stefan-R75/STM32-Nucleo-RS232-RS485-Expansion-Board-ST-Zio-and-Arduino-Compatible/04-Pictures/3D_Render_1.jpg

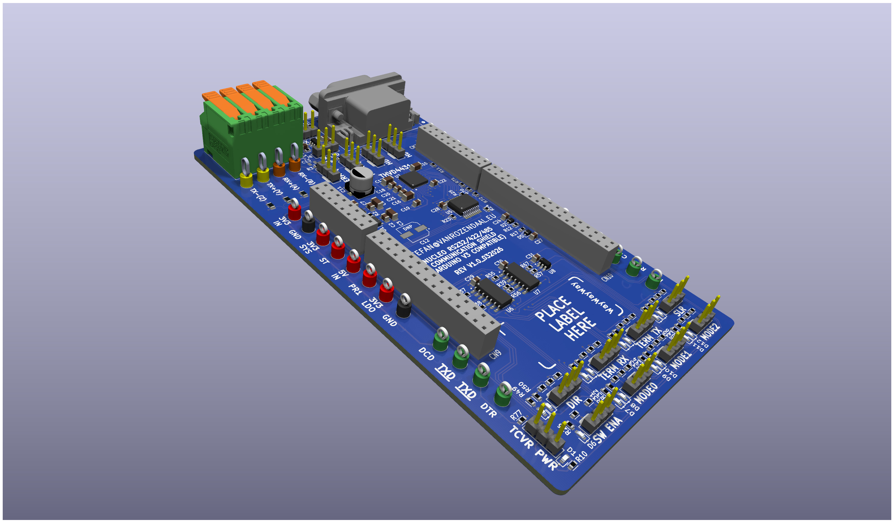
04-Pictures/3D_Render_1.jpg
