stefan-R75/STM32-Nucleo-RS232-RS485-Expansion-Board-ST-Zio-and-Arduino-Compatible/01_KiCAD/06_design_rules/01_jlcpcb/README.md

<!DOCTYPE html>
<html
  lang="en"
  
  data-color-mode="auto" data-light-theme="light" data-dark-theme="dark"
  data-a11y-animated-images="system" data-a11y-link-underlines="true"
  
  >

    <style>
:root {
  --fontStack-monospace: "Monaspace Neon", ui-monospace, SFMono-Regular, SF Mono, Menlo, Consolas, Liberation Mono, monospace !important;
}
</style>

  <head>
    <meta charset="utf-8">
  <link rel="dns-prefetch" href="https://github.githubassets.com">
  <link rel="dns-prefetch" href="https://avatars.githubusercontent.com">
  <link rel="dns-prefetch" href="https://github-cloud.s3.amazonaws.com">
  <link rel="dns-prefetch" href="https://user-images.githubusercontent.com/">
  <link rel="preconnect" href="https://github.githubassets.com" crossorigin>
  <link rel="preconnect" href="https://avatars.githubusercontent.com">

  <link crossorigin="anonymous" media="all" rel="stylesheet" href="https://github.githubassets.com/assets/light-7a548c73f231168f.css" /><link crossorigin="anonymous" media="all" rel="stylesheet" href="https://github.githubassets.com/assets/dark-a037c5198a3956d3.css" /><link data-color-theme="light_high_contrast" crossorigin="anonymous" media="all" rel="stylesheet" data-href="https://github.githubassets.com/assets/light_high_contrast-6d5205ba83e64657.css" /><link data-color-theme="light_colorblind" crossorigin="anonymous" media="all" rel="stylesheet" data-href="https://github.githubassets.com/assets/light_colorblind-92d1f03520a71f42.css" /><link data-color-theme="light_colorblind_high_contrast" crossorigin="anonymous" media="all" rel="stylesheet" data-href="https://github.githubassets.com/assets/light_colorblind_high_contrast-df96da265a7bd744.css" /><link data-color-theme="light_tritanopia" crossorigin="anonymous" media="all" rel="stylesheet" data-href="https://github.githubassets.com/assets/light_tritanopia-6db3b080ed072628.css" /><link data-color-theme="light_tritanopia_high_contrast" crossorigin="anonymous" media="all" rel="stylesheet" data-href="https://github.githubassets.com/assets/light_tritanopia_high_contrast-90fe1d4276b4e140.css" /><link data-color-theme="dark_high_contrast" crossorigin="anonymous" media="all" rel="stylesheet" data-href="https://github.githubassets.com/assets/dark_high_contrast-c4cd957551b6a79f.css" /><link data-color-theme="dark_colorblind" crossorigin="anonymous" media="all" rel="stylesheet" data-href="https://github.githubassets.com/assets/dark_colorblind-07a599f014ccb7af.css" /><link data-color-theme="dark_colorblind_high_contrast" crossorigin="anonymous" media="all" rel="stylesheet" data-href="https://github.githubassets.com/assets/dark_colorblind_high_contrast-c82f4bc8e6fa1496.css" /><link data-color-theme="dark_tritanopia" crossorigin="anonymous" media="all" rel="stylesheet" data-href="https://github.githubassets.com/assets/dark_tritanopia-c7f850982eb2d6ef.css" /><link data-color-theme="dark_tritanopia_high_contrast" crossorigin="anonymous" media="all" rel="stylesheet" data-href="https://github.githubassets.com/assets/dark_tritanopia_high_contrast-bb5b3e819015bc33.css" /><link data-color-theme="dark_dimmed" crossorigin="anonymous" media="all" rel="stylesheet" data-href="https://github.githubassets.com/assets/dark_dimmed-5371e55576aee699.css" /><link data-color-theme="dark_dimmed_high_contrast" crossorigin="anonymous" media="all" rel="stylesheet" data-href="https://github.githubassets.com/assets/dark_dimmed_high_contrast-4db2d2a5d2d86648.css" />

  <style type="text/css">
    :root {
      --tab-size-preference: 4;
    }

    pre, code {
      tab-size: var(--tab-size-preference);
    }
  </style>

    <link crossorigin="anonymous" media="all" rel="stylesheet" href="https://github.githubassets.com/assets/primer-primitives-2c5f58bae956fa96.css" />
    <link crossorigin="anonymous" media="all" rel="stylesheet" href="https://github.githubassets.com/assets/primer-b97936554294d7a3.css" />
    <link crossorigin="anonymous" media="all" rel="stylesheet" href="https://github.githubassets.com/assets/global-5d300701a37a830a.css" />
    <link crossorigin="anonymous" media="all" rel="stylesheet" href="https://github.githubassets.com/assets/github-294399c8d5b652c5.css" />
  <link crossorigin="anonymous" media="all" rel="stylesheet" href="https://github.githubassets.com/assets/repository-c2a686ef3f37f3e5.css" />
<link crossorigin="anonymous" media="all" rel="stylesheet" href="https://github.githubassets.com/assets/code-67953c77b47fec3b.css" />

  <script type="application/json" id="client-env">{"locale":"en","featureFlags":["a11y_status_checks_ruleset","action_yml_language_service","actions_custom_images_public_preview_visibility","actions_custom_images_storage_billing_ui_visibility","actions_enable_snapshot_keyword","actions_image_version_event","actions_workflow_language_service","actions_workflow_language_service_allow_case_function","agent_session_retry_fetch_capi_on_401","alternate_user_config_repo","api_insights_show_missing_data_banner","arianotify_comprehensive_migration","batch_suggested_changes","billing_hard_budget_limits_for_licenses","billing_ui_budget_pagination_enabled","codeowners_validation_in_diff","codespaces_prebuild_region_target_update","coding_agent_model_selection","copilot_3p_agent_hovercards","copilot_agent_sessions_alive_updates","copilot_agent_task_list_v2","copilot_agent_task_submit_with_modifier","copilot_agent_tasks_btn_code_nav","copilot_agent_tasks_btn_code_view","copilot_agent_tasks_btn_code_view_lines","copilot_agent_tasks_btn_repo","copilot_api_agentic_issue_marshal_yaml","copilot_ask_mode_dropdown","copilot_capi_error_response_telemetry","copilot_chat_attach_multiple_images","copilot_chat_clear_model_selection_for_default_change","copilot_chat_disable_model_picker_while_streaming","copilot_chat_enable_tool_call_logs","copilot_chat_file_redirect","copilot_chat_input_commands","copilot_chat_opening_thread_switch","copilot_chat_reduce_quota_checks","copilot_chat_repository_picker","copilot_chat_search_bar_redirect","copilot_chat_selection_attachments","copilot_chat_vision_in_claude","copilot_chat_vision_preview_gate","copilot_coding_agent_free_users_exp","copilot_coding_agent_task_response","copilot_custom_copilots","copilot_custom_copilots_feature_preview","copilot_duplicate_thread","copilot_extensions_hide_in_dotcom_chat","copilot_extensions_removal_on_marketplace","copilot_features_raycast_logo","copilot_features_sql_server_logo","copilot_features_zed_logo","copilot_file_block_ref_matching","copilot_ftp_hyperspace_upgrade_prompt","copilot_icebreakers_experiment_dashboard","copilot_icebreakers_experiment_hyperspace","copilot_immersive_job_result_preview","copilot_immersive_structured_model_picker","copilot_immersive_task_hyperlinking","copilot_immersive_task_within_chat_thread","copilot_issue_list_show_more","copilot_mc_cli_resume_any_users_task","copilot_org_policy_page_focus_mode","copilot_premium_request_quotas","copilot_redirect_header_button_to_agents","copilot_security_alert_assignee_options","copilot_share_active_subthread","copilot_spaces_ga","copilot_spaces_individual_policies_ga","copilot_spaces_pagination","copilot_spaces_server_side_menu_actions","copilot_spark_empty_state","copilot_spark_handle_nil_friendly_name","copilot_stable_conversation_view","copilot_swe_agent_use_subagents","copilot_unconfigured_is_inherited","custom_instructions_file_references","custom_properties_consolidate_default_value_input","dashboard_indexeddb_caching","dashboard_lists_max_age_filter","dashboard_universe_2025","dashboard_universe_2025_feedback_dialog","disable_turbo_visit","dom_node_counts","enterprise_ai_controls","failbot_report_error_react_apps_on_page","fgpat_permissions_selector_redesign","file_finder_skip_debounce","flex_cta_groups_mvp","github_models_scheduled_hydro_events","global_nav_react","hide_groups_list_for_few_groups","hyperspace_2025_logged_out_batch_1","hyperspace_2025_logged_out_batch_2","initial_per_page_pagination_updates","issue_comment_pinning","issue_fields_compact_view","issue_fields_global_search","issue_fields_report_usage","issue_fields_timeline_events","issues_cca_assign_actor_with_agent","issues_expanded_file_types","issues_index_semantic_search","issues_lazy_load_comment_box_suggestions","issues_react_auto_retry_on_error","issues_react_bots_timeline_pagination","issues_react_chrome_container_query_fix","issues_react_custom_hpc_metric","issues_react_include_bots_in_pickers","issues_react_low_quality_comment_warning","issues_react_prohibit_title_fallback","issues_react_resource_metrics","issues_react_safari_scroll_preservation","issues_react_ui_feedback","issues_react_use_turbo_for_cross_repo_navigation","issues_report_sidebar_interactions","landing_pages_ninetailed","lifecycle_label_name_updates","marketing_pages_search_explore_provider","memex_default_issue_create_repository","memex_display_button_config_menu","memex_grouped_by_edit_route","memex_live_update_hovercard","memex_mwl_filter_field_delimiter","memex_roadmap_drag_style","mission_control_retry_on_401","mission_control_use_body_html","open_agent_session_in_vscode_insiders","open_agent_session_in_vscode_stable","pr_sfv_new_diff_fetch","primer_react_css_has_selector_perf","projects_assignee_max_limit","prs_conversations_react","pull_request_files_accurate_size_estimates","pull_request_files_virtualization","pull_request_virtualization_preload_diffs","react_quality_profiling","repo_picker_client_caching","repository_suggester_elastic_search","ruleset_deletion_confirmation","sample_network_conn_type","session_logs_ungroup_reasoning_text","site_calculator_actions_2025","site_features_copilot_universe","site_homepage_collaborate_video","spark_prompt_secret_scanning","spark_server_connection_status","suppress_automated_browser_vitals","suppress_non_representative_vitals","swe_agent_member_requests","swe_agent_member_requests_agent_panel","viewscreen_sandbox","webp_support","workbench_store_readonly"],"login":"stefan-R75","copilotApiOverrideUrl":"https://api.individual.githubcopilot.com"}</script>
<script crossorigin="anonymous" type="module" src="https://github.githubassets.com/assets/wp-runtime-a365739c073e005e.js" defer="defer"></script>
<script crossorigin="anonymous" type="module" src="https://github.githubassets.com/assets/19762-81d8d5b6d1548747.js" defer="defer"></script>
<script crossorigin="anonymous" type="module" src="https://github.githubassets.com/assets/49863-4976e709f3e70037.js" defer="defer"></script>
<script crossorigin="anonymous" type="module" src="https://github.githubassets.com/assets/22060-65b6ab518146f610.js" defer="defer"></script>
<script crossorigin="anonymous" type="module" src="https://github.githubassets.com/assets/environment-a51d75132b05ab62.js" defer="defer"></script>
<script crossorigin="anonymous" type="module" src="https://github.githubassets.com/assets/2966-17a81e258d07c2f2.js" defer="defer"></script>
<script crossorigin="anonymous" type="module" src="https://github.githubassets.com/assets/96232-b9d545f230321d7c.js" defer="defer"></script>
<script crossorigin="anonymous" type="module" src="https://github.githubassets.com/assets/41013-a3ad6242e7f8e42a.js" defer="defer"></script>
<script crossorigin="anonymous" type="module" src="https://github.githubassets.com/assets/51210-6b5503327f030bf0.js" defer="defer"></script>
<script crossorigin="anonymous" type="module" src="https://github.githubassets.com/assets/41121-687180e90512ebb8.js" defer="defer"></script>
<script crossorigin="anonymous" type="module" src="https://github.githubassets.com/assets/2302-893769a03771e2b9.js" defer="defer"></script>
<script crossorigin="anonymous" type="module" src="https://github.githubassets.com/assets/46740-4a90f6808789c7e0.js" defer="defer"></script>
<script crossorigin="anonymous" type="module" src="https://github.githubassets.com/assets/20425-e0dc13f26c8ee149.js" defer="defer"></script>
<script crossorigin="anonymous" type="module" src="https://github.githubassets.com/assets/github-elements-47afb2cc6f88f2ab.js" defer="defer"></script>
<script crossorigin="anonymous" type="module" src="https://github.githubassets.com/assets/element-registry-00d059a39bc367bc.js" defer="defer"></script>
<script crossorigin="anonymous" type="module" src="https://github.githubassets.com/assets/react-core-9e65dba44886edf0.js" defer="defer"></script>
<script crossorigin="anonymous" type="module" src="https://github.githubassets.com/assets/react-lib-2f71bc80da1778d4.js" defer="defer"></script>
<script crossorigin="anonymous" type="module" src="https://github.githubassets.com/assets/7053-ac767626dd950bdd.js" defer="defer"></script>
<script crossorigin="anonymous" type="module" src="https://github.githubassets.com/assets/79039-9993689954cc2834.js" defer="defer"></script>
<script crossorigin="anonymous" type="module" src="https://github.githubassets.com/assets/61110-4d1f28b4f7de000b.js" defer="defer"></script>
<script crossorigin="anonymous" type="module" src="https://github.githubassets.com/assets/2887-e2ef3aca87cf3cff.js" defer="defer"></script>
<script crossorigin="anonymous" type="module" src="https://github.githubassets.com/assets/26533-62506039554211c5.js" defer="defer"></script>
<script crossorigin="anonymous" type="module" src="https://github.githubassets.com/assets/62249-3d8ecc3d46f0dc4a.js" defer="defer"></script>
<script crossorigin="anonymous" type="module" src="https://github.githubassets.com/assets/16674-c6884f27fffb8eee.js" defer="defer"></script>
<script crossorigin="anonymous" type="module" src="https://github.githubassets.com/assets/55821-8df7f70f24788ba2.js" defer="defer"></script>
<script crossorigin="anonymous" type="module" src="https://github.githubassets.com/assets/84184-d5f38c738dddc6e7.js" defer="defer"></script>
<script crossorigin="anonymous" type="module" src="https://github.githubassets.com/assets/91160-58ac38733522873c.js" defer="defer"></script>
<script crossorigin="anonymous" type="module" src="https://github.githubassets.com/assets/68160-4d147b4adc4e3757.js" defer="defer"></script>
<script crossorigin="anonymous" type="module" src="https://github.githubassets.com/assets/34391-4b927fa8f60ebdd2.js" defer="defer"></script>
<script crossorigin="anonymous" type="module" src="https://github.githubassets.com/assets/64453-778588b08614a898.js" defer="defer"></script>
<script crossorigin="anonymous" type="module" src="https://github.githubassets.com/assets/behaviors-49e32172e06825b6.js" defer="defer"></script>
<script crossorigin="anonymous" type="module" src="https://github.githubassets.com/assets/20475-125b055bc62d02e3.js" defer="defer"></script>
<script crossorigin="anonymous" type="module" src="https://github.githubassets.com/assets/notifications-global-9526169739e19e0a.js" defer="defer"></script>
<script crossorigin="anonymous" type="module" src="https://github.githubassets.com/assets/76181-bad0aa2ff68caeb2.js" defer="defer"></script>
<script crossorigin="anonymous" type="module" src="https://github.githubassets.com/assets/code-menu-14eaaf06a02cae17.js" defer="defer"></script>
  
  <script crossorigin="anonymous" type="module" src="https://github.githubassets.com/assets/primer-react-bd93e22e75e0b7a2.js" defer="defer"></script>
<script crossorigin="anonymous" type="module" src="https://github.githubassets.com/assets/octicons-react-f88f2996e968d31d.js" defer="defer"></script>
<script crossorigin="anonymous" type="module" src="https://github.githubassets.com/assets/59660-74e5b93a98c36f57.js" defer="defer"></script>
<script crossorigin="anonymous" type="module" src="https://github.githubassets.com/assets/73694-4020602e6b8b6e13.js" defer="defer"></script>
<script crossorigin="anonymous" type="module" src="https://github.githubassets.com/assets/68751-1d7b85d6d952dbeb.js" defer="defer"></script>
<script crossorigin="anonymous" type="module" src="https://github.githubassets.com/assets/42688-ce4eea125110d8c4.js" defer="defer"></script>
<script crossorigin="anonymous" type="module" src="https://github.githubassets.com/assets/15272-0e93006cf5d4b667.js" defer="defer"></script>
<script crossorigin="anonymous" type="module" src="https://github.githubassets.com/assets/7463-f3550706c43a8cd5.js" defer="defer"></script>
<script crossorigin="anonymous" type="module" src="https://github.githubassets.com/assets/32769-d7b78ad1b9c022ed.js" defer="defer"></script>
<script crossorigin="anonymous" type="module" src="https://github.githubassets.com/assets/437-b726f2206404264f.js" defer="defer"></script>
<script crossorigin="anonymous" type="module" src="https://github.githubassets.com/assets/47857-a5fc3b92dbb7278c.js" defer="defer"></script>
<script crossorigin="anonymous" type="module" src="https://github.githubassets.com/assets/58110-ef430145b4fc3b77.js" defer="defer"></script>
<script crossorigin="anonymous" type="module" src="https://github.githubassets.com/assets/18549-fb0f941364febc57.js" defer="defer"></script>
<script crossorigin="anonymous" type="module" src="https://github.githubassets.com/assets/97083-8d6325e76f8402c7.js" defer="defer"></script>
<script crossorigin="anonymous" type="module" src="https://github.githubassets.com/assets/77691-091e7e8d11233aa1.js" defer="defer"></script>
<script crossorigin="anonymous" type="module" src="https://github.githubassets.com/assets/46376-21b0e1dc12f92ddb.js" defer="defer"></script>
<script crossorigin="anonymous" type="module" src="https://github.githubassets.com/assets/6102-23ba622d2360462d.js" defer="defer"></script>
<script crossorigin="anonymous" type="module" src="https://github.githubassets.com/assets/84085-4bff88a8b3cf217b.js" defer="defer"></script>
<script crossorigin="anonymous" type="module" src="https://github.githubassets.com/assets/82048-6f4561ed285c5d22.js" defer="defer"></script>
<script crossorigin="anonymous" type="module" src="https://github.githubassets.com/assets/99028-9e8e295ec8de3c0a.js" defer="defer"></script>
<script crossorigin="anonymous" type="module" src="https://github.githubassets.com/assets/81482-5951601d24d6ec3f.js" defer="defer"></script>
<script crossorigin="anonymous" type="module" src="https://github.githubassets.com/assets/32288-2b443a3b5410e033.js" defer="defer"></script>
<script crossorigin="anonymous" type="module" src="https://github.githubassets.com/assets/78967-f3b25a47b1862381.js" defer="defer"></script>
<script crossorigin="anonymous" type="module" src="https://github.githubassets.com/assets/69395-61f7f68481a24cfa.js" defer="defer"></script>
<script crossorigin="anonymous" type="module" src="https://github.githubassets.com/assets/51705-9c9f7530ce22860c.js" defer="defer"></script>
<script crossorigin="anonymous" type="module" src="https://github.githubassets.com/assets/23270-caee1ec46352845c.js" defer="defer"></script>
<script crossorigin="anonymous" type="module" src="https://github.githubassets.com/assets/21463-1024f763b5e922f3.js" defer="defer"></script>
<script crossorigin="anonymous" type="module" src="https://github.githubassets.com/assets/67894-d761b3666444400a.js" defer="defer"></script>
<script crossorigin="anonymous" type="module" src="https://github.githubassets.com/assets/64899-bf6a14d23de43ea4.js" defer="defer"></script>
<script crossorigin="anonymous" type="module" src="https://github.githubassets.com/assets/15460-51599d3455597c0b.js" defer="defer"></script>
<script crossorigin="anonymous" type="module" src="https://github.githubassets.com/assets/50343-6db70a288422cd9d.js" defer="defer"></script>
<script crossorigin="anonymous" type="module" src="https://github.githubassets.com/assets/10870-ee22522d2567012c.js" defer="defer"></script>
<script crossorigin="anonymous" type="module" src="https://github.githubassets.com/assets/16920-bd17157a7dc06d8a.js" defer="defer"></script>
<script crossorigin="anonymous" type="module" src="https://github.githubassets.com/assets/react-code-view-a38e5fae44e32b01.js" defer="defer"></script>
<link crossorigin="anonymous" media="all" rel="stylesheet" href="https://github.githubassets.com/assets/primer-react.2b2a53c0ee686cca.module.css" />
<link crossorigin="anonymous" media="all" rel="stylesheet" href="https://github.githubassets.com/assets/16920.2b8819cf0686bcce.module.css" />
<link crossorigin="anonymous" media="all" rel="stylesheet" href="https://github.githubassets.com/assets/react-code-view.1fa961d2ce6eca73.module.css" />

  <title>KiCad-DesignRules/JLCPCB/README.md at main · labtroll/KiCad-DesignRules</title>

  <meta name="route-pattern" content="/:user_id/:repository/blob/*name(/*path)" data-turbo-transient>
  <meta name="route-controller" content="blob" data-turbo-transient>
  <meta name="route-action" content="show" data-turbo-transient>
  <meta name="fetch-nonce" content="v2:77e527d9-4628-d5ec-2935-2bac5924399e">

  <meta name="current-catalog-service-hash" content="f3abb0cc802f3d7b95fc8762b94bdcb13bf39634c40c357301c4aa1d67a256fb">

  <meta name="request-id" content="29DA:105EAB:24193A9:1BFB843:6988A18A" data-turbo-transient="true" /><meta name="html-safe-nonce" content="44650263f7b207255abc338ca9ca1fe72b3509a761cd1f3fd2103b169035779b" data-turbo-transient="true" /><meta name="visitor-payload" content="eyJyZWZlcnJlciI6bnVsbCwicmVxdWVzdF9pZCI6IjI5REE6MTA1RUFCOjI0MTkzQTk6MUJGQjg0Mzo2OTg4QTE4QSIsInZpc2l0b3JfaWQiOiI3OTQ4NTI3NTQ5MzEyMTA3MTY3IiwicmVnaW9uX2VkZ2UiOiJmcmEiLCJyZWdpb25fcmVuZGVyIjoiaWFkIn0=" data-turbo-transient="true" /><meta name="visitor-hmac" content="4d92192ea0aa14b43ddfdb597fb6b93d4a2d25d4c0c42d353baec3ecd39639f1" data-turbo-transient="true" />

    <meta name="hovercard-subject-tag" content="repository:707325958" data-turbo-transient>

  <meta name="github-keyboard-shortcuts" content="repository,source-code,file-tree,copilot" data-turbo-transient="true" />

  <meta name="selected-link" value="repo_source" data-turbo-transient>
  <link rel="assets" href="https://github.githubassets.com/">

    <meta name="google-site-verification" content="Apib7-x98H0j5cPqHWwSMm6dNU4GmODRoqxLiDzdx9I">

<meta name="octolytics-url" content="https://collector.github.com/github/collect" /><meta name="octolytics-actor-id" content="143539033" /><meta name="octolytics-actor-login" content="stefan-R75" /><meta name="octolytics-actor-hash" content="dad007f8bda0fbb8aeee6f8d2f37120cbe373ef1ef59173fdea4cbeae251cd0e" />

  <meta name="analytics-location" content="/&lt;user-name&gt;/&lt;repo-name&gt;/blob/show" data-turbo-transient="true" />

    <meta name="user-login" content="stefan-R75">

  <link rel="sudo-modal" href="/sessions/sudo_modal">

    <meta name="viewport" content="width=device-width">

      <meta name="description" content="JLCPCB Design Rules implemented as Custom Rules in a .kicad_dru file - KiCad-DesignRules/JLCPCB/README.md at main · labtroll/KiCad-DesignRules">

      <link rel="search" type="application/opensearchdescription+xml" href="/opensearch.xml" title="GitHub">

    <link rel="fluid-icon" href="https://github.com/fluidicon.png" title="GitHub">
    <meta property="fb:app_id" content="1401488693436528">
    <meta name="apple-itunes-app" content="app-id=1477376905, app-argument=https://github.com/labtroll/KiCad-DesignRules/blob/main/JLCPCB/README.md" />

      <meta name="twitter:image" content="https://opengraph.githubassets.com/c485022d63268e68967d5fdd4d90edf50c94739bc805dd78f24c9c485822f8bf/labtroll/KiCad-DesignRules" /><meta name="twitter:site" content="@github" /><meta name="twitter:card" content="summary_large_image" /><meta name="twitter:title" content="KiCad-DesignRules/JLCPCB/README.md at main · labtroll/KiCad-DesignRules" /><meta name="twitter:description" content="JLCPCB Design Rules implemented as Custom Rules in a .kicad_dru file - labtroll/KiCad-DesignRules" />
  <meta property="og:image" content="https://opengraph.githubassets.com/c485022d63268e68967d5fdd4d90edf50c94739bc805dd78f24c9c485822f8bf/labtroll/KiCad-DesignRules" /><meta property="og:image:alt" content="JLCPCB Design Rules implemented as Custom Rules in a .kicad_dru file - labtroll/KiCad-DesignRules" /><meta property="og:image:width" content="1200" /><meta property="og:image:height" content="600" /><meta property="og:site_name" content="GitHub" /><meta property="og:type" content="object" /><meta property="og:title" content="KiCad-DesignRules/JLCPCB/README.md at main · labtroll/KiCad-DesignRules" /><meta property="og:url" content="https://github.com/labtroll/KiCad-DesignRules/blob/main/JLCPCB/README.md" /><meta property="og:description" content="JLCPCB Design Rules implemented as Custom Rules in a .kicad_dru file - labtroll/KiCad-DesignRules" />

      <link rel="shared-web-socket" href="wss://alive.github.com/_sockets/u/143539033/ws?session=eyJ2IjoiVjMiLCJ1IjoxNDM1MzkwMzMsInMiOjE5NTgxMDQ5ODUsImMiOjY2NTMyNTI4MiwidCI6MTc3MDU2MTkzOX0=--2d488f9127d47159ba9c84ce60b51c6318aac336dd77a62158bb0e0a54b522e5" data-refresh-url="/_alive" data-session-id="aa5893bf591d7a5fc4c6648f3ebbf1db6b44a33b65be285162e9d33f139651c2">
      <link rel="shared-web-socket-src" href="/assets-cdn/worker/socket-worker-f5e0d666a0d1de44.js">

      <meta name="hostname" content="github.com">

      <meta name="keyboard-shortcuts-preference" content="all">
      <meta name="hovercards-preference" content="true">
      <meta name="announcement-preference-hovercard" content="true">

        <meta name="expected-hostname" content="github.com">

  <meta http-equiv="x-pjax-version" content="8ceba48c6a92197c529f47d4f9d45b0b8bc17cf70fdee20196e8a93f9146e912" data-turbo-track="reload">
  <meta http-equiv="x-pjax-csp-version" content="21a43568025709b66240454fc92d4f09335a96863f8ab1c46b4a07f6a5b67102" data-turbo-track="reload">
  <meta http-equiv="x-pjax-css-version" content="7bded8bde79b87d1ddc3c19f5a21b028d09775106bcb77cfabea9853ea14a4eb" data-turbo-track="reload">
  <meta http-equiv="x-pjax-js-version" content="38ec31e8cc99e2ff9dfdb8f1c79b44d05e5fce45b7e96adc4250ef0059f0eb28" data-turbo-track="reload">

  <meta name="turbo-cache-control" content="no-preview" data-turbo-transient="">

      <meta name="turbo-cache-control" content="no-cache" data-turbo-transient>

    <meta data-hydrostats="publish">

  <meta name="go-import" content="github.com/labtroll/KiCad-DesignRules git https://github.com/labtroll/KiCad-DesignRules.git">

  <meta name="octolytics-dimension-user_id" content="147919420" /><meta name="octolytics-dimension-user_login" content="labtroll" /><meta name="octolytics-dimension-repository_id" content="707325958" /><meta name="octolytics-dimension-repository_nwo" content="labtroll/KiCad-DesignRules" /><meta name="octolytics-dimension-repository_public" content="true" /><meta name="octolytics-dimension-repository_is_fork" content="false" /><meta name="octolytics-dimension-repository_network_root_id" content="707325958" /><meta name="octolytics-dimension-repository_network_root_nwo" content="labtroll/KiCad-DesignRules" />

    <meta name="turbo-body-classes" content="logged-in env-production page-responsive">
  <meta name="disable-turbo" content="false">

  <meta name="browser-stats-url" content="https://api.github.com/_private/browser/stats">

  <meta name="browser-errors-url" content="https://api.github.com/_private/browser/errors">

  <meta name="release" content="734a13114c861aff04af5f466b448edfc21edcde">
  <meta name="ui-target" content="canary-1">

  <link rel="mask-icon" href="https://github.githubassets.com/assets/pinned-octocat-093da3e6fa40.svg" color="#000000">
  <link rel="alternate icon" class="js-site-favicon" type="image/png" href="https://github.githubassets.com/favicons/favicon.png">
  <link rel="icon" class="js-site-favicon" type="image/svg+xml" href="https://github.githubassets.com/favicons/favicon.svg" data-base-href="https://github.githubassets.com/favicons/favicon">

<meta name="theme-color" content="#1e2327">
<meta name="color-scheme" content="light dark" />

  <link rel="apple-touch-icon" href="https://github.githubassets.com/assets/apple-touch-icon-92bd46d04241.png">
  <link rel="apple-touch-icon" sizes="180x180" href="https://github.githubassets.com/assets/apple-touch-icon-180x180-a80b8e11abe2.png">
  <meta name="apple-mobile-web-app-title" content="GitHub">

  <link rel="manifest" href="/manifest.json" crossOrigin="use-credentials">

  </head>

  <body class="logged-in env-production page-responsive" style="word-wrap: break-word;" >
    <div data-turbo-body class="logged-in env-production page-responsive" style="word-wrap: break-word;" >

    <div class="position-relative header-wrapper js-header-wrapper ">
      <a href="#start-of-content" data-skip-target-assigned="false" class="p-3 color-bg-accent-emphasis color-fg-on-emphasis show-on-focus js-skip-to-content">Skip to content</a>

      <span data-view-component="true" class="progress-pjax-loader Progress position-fixed width-full">
    <span style="width: 0%;" data-view-component="true" class="Progress-item progress-pjax-loader-bar left-0 top-0 color-bg-accent-emphasis"></span>
</span>      
      
      <link crossorigin="anonymous" media="all" rel="stylesheet" href="https://github.githubassets.com/assets/primer-react.2b2a53c0ee686cca.module.css" />
<link crossorigin="anonymous" media="all" rel="stylesheet" href="https://github.githubassets.com/assets/keyboard-shortcuts-dialog.de31c369308d4093.module.css" />

<react-partial
  partial-name="keyboard-shortcuts-dialog"
  data-ssr="false"
  data-attempted-ssr="false"
  data-react-profiling="true"
>
  
  <script type="application/json" data-target="react-partial.embeddedData">{"props":{"docsUrl":"https://docs.github.com/get-started/accessibility/keyboard-shortcuts"}}</script>
  
</react-partial>

                  <link crossorigin="anonymous" media="all" rel="stylesheet" href="https://github.githubassets.com/assets/primer-react.2b2a53c0ee686cca.module.css" />
<link crossorigin="anonymous" media="all" rel="stylesheet" href="https://github.githubassets.com/assets/global-nav-bar.5863483c38690f03.module.css" />

<react-partial
  partial-name="global-nav-bar"
  data-ssr="true"
  data-attempted-ssr="true"
  data-react-profiling="true"
>
  
  <script type="application/json" data-target="react-partial.embeddedData">{"props":{"contextRegion":{"crumbs":[{"crumb_type":"organization","label":"labtroll","is_root":false,"href":"/labtroll"},{"crumb_type":"repository","label":"KiCad-DesignRules","is_root":false,"href":"/labtroll/KiCad-DesignRules"}],"localNavigation":[{"id":"code","icon":"code","label":"Code","href":"/labtroll/KiCad-DesignRules","selectedLinks":["repo_source","repo_downloads","repo_commits","repo_releases","repo_tags","repo_branches","repo_packages","repo_deployments","repo_attestations"],"popoverTarget":false,"hotkey":"g c","reactNav":{"appTarget":"code-view","anchor":"code-view-repo-link"},"turboNav":{"frame":"repo-content-turbo-frame"}},{"id":"issues","icon":"issue-opened","label":"Issues","href":"/labtroll/KiCad-DesignRules/issues","selectedLinks":["repo_issues","repo_labels","repo_milestones"],"count":5,"popoverTarget":false,"hotkey":"g i","reactNav":{"appTarget":"issues-react","anchor":null},"turboNav":{"frame":"repo-content-turbo-frame"}},{"id":"pull-requests","icon":"git-pull-request","label":"Pull requests","href":"/labtroll/KiCad-DesignRules/pulls","selectedLinks":["repo_pulls","checks"],"count":3,"popoverTarget":false,"hotkey":"g p","reactNav":{"appTarget":null,"anchor":null},"turboNav":{"frame":"repo-content-turbo-frame"}},{"id":"discussions","icon":"comment-discussion","label":"Discussions","href":"/labtroll/KiCad-DesignRules/discussions","selectedLinks":["repo_discussions"],"popoverTarget":false,"hotkey":"g g","reactNav":{"appTarget":null,"anchor":null},"turboNav":{"frame":"repo-content-turbo-frame"}},{"id":"actions","icon":"play","label":"Actions","href":"/labtroll/KiCad-DesignRules/actions","selectedLinks":["repo_actions"],"popoverTarget":false,"hotkey":"g a","reactNav":{"appTarget":null,"anchor":null},"turboNav":{"frame":"repo-content-turbo-frame"}},{"id":"projects","icon":"table","label":"Projects","href":"/labtroll/KiCad-DesignRules/projects","selectedLinks":["repo_projects","new_repo_project","repo_project"],"count":0,"popoverTarget":false,"hotkey":"g b","reactNav":{"appTarget":null,"anchor":null},"turboNav":{"frame":"repo-content-turbo-frame"}},{"id":"security","icon":"shield","label":"Security","href":"/labtroll/KiCad-DesignRules/security","selectedLinks":["security","overview","alerts","policy","token_scanning","code_scanning"],"count":0,"popoverTarget":false,"hotkey":"g s","reactNav":{"appTarget":null,"anchor":null},"turboNav":{"frame":"repo-content-turbo-frame"}},{"id":"insights","icon":"graph","label":"Insights","href":"/labtroll/KiCad-DesignRules/pulse","selectedLinks":["repo_graphs","repo_contributors","dependency_graph","dependabot_updates","pulse","people","community"],"popoverTarget":false,"reactNav":{"appTarget":null,"anchor":null},"turboNav":{"frame":"repo-content-turbo-frame"}}],"selectedLink":"repo_source"},"navMenu":{"home":{"href":"https://github.com/dashboard","hotkey":"g d"},"feed":{"show":false,"href":"https://github.com/feed"},"issues":{"href":"https://github.com/issues","hotkey":"g i"},"pulls":{"href":"https://github.com/pulls","hotkey":"g p"},"contributedRepos":{"show":true,"href":"https://github.com/repos","hotkey":null},"projects":{"href":"https://github.com/projects"},"discussions":{"show":true,"href":"https://github.com/discussions"},"codespaces":{"show":true,"href":"https://github.com/codespaces"},"copilot":{"show":true,"href":"/copilot"},"spark":{"show":false,"href":null},"marketplace":{"show":true,"href":"https://github.com/marketplace"},"mcp":{"show":true,"href":"https://github.com/mcp"},"explore":{"show":true,"href":"https://github.com/explore"},"richContent":{"show":true,"contentUrl":"/_side-panels/global.json","repositoriesSearchUrl":"/_side-panel-items/global/repositories.json"}},"accountSwitchDialog":{"show":false},"globalTransactionalMessage":null,"userMenu":{"owner":{"login":"stefan-R75","name":null,"avatarUrl":"https://avatars.githubusercontent.com/u/143539033?v=4"},"drawerId":"global-user-nav-drawer","lazyLoadItemDataFetchUrl":"/_side-panels/user.json","canAddAccount":true,"addAccountPath":"/login?add_account=1\u0026return_to=https%3A%2F%2Fgithub.com%2Flabtroll%2FKiCad-DesignRules%2Fblob%2Fmain%2FJLCPCB%2FREADME.md","switchAccountPath":"/switch_account","loginAccountPath":"/login?add_account=1","projectsPath":"/stefan-R75?tab=projects","gistsUrl":"https://gist.github.com/mine","docsUrl":"https://docs.github.com","yourEnterpriseUrl":null,"enterpriseSettingsUrl":null,"supportUrl":"https://support.github.com","showAccountSwitcher":true,"showCopilot":true,"showEnterprises":true,"showEnterprise":false,"showGists":true,"showOrganizations":true,"showSponsors":true,"showUpgrade":true,"showFeaturesPreviews":true,"showEnterpriseSettings":false},"createMenu":{"showCreateRepo":true,"showImportRepo":true,"showCodespaces":true,"showSpark":false,"showCodingAgent":false,"showGist":true,"showCreateOrg":true,"showCreateProject":false,"showCreateLegacyProject":false,"showCreateIssue":true,"createProjectUrl":"/stefan-R75?tab=projects","org":null,"owner":"labtroll","repo":"KiCad-DesignRules"},"headerLogo":{"href":"https://github.com/","hotkey":"g d","aria-label":"Homepage "},"notifications":{"hotkey":"g n","indicatorMode":"none","websocketChannel":"eyJjIjoibm90aWZpY2F0aW9uLWNoYW5nZWQ6MTQzNTM5MDMzIiwidCI6MTc3MDU2MTkzOX0=--a917f5afcf028cbdbd35cc01e1f16011ded0ca117255a4114babf1b88724b463","fetchIndicatorSrc":"/notifications/indicator","fetchIndicatorEnabled":true},"issues":{"href":"https://github.com/issues","hotkey":"g i"},"pulls":{"href":"https://github.com/pulls","hotkey":"g p"},"contributedRepos":{"show":true,"href":"https://github.com/repos","hotkey":null},"copilot":{"show":true,"showCopilotTitle":false,"showAgentsButton":false,"copilotChatUrl":"/github-copilot/chat?skip_anchor=true","copilotApiUrl":"https://api.individual.githubcopilot.com","agentsPanel":{"popoverAvailable":true,"repository":{"id":707325958,"name":"KiCad-DesignRules","ownerLogin":"labtroll"},"showNotification":false,"linkToSessionsInRepo":true,"freeUserPopoverAvailable":false}},"search":{"show":true,"searchHotkey":"s,/","showCommandPalette":false,"commandPaletteHotkey":null,"isSearchPage":false,"isJumpToSearch":false,"fragmentsPath":"/_global-navigation/fragments","fragmentsParams":null},"enterpriseBanner":{"show":false}}}</script>
  <div data-target="react-partial.reactRoot"><style data-styled="true" data-styled-version="5.3.11">.lpqgUB{width:32px;height:32px;}/*!sc*/
data-styled.g1[id="Box-sc-62in7e-0"]{content:"lpqgUB,"}/*!sc*/
</style><link rel="preload" as="image" href="https://avatars.githubusercontent.com/u/143539033?v=4&amp;size=64"/><header role="banner" aria-label="Global Navigation Menu" class="GlobalNav styles-module__appHeader__Q_0R99X prc-Stack-Stack-UQ9k6" data-gap="none" data-direction="vertical" data-align="stretch" data-wrap="nowrap" data-justify="start" data-padding="none"><div class="prc-Stack-Stack-UQ9k6" data-direction="horizontal" data-align="center" data-wrap="nowrap" data-justify="center" data-padding="none"><div data-testid="top-nav-left" class="styles-module__left__lKVdYv9 styles-module__withLocalNavigation__HhaHtgj prc-Stack-Stack-UQ9k6" data-gap="condensed" data-direction="horizontal" data-align="stretch" data-wrap="nowrap" data-justify="start" data-padding="normal"><div data-loading-wrapper="true"><button data-component="IconButton" type="button" aria-haspopup="dialog" class="prc-Button-ButtonBase-9n-Xk styles-module__appHeaderButton__Xgl0aEx prc-Button-IconButton-fyge7" data-loading="false" data-no-visuals="true" data-size="medium" data-variant="invisible" aria-labelledby="_R_apb_"><svg aria-hidden="true" focusable="false" class="octicon octicon-three-bars" viewBox="0 0 16 16" width="16" height="16" fill="currentColor" display="inline-block" overflow="visible" style="vertical-align:text-bottom"><path d="M1 2.75A.75.75 0 0 1 1.75 2h12.5a.75.75 0 0 1 0 1.5H1.75A.75.75 0 0 1 1 2.75Zm0 5A.75.75 0 0 1 1.75 7h12.5a.75.75 0 0 1 0 1.5H1.75A.75.75 0 0 1 1 7.75ZM1.75 12h12.5a.75.75 0 0 1 0 1.5H1.75a.75.75 0 0 1 0-1.5Z"></path></svg></button></div><span class="prc-TooltipV2-Tooltip-tLeuB" data-direction="s" aria-hidden="true" id="_R_apb_">Open menu</span><!--$!--><template></template><!--/$--><a data-component="IconButton" type="button" href="https://github.com/" data-hotkey="g d" hotkey="g d" class="prc-Button-ButtonBase-9n-Xk styles-module__appHeaderHome__OBWaKrN prc-Button-IconButton-fyge7" data-loading="false" data-no-visuals="true" data-size="medium" data-variant="invisible" aria-labelledby="_R_4pb_"><svg aria-hidden="true" focusable="false" class="octicon octicon-mark-github" viewBox="0 0 24 24" width="32" height="32" fill="currentColor" display="inline-block" overflow="visible" style="vertical-align:text-bottom"><path d="M12 1C5.923 1 1 5.923 1 12c0 4.867 3.149 8.979 7.521 10.436.55.096.756-.233.756-.522 0-.262-.013-1.128-.013-2.049-2.764.509-3.479-.674-3.699-1.292-.124-.317-.66-1.293-1.127-1.554-.385-.207-.936-.715-.014-.729.866-.014 1.485.797 1.691 1.128.99 1.663 2.571 1.196 3.204.907.096-.715.385-1.196.701-1.471-2.448-.275-5.005-1.224-5.005-5.432 0-1.196.426-2.186 1.128-2.956-.111-.275-.496-1.402.11-2.915 0 0 .921-.288 3.024 1.128a10.193 10.193 0 0 1 2.75-.371c.936 0 1.871.123 2.75.371 2.104-1.43 3.025-1.128 3.025-1.128.605 1.513.221 2.64.111 2.915.701.77 1.127 1.747 1.127 2.956 0 4.222-2.571 5.157-5.019 5.432.399.344.743 1.004.743 2.035 0 1.471-.014 2.654-.014 3.025 0 .289.206.632.756.522C19.851 20.979 23 16.854 23 12c0-6.077-4.922-11-11-11Z"></path></svg></a><span class="prc-TooltipV2-Tooltip-tLeuB" data-direction="s" aria-hidden="true"><span id="_R_4pb_">Homepage <span class="prc-src-InternalVisuallyHidden-2YaI6">(<!-- -->g then d<!-- -->)</span></span><span class="prc-TooltipV2-KeybindingHintContainer-Ymj-3 prc-TooltipV2-HasTextBefore-fdOXj" aria-hidden="true"><kbd class="prc-KeybindingHint-KeybindingHint-qpYIs prc-Text-Text-9mHv3" data-testid="keybinding-hint"><span class="prc-components-Chord-DdhWN prc-components-ChordOnEmphasis-O-4BS prc-components-ChordSmall-c-P-x prc-Text-Text-9mHv3" data-kbd-chord="true"> <span class="prc-src-InternalVisuallyHidden-2YaI6">g</span><span aria-hidden="true">G</span></span><span class="prc-src-InternalVisuallyHidden-2YaI6">then</span> <span class="prc-components-Chord-DdhWN prc-components-ChordOnEmphasis-O-4BS prc-components-ChordSmall-c-P-x prc-Text-Text-9mHv3" data-kbd-chord="true"> <span class="prc-src-InternalVisuallyHidden-2YaI6">d</span><span aria-hidden="true">D</span></span></kbd></span></span></div><div data-testid="top-nav-center" class="styles-module__center__NNVv52E styles-module__withLocalNavigation__HhaHtgj prc-Stack-Stack-UQ9k6" data-gap="condensed" data-direction="horizontal" data-align="stretch" data-wrap="nowrap" data-justify="start" data-padding="normal"><nav class="styles-module__contextRegion__ZPD9HvM prc-Breadcrumbs-BreadcrumbsBase-3Gb-B" aria-label="Breadcrumbs" data-overflow="menu" data-variant="normal"><ol class="prc-Breadcrumbs-BreadcrumbsList-BKjpe"><li class="prc-Breadcrumbs-ItemWrapper-k0NLn"><a class="styles-module__contextCrumb__it6ctiQ prc-Breadcrumbs-Item-jcraJ" href="/labtroll" data-discover="true"><span class="">labtroll</span></a></li><li class="prc-Breadcrumbs-ItemWrapper-k0NLn"><a class="styles-module__contextCrumb__it6ctiQ prc-Breadcrumbs-Item-jcraJ" href="/labtroll/KiCad-DesignRules" data-discover="true"><span class="styles-module__contextCrumbLast__cE7QReI">KiCad-DesignRules</span></a></li></ol></nav><div class="Search-module__searchButtonGroup__hY7L4L5 prc-ButtonGroup-ButtonGroup-vFUrY"><div><a type="button" aria-label="Search or jump to…" class="prc-Button-ButtonBase-9n-Xk styles-module__appHeaderButton__Xgl0aEx Search-module__searchButton__2zFiG0S" data-loading="false" data-size="medium" data-variant="invisible"><span data-component="buttonContent" data-align="center" class="prc-Button-ButtonContent-Iohp5"><span data-component="leadingVisual" class="prc-Button-Visual-YNt2F prc-Button-VisualWrap-E4cnq"><svg aria-hidden="true" focusable="false" class="octicon octicon-search" viewBox="0 0 16 16" width="16" height="16" fill="currentColor" display="inline-block" overflow="visible" style="vertical-align:text-bottom"><path d="M10.68 11.74a6 6 0 0 1-7.922-8.982 6 6 0 0 1 8.982 7.922l3.04 3.04a.749.749 0 0 1-.326 1.275.749.749 0 0 1-.734-.215ZM11.5 7a4.499 4.499 0 1 0-8.997 0A4.499 4.499 0 0 0 11.5 7Z"></path></svg></span><span data-component="text" class="prc-Button-Label-FWkx3"><span class="Search-module__placeholder__Ke68F3b Search-module__text__uLTXutM Search-module__value__BhmdlyU">Type <kbd class="Search-module__kbd__eSZTVni">/</kbd> to search</span></span></span></a></div></div><button data-component="IconButton" type="button" data-hotkey="s,/" class="prc-Button-ButtonBase-9n-Xk styles-module__appHeaderButton__Xgl0aEx Search-module__smallSearchButton__NfoXPtH prc-Button-IconButton-fyge7" data-loading="false" data-no-visuals="true" data-size="medium" data-variant="invisible" aria-labelledby="_R_l9b_"><svg aria-hidden="true" focusable="false" class="octicon octicon-search" viewBox="0 0 16 16" width="16" height="16" fill="currentColor" display="inline-block" overflow="visible" style="vertical-align:text-bottom"><path d="M10.68 11.74a6 6 0 0 1-7.922-8.982 6 6 0 0 1 8.982 7.922l3.04 3.04a.749.749 0 0 1-.326 1.275.749.749 0 0 1-.734-.215ZM11.5 7a4.499 4.499 0 1 0-8.997 0A4.499 4.499 0 0 0 11.5 7Z"></path></svg></button><span class="prc-TooltipV2-Tooltip-tLeuB" data-direction="s" aria-hidden="true"><span id="_R_l9b_">Search or jump to…<span class="prc-src-InternalVisuallyHidden-2YaI6">(<!-- -->s,/<!-- -->)</span></span><span class="prc-TooltipV2-KeybindingHintContainer-Ymj-3 prc-TooltipV2-HasTextBefore-fdOXj" aria-hidden="true"><kbd class="prc-KeybindingHint-KeybindingHint-qpYIs prc-Text-Text-9mHv3" data-testid="keybinding-hint"><span class="prc-components-Chord-DdhWN prc-components-ChordOnEmphasis-O-4BS prc-components-ChordSmall-c-P-x prc-Text-Text-9mHv3" data-kbd-chord="true"> <span class="prc-src-InternalVisuallyHidden-2YaI6">s,/</span><span aria-hidden="true">S,/</span></span></kbd></span></span></div><div data-testid="top-nav-right" class="styles-module__right__S4LjfwU styles-module__withLocalNavigation__HhaHtgj prc-Stack-Stack-UQ9k6" data-gap="condensed" data-direction="horizontal" data-align="center" data-wrap="nowrap" data-justify="start" data-padding="normal"><div data-testid="top-bar-actions" class="hide-sm hide-md prc-Stack-Stack-UQ9k6" data-gap="condensed" data-direction="horizontal" data-align="center" data-wrap="nowrap" data-justify="start" data-padding="none"><span><div class="prc-ButtonGroup-ButtonGroup-vFUrY"><div><a data-component="IconButton" type="button" href="/copilot" class="prc-Button-ButtonBase-9n-Xk styles-module__appHeaderButton__Xgl0aEx prc-Button-IconButton-fyge7" data-loading="false" data-no-visuals="true" data-size="medium" data-variant="invisible" aria-labelledby="_R_kjpb_"><svg aria-hidden="true" focusable="false" class="octicon octicon-copilot" viewBox="0 0 16 16" width="16" height="16" fill="currentColor" display="inline-block" overflow="visible" style="vertical-align:text-bottom"><path d="M7.998 15.035c-4.562 0-7.873-2.914-7.998-3.749V9.338c.085-.628.677-1.686 1.588-2.065.013-.07.024-.143.036-.218.029-.183.06-.384.126-.612-.201-.508-.254-1.084-.254-1.656 0-.87.128-1.769.693-2.484.579-.733 1.494-1.124 2.724-1.261 1.206-.134 2.262.034 2.944.765.05.053.096.108.139.165.044-.057.094-.112.143-.165.682-.731 1.738-.899 2.944-.765 1.23.137 2.145.528 2.724 1.261.566.715.693 1.614.693 2.484 0 .572-.053 1.148-.254 1.656.066.228.098.429.126.612.012.076.024.148.037.218.924.385 1.522 1.471 1.591 2.095v1.872c0 .766-3.351 3.795-8.002 3.795Zm0-1.485c2.28 0 4.584-1.11 5.002-1.433V7.862l-.023-.116c-.49.21-1.075.291-1.727.291-1.146 0-2.059-.327-2.71-.991A3.222 3.222 0 0 1 8 6.303a3.24 3.24 0 0 1-.544.743c-.65.664-1.563.991-2.71.991-.652 0-1.236-.081-1.727-.291l-.023.116v4.255c.419.323 2.722 1.433 5.002 1.433ZM6.762 2.83c-.193-.206-.637-.413-1.682-.297-1.019.113-1.479.404-1.713.7-.247.312-.369.789-.369 1.554 0 .793.129 1.171.308 1.371.162.181.519.379 1.442.379.853 0 1.339-.235 1.638-.54.315-.322.527-.827.617-1.553.117-.935-.037-1.395-.241-1.614Zm4.155-.297c-1.044-.116-1.488.091-1.681.297-.204.219-.359.679-.242 1.614.091.726.303 1.231.618 1.553.299.305.784.54 1.638.54.922 0 1.28-.198 1.442-.379.179-.2.308-.578.308-1.371 0-.765-.123-1.242-.37-1.554-.233-.296-.693-.587-1.713-.7Z"></path><path d="M6.25 9.037a.75.75 0 0 1 .75.75v1.501a.75.75 0 0 1-1.5 0V9.787a.75.75 0 0 1 .75-.75Zm4.25.75v1.501a.75.75 0 0 1-1.5 0V9.787a.75.75 0 0 1 1.5 0Z"></path></svg></a><span class="prc-TooltipV2-Tooltip-tLeuB" data-direction="s" aria-hidden="true" id="_R_kjpb_">Chat with Copilot</span></div><div><button type="button" aria-label="Open Copilot…" aria-haspopup="true" aria-expanded="false" tabindex="0" class="prc-Button-ButtonBase-9n-Xk styles-module__appHeaderButton__Xgl0aEx CopilotItems-module__CopilotMenu__qX4eooY" data-loading="false" data-size="medium" data-variant="invisible" id="_R_54jpb_"><span data-component="buttonContent" data-align="center" class="prc-Button-ButtonContent-Iohp5"><span data-component="leadingVisual" class="prc-Button-Visual-YNt2F prc-Button-VisualWrap-E4cnq"><svg aria-hidden="true" focusable="false" class="octicon octicon-copilot" viewBox="0 0 16 16" width="16" height="16" fill="currentColor" display="inline-block" overflow="visible" style="vertical-align:text-bottom"><path d="M7.998 15.035c-4.562 0-7.873-2.914-7.998-3.749V9.338c.085-.628.677-1.686 1.588-2.065.013-.07.024-.143.036-.218.029-.183.06-.384.126-.612-.201-.508-.254-1.084-.254-1.656 0-.87.128-1.769.693-2.484.579-.733 1.494-1.124 2.724-1.261 1.206-.134 2.262.034 2.944.765.05.053.096.108.139.165.044-.057.094-.112.143-.165.682-.731 1.738-.899 2.944-.765 1.23.137 2.145.528 2.724 1.261.566.715.693 1.614.693 2.484 0 .572-.053 1.148-.254 1.656.066.228.098.429.126.612.012.076.024.148.037.218.924.385 1.522 1.471 1.591 2.095v1.872c0 .766-3.351 3.795-8.002 3.795Zm0-1.485c2.28 0 4.584-1.11 5.002-1.433V7.862l-.023-.116c-.49.21-1.075.291-1.727.291-1.146 0-2.059-.327-2.71-.991A3.222 3.222 0 0 1 8 6.303a3.24 3.24 0 0 1-.544.743c-.65.664-1.563.991-2.71.991-.652 0-1.236-.081-1.727-.291l-.023.116v4.255c.419.323 2.722 1.433 5.002 1.433ZM6.762 2.83c-.193-.206-.637-.413-1.682-.297-1.019.113-1.479.404-1.713.7-.247.312-.369.789-.369 1.554 0 .793.129 1.171.308 1.371.162.181.519.379 1.442.379.853 0 1.339-.235 1.638-.54.315-.322.527-.827.617-1.553.117-.935-.037-1.395-.241-1.614Zm4.155-.297c-1.044-.116-1.488.091-1.681.297-.204.219-.359.679-.242 1.614.091.726.303 1.231.618 1.553.299.305.784.54 1.638.54.922 0 1.28-.198 1.442-.379.179-.2.308-.578.308-1.371 0-.765-.123-1.242-.37-1.554-.233-.296-.693-.587-1.713-.7Z"></path><path d="M6.25 9.037a.75.75 0 0 1 .75.75v1.501a.75.75 0 0 1-1.5 0V9.787a.75.75 0 0 1 .75-.75Zm4.25.75v1.501a.75.75 0 0 1-1.5 0V9.787a.75.75 0 0 1 1.5 0Z"></path></svg></span></span><span data-component="trailingAction" class="prc-Button-Visual-YNt2F prc-Button-VisualWrap-E4cnq"><svg aria-hidden="true" focusable="false" class="octicon octicon-triangle-down" viewBox="0 0 16 16" width="16" height="16" fill="currentColor" display="inline-block" overflow="visible" style="vertical-align:text-bottom"><path d="m4.427 7.427 3.396 3.396a.25.25 0 0 0 .354 0l3.396-3.396A.25.25 0 0 0 11.396 7H4.604a.25.25 0 0 0-.177.427Z"></path></svg></span></button></div></div></span><button type="button" aria-haspopup="true" aria-expanded="false" tabindex="0" class="prc-Button-ButtonBase-9n-Xk GlobalCreateMenu-module__actionMenuButton__B8wKemq" data-loading="false" data-size="medium" data-variant="invisible" aria-labelledby="global-create-menu-tooltip-_R_1jpb_" id="_R_5jpb_"><span data-component="buttonContent" data-align="center" class="prc-Button-ButtonContent-Iohp5"><span data-component="leadingVisual" class="prc-Button-Visual-YNt2F prc-Button-VisualWrap-E4cnq"><svg aria-hidden="true" focusable="false" class="octicon octicon-plus" viewBox="0 0 16 16" width="16" height="16" fill="currentColor" display="inline-block" overflow="visible" style="vertical-align:text-bottom"><path d="M7.75 2a.75.75 0 0 1 .75.75V7h4.25a.75.75 0 0 1 0 1.5H8.5v4.25a.75.75 0 0 1-1.5 0V8.5H2.75a.75.75 0 0 1 0-1.5H7V2.75A.75.75 0 0 1 7.75 2Z"></path></svg></span></span><span data-component="trailingAction" class="prc-Button-Visual-YNt2F prc-Button-VisualWrap-E4cnq"><svg aria-hidden="true" focusable="false" class="octicon octicon-triangle-down" viewBox="0 0 16 16" width="16" height="16" fill="currentColor" display="inline-block" overflow="visible" style="vertical-align:text-bottom"><path d="m4.427 7.427 3.396 3.396a.25.25 0 0 0 .354 0l3.396-3.396A.25.25 0 0 0 11.396 7H4.604a.25.25 0 0 0-.177.427Z"></path></svg></span></button><span class="prc-TooltipV2-Tooltip-tLeuB" data-direction="s" aria-hidden="true" id="global-create-menu-tooltip-_R_1jpb_">Create new...</span><a data-component="IconButton" type="button" href="https://github.com/issues" data-hotkey="g i" class="prc-Button-ButtonBase-9n-Xk styles-module__appHeaderButton__Xgl0aEx prc-Button-IconButton-fyge7" data-loading="false" data-no-visuals="true" data-size="medium" data-variant="invisible" aria-labelledby="_R_63pb_"><svg aria-hidden="true" focusable="false" class="octicon octicon-issue-opened" viewBox="0 0 16 16" width="16" height="16" fill="currentColor" display="inline-block" overflow="visible" style="vertical-align:text-bottom"><path d="M8 9.5a1.5 1.5 0 1 0 0-3 1.5 1.5 0 0 0 0 3Z"></path><path d="M8 0a8 8 0 1 1 0 16A8 8 0 0 1 8 0ZM1.5 8a6.5 6.5 0 1 0 13 0 6.5 6.5 0 0 0-13 0Z"></path></svg></a><span class="prc-TooltipV2-Tooltip-tLeuB" data-direction="s" aria-hidden="true"><span id="_R_63pb_">Issues<span class="prc-src-InternalVisuallyHidden-2YaI6">(<!-- -->g then i<!-- -->)</span></span><span class="prc-TooltipV2-KeybindingHintContainer-Ymj-3 prc-TooltipV2-HasTextBefore-fdOXj" aria-hidden="true"><kbd class="prc-KeybindingHint-KeybindingHint-qpYIs prc-Text-Text-9mHv3" data-testid="keybinding-hint"><span class="prc-components-Chord-DdhWN prc-components-ChordOnEmphasis-O-4BS prc-components-ChordSmall-c-P-x prc-Text-Text-9mHv3" data-kbd-chord="true"> <span class="prc-src-InternalVisuallyHidden-2YaI6">g</span><span aria-hidden="true">G</span></span><span class="prc-src-InternalVisuallyHidden-2YaI6">then</span> <span class="prc-components-Chord-DdhWN prc-components-ChordOnEmphasis-O-4BS prc-components-ChordSmall-c-P-x prc-Text-Text-9mHv3" data-kbd-chord="true"> <span class="prc-src-InternalVisuallyHidden-2YaI6">i</span><span aria-hidden="true">I</span></span></kbd></span></span><a data-component="IconButton" type="button" href="https://github.com/pulls" data-hotkey="g p" class="prc-Button-ButtonBase-9n-Xk styles-module__appHeaderButton__Xgl0aEx prc-Button-IconButton-fyge7" data-loading="false" data-no-visuals="true" data-size="medium" data-variant="invisible" aria-labelledby="_R_a3pb_"><svg aria-hidden="true" focusable="false" class="octicon octicon-git-pull-request" viewBox="0 0 16 16" width="16" height="16" fill="currentColor" display="inline-block" overflow="visible" style="vertical-align:text-bottom"><path d="M1.5 3.25a2.25 2.25 0 1 1 3 2.122v5.256a2.251 2.251 0 1 1-1.5 0V5.372A2.25 2.25 0 0 1 1.5 3.25Zm5.677-.177L9.573.677A.25.25 0 0 1 10 .854V2.5h1A2.5 2.5 0 0 1 13.5 5v5.628a2.251 2.251 0 1 1-1.5 0V5a1 1 0 0 0-1-1h-1v1.646a.25.25 0 0 1-.427.177L7.177 3.427a.25.25 0 0 1 0-.354ZM3.75 2.5a.75.75 0 1 0 0 1.5.75.75 0 0 0 0-1.5Zm0 9.5a.75.75 0 1 0 0 1.5.75.75 0 0 0 0-1.5Zm8.25.75a.75.75 0 1 0 1.5 0 .75.75 0 0 0-1.5 0Z"></path></svg></a><span class="prc-TooltipV2-Tooltip-tLeuB" data-direction="s" aria-hidden="true"><span id="_R_a3pb_">Pull requests<span class="prc-src-InternalVisuallyHidden-2YaI6">(<!-- -->g then p<!-- -->)</span></span><span class="prc-TooltipV2-KeybindingHintContainer-Ymj-3 prc-TooltipV2-HasTextBefore-fdOXj" aria-hidden="true"><kbd class="prc-KeybindingHint-KeybindingHint-qpYIs prc-Text-Text-9mHv3" data-testid="keybinding-hint"><span class="prc-components-Chord-DdhWN prc-components-ChordOnEmphasis-O-4BS prc-components-ChordSmall-c-P-x prc-Text-Text-9mHv3" data-kbd-chord="true"> <span class="prc-src-InternalVisuallyHidden-2YaI6">g</span><span aria-hidden="true">G</span></span><span class="prc-src-InternalVisuallyHidden-2YaI6">then</span> <span class="prc-components-Chord-DdhWN prc-components-ChordOnEmphasis-O-4BS prc-components-ChordSmall-c-P-x prc-Text-Text-9mHv3" data-kbd-chord="true"> <span class="prc-src-InternalVisuallyHidden-2YaI6">p</span><span aria-hidden="true">P</span></span></kbd></span></span><a data-component="IconButton" type="button" href="https://github.com/repos" class="prc-Button-ButtonBase-9n-Xk styles-module__appHeaderButton__Xgl0aEx prc-Button-IconButton-fyge7" data-loading="false" data-no-visuals="true" data-size="medium" data-variant="invisible" aria-labelledby="_R_e3pb_"><svg aria-hidden="true" focusable="false" class="octicon octicon-repo" viewBox="0 0 16 16" width="16" height="16" fill="currentColor" display="inline-block" overflow="visible" style="vertical-align:text-bottom"><path d="M2 2.5A2.5 2.5 0 0 1 4.5 0h8.75a.75.75 0 0 1 .75.75v12.5a.75.75 0 0 1-.75.75h-2.5a.75.75 0 0 1 0-1.5h1.75v-2h-8a1 1 0 0 0-.714 1.7.75.75 0 1 1-1.072 1.05A2.495 2.495 0 0 1 2 11.5Zm10.5-1h-8a1 1 0 0 0-1 1v6.708A2.486 2.486 0 0 1 4.5 9h8ZM5 12.25a.25.25 0 0 1 .25-.25h3.5a.25.25 0 0 1 .25.25v3.25a.25.25 0 0 1-.4.2l-1.45-1.087a.249.249 0 0 0-.3 0L5.4 15.7a.25.25 0 0 1-.4-.2Z"></path></svg></a><span class="prc-TooltipV2-Tooltip-tLeuB" data-direction="s" aria-hidden="true" id="_R_e3pb_">Repositories</span></div><a data-component="IconButton" type="button" href="/notifications" data-hotkey="g n" class="prc-Button-ButtonBase-9n-Xk styles-module__appHeaderButton__Xgl0aEx prc-Button-IconButton-fyge7" data-loading="false" data-no-visuals="true" data-size="medium" data-variant="invisible" aria-labelledby="_R_5pb_"><svg aria-hidden="true" focusable="false" class="octicon octicon-inbox" viewBox="0 0 16 16" width="16" height="16" fill="currentColor" display="inline-block" overflow="visible" style="vertical-align:text-bottom"><path d="M2.8 2.06A1.75 1.75 0 0 1 4.41 1h7.18c.7 0 1.333.417 1.61 1.06l2.74 6.395c.04.093.06.194.06.295v4.5A1.75 1.75 0 0 1 14.25 15H1.75A1.75 1.75 0 0 1 0 13.25v-4.5c0-.101.02-.202.06-.295Zm1.61.44a.25.25 0 0 0-.23.152L1.887 8H4.75a.75.75 0 0 1 .6.3L6.625 10h2.75l1.275-1.7a.75.75 0 0 1 .6-.3h2.863L11.82 2.652a.25.25 0 0 0-.23-.152Zm10.09 7h-2.875l-1.275 1.7a.75.75 0 0 1-.6.3h-3.5a.75.75 0 0 1-.6-.3L4.375 9.5H1.5v3.75c0 .138.112.25.25.25h12.5a.25.25 0 0 0 .25-.25Z"></path></svg></a><span class="prc-TooltipV2-Tooltip-tLeuB" data-direction="s" aria-hidden="true"><span id="_R_5pb_">You have no unread notifications<span class="prc-src-InternalVisuallyHidden-2YaI6">(<!-- -->g then n<!-- -->)</span></span><span class="prc-TooltipV2-KeybindingHintContainer-Ymj-3 prc-TooltipV2-HasTextBefore-fdOXj" aria-hidden="true"><kbd class="prc-KeybindingHint-KeybindingHint-qpYIs prc-Text-Text-9mHv3" data-testid="keybinding-hint"><span class="prc-components-Chord-DdhWN prc-components-ChordOnEmphasis-O-4BS prc-components-ChordSmall-c-P-x prc-Text-Text-9mHv3" data-kbd-chord="true"> <span class="prc-src-InternalVisuallyHidden-2YaI6">g</span><span aria-hidden="true">G</span></span><span class="prc-src-InternalVisuallyHidden-2YaI6">then</span> <span class="prc-components-Chord-DdhWN prc-components-ChordOnEmphasis-O-4BS prc-components-ChordSmall-c-P-x prc-Text-Text-9mHv3" data-kbd-chord="true"> <span class="prc-src-InternalVisuallyHidden-2YaI6">n</span><span aria-hidden="true">N</span></span></kbd></span></span><div class="GlobalNavUserMenu-module__container__BhzB7Vy"><button data-component="IconButton" type="button" aria-haspopup="menu" data-login="stefan-R75" class="prc-Button-ButtonBase-9n-Xk GlobalNavUserMenu-module__anchor__S5WPgNd prc-Button-IconButton-fyge7" data-loading="false" data-no-visuals="true" data-size="medium" data-variant="invisible" aria-labelledby="_R_2npb_">User avatar</button><span class="prc-TooltipV2-Tooltip-tLeuB" data-direction="s" aria-hidden="true" id="_R_2npb_">Open user navigation menu</span></div><!--$!--><template></template><!--/$--><!--$!--><template></template><!--/$--></div></div><h2 class="prc-src-InternalVisuallyHidden-2YaI6">Repository navigation</h2><nav class="prc-components-UnderlineWrapper-eT-Yj LocalNavigation-module__LocalNavigation__Gd3iha6" aria-label="Repository" data-variant="inset"><ul class="prc-components-UnderlineItemList-xKlKC" role="list"><li class="prc-UnderlineNav-UnderlineNavItem-syRjR"><a href="/labtroll/KiCad-DesignRules" aria-current="page" data-hotkey="g c" data-react-nav="code-view" data-react-nav-anchor="code-view-repo-link" data-turbo-frame="repo-content-turbo-frame" class="prc-components-UnderlineItem-7fP-n" data-discover="true"><span data-component="icon"><svg aria-hidden="true" focusable="false" class="octicon octicon-code" viewBox="0 0 16 16" width="16" height="16" fill="currentColor" display="inline-block" overflow="visible" style="vertical-align:text-bottom"><path d="m11.28 3.22 4.25 4.25a.75.75 0 0 1 0 1.06l-4.25 4.25a.749.749 0 0 1-1.275-.326.749.749 0 0 1 .215-.734L13.94 8l-3.72-3.72a.749.749 0 0 1 .326-1.275.749.749 0 0 1 .734.215Zm-6.56 0a.751.751 0 0 1 1.042.018.751.751 0 0 1 .018 1.042L2.06 8l3.72 3.72a.749.749 0 0 1-.326 1.275.749.749 0 0 1-.734-.215L.47 8.53a.75.75 0 0 1 0-1.06Z"></path></svg></span><span data-component="text" data-content="Code">Code</span></a></li><li class="prc-UnderlineNav-UnderlineNavItem-syRjR"><a href="/labtroll/KiCad-DesignRules/issues" data-hotkey="g i" data-react-nav="issues-react" data-turbo-frame="repo-content-turbo-frame" class="prc-components-UnderlineItem-7fP-n" data-discover="true"><span data-component="icon"><svg aria-hidden="true" focusable="false" class="octicon octicon-issue-opened" viewBox="0 0 16 16" width="16" height="16" fill="currentColor" display="inline-block" overflow="visible" style="vertical-align:text-bottom"><path d="M8 9.5a1.5 1.5 0 1 0 0-3 1.5 1.5 0 0 0 0 3Z"></path><path d="M8 0a8 8 0 1 1 0 16A8 8 0 0 1 8 0ZM1.5 8a6.5 6.5 0 1 0 13 0 6.5 6.5 0 0 0-13 0Z"></path></svg></span><span data-component="text" data-content="Issues">Issues</span><span data-component="counter"><span aria-hidden="true" data-variant="secondary" class="prc-CounterLabel-CounterLabel-X-kRU">5</span><span class="prc-VisuallyHidden-VisuallyHidden-Q0qSB"> (<!-- -->5<!-- -->)</span></span></a></li><li class="prc-UnderlineNav-UnderlineNavItem-syRjR"><a href="/labtroll/KiCad-DesignRules/pulls" data-hotkey="g p" data-turbo-frame="repo-content-turbo-frame" class="prc-components-UnderlineItem-7fP-n" data-discover="true"><span data-component="icon"><svg aria-hidden="true" focusable="false" class="octicon octicon-git-pull-request" viewBox="0 0 16 16" width="16" height="16" fill="currentColor" display="inline-block" overflow="visible" style="vertical-align:text-bottom"><path d="M1.5 3.25a2.25 2.25 0 1 1 3 2.122v5.256a2.251 2.251 0 1 1-1.5 0V5.372A2.25 2.25 0 0 1 1.5 3.25Zm5.677-.177L9.573.677A.25.25 0 0 1 10 .854V2.5h1A2.5 2.5 0 0 1 13.5 5v5.628a2.251 2.251 0 1 1-1.5 0V5a1 1 0 0 0-1-1h-1v1.646a.25.25 0 0 1-.427.177L7.177 3.427a.25.25 0 0 1 0-.354ZM3.75 2.5a.75.75 0 1 0 0 1.5.75.75 0 0 0 0-1.5Zm0 9.5a.75.75 0 1 0 0 1.5.75.75 0 0 0 0-1.5Zm8.25.75a.75.75 0 1 0 1.5 0 .75.75 0 0 0-1.5 0Z"></path></svg></span><span data-component="text" data-content="Pull requests">Pull requests</span><span data-component="counter"><span aria-hidden="true" data-variant="secondary" class="prc-CounterLabel-CounterLabel-X-kRU">3</span><span class="prc-VisuallyHidden-VisuallyHidden-Q0qSB"> (<!-- -->3<!-- -->)</span></span></a></li><li class="prc-UnderlineNav-UnderlineNavItem-syRjR"><a href="/labtroll/KiCad-DesignRules/discussions" data-hotkey="g g" data-turbo-frame="repo-content-turbo-frame" class="prc-components-UnderlineItem-7fP-n" data-discover="true"><span data-component="icon"><svg aria-hidden="true" focusable="false" class="octicon octicon-comment-discussion" viewBox="0 0 16 16" width="16" height="16" fill="currentColor" display="inline-block" overflow="visible" style="vertical-align:text-bottom"><path d="M1.75 1h8.5c.966 0 1.75.784 1.75 1.75v5.5A1.75 1.75 0 0 1 10.25 10H7.061l-2.574 2.573A1.458 1.458 0 0 1 2 11.543V10h-.25A1.75 1.75 0 0 1 0 8.25v-5.5C0 1.784.784 1 1.75 1ZM1.5 2.75v5.5c0 .138.112.25.25.25h1a.75.75 0 0 1 .75.75v2.19l2.72-2.72a.749.749 0 0 1 .53-.22h3.5a.25.25 0 0 0 .25-.25v-5.5a.25.25 0 0 0-.25-.25h-8.5a.25.25 0 0 0-.25.25Zm13 2a.25.25 0 0 0-.25-.25h-.5a.75.75 0 0 1 0-1.5h.5c.966 0 1.75.784 1.75 1.75v5.5A1.75 1.75 0 0 1 14.25 12H14v1.543a1.458 1.458 0 0 1-2.487 1.03L9.22 12.28a.749.749 0 0 1 .326-1.275.749.749 0 0 1 .734.215l2.22 2.22v-2.19a.75.75 0 0 1 .75-.75h1a.25.25 0 0 0 .25-.25Z"></path></svg></span><span data-component="text" data-content="Discussions">Discussions</span></a></li><li class="prc-UnderlineNav-UnderlineNavItem-syRjR"><a href="/labtroll/KiCad-DesignRules/actions" data-hotkey="g a" data-turbo-frame="repo-content-turbo-frame" class="prc-components-UnderlineItem-7fP-n" data-discover="true"><span data-component="icon"><svg aria-hidden="true" focusable="false" class="octicon octicon-play" viewBox="0 0 16 16" width="16" height="16" fill="currentColor" display="inline-block" overflow="visible" style="vertical-align:text-bottom"><path d="M8 0a8 8 0 1 1 0 16A8 8 0 0 1 8 0ZM1.5 8a6.5 6.5 0 1 0 13 0 6.5 6.5 0 0 0-13 0Zm4.879-2.773 4.264 2.559a.25.25 0 0 1 0 .428l-4.264 2.559A.25.25 0 0 1 6 10.559V5.442a.25.25 0 0 1 .379-.215Z"></path></svg></span><span data-component="text" data-content="Actions">Actions</span></a></li><li class="prc-UnderlineNav-UnderlineNavItem-syRjR"><a href="/labtroll/KiCad-DesignRules/projects" data-hotkey="g b" data-turbo-frame="repo-content-turbo-frame" class="prc-components-UnderlineItem-7fP-n" data-discover="true"><span data-component="icon"><svg aria-hidden="true" focusable="false" class="octicon octicon-table" viewBox="0 0 16 16" width="16" height="16" fill="currentColor" display="inline-block" overflow="visible" style="vertical-align:text-bottom"><path d="M0 1.75C0 .784.784 0 1.75 0h12.5C15.216 0 16 .784 16 1.75v12.5A1.75 1.75 0 0 1 14.25 16H1.75A1.75 1.75 0 0 1 0 14.25ZM6.5 6.5v8h7.75a.25.25 0 0 0 .25-.25V6.5Zm8-1.5V1.75a.25.25 0 0 0-.25-.25H6.5V5Zm-13 1.5v7.75c0 .138.112.25.25.25H5v-8ZM5 5V1.5H1.75a.25.25 0 0 0-.25.25V5Z"></path></svg></span><span data-component="text" data-content="Projects">Projects</span></a></li><li class="prc-UnderlineNav-UnderlineNavItem-syRjR"><a href="/labtroll/KiCad-DesignRules/security" data-hotkey="g s" data-turbo-frame="repo-content-turbo-frame" class="prc-components-UnderlineItem-7fP-n" data-discover="true"><span data-component="icon"><svg aria-hidden="true" focusable="false" class="octicon octicon-shield" viewBox="0 0 16 16" width="16" height="16" fill="currentColor" display="inline-block" overflow="visible" style="vertical-align:text-bottom"><path d="M7.467.133a1.748 1.748 0 0 1 1.066 0l5.25 1.68A1.75 1.75 0 0 1 15 3.48V7c0 1.566-.32 3.182-1.303 4.682-.983 1.498-2.585 2.813-5.032 3.855a1.697 1.697 0 0 1-1.33 0c-2.447-1.042-4.049-2.357-5.032-3.855C1.32 10.182 1 8.566 1 7V3.48a1.75 1.75 0 0 1 1.217-1.667Zm.61 1.429a.25.25 0 0 0-.153 0l-5.25 1.68a.25.25 0 0 0-.174.238V7c0 1.358.275 2.666 1.057 3.86.784 1.194 2.121 2.34 4.366 3.297a.196.196 0 0 0 .154 0c2.245-.956 3.582-2.104 4.366-3.298C13.225 9.666 13.5 8.36 13.5 7V3.48a.251.251 0 0 0-.174-.237l-5.25-1.68ZM8.75 4.75v3a.75.75 0 0 1-1.5 0v-3a.75.75 0 0 1 1.5 0ZM9 10.5a1 1 0 1 1-2 0 1 1 0 0 1 2 0Z"></path></svg></span><span data-component="text" data-content="Security">Security</span></a></li><li class="prc-UnderlineNav-UnderlineNavItem-syRjR"><a href="/labtroll/KiCad-DesignRules/pulse" data-turbo-frame="repo-content-turbo-frame" class="prc-components-UnderlineItem-7fP-n" data-discover="true"><span data-component="icon"><svg aria-hidden="true" focusable="false" class="octicon octicon-graph" viewBox="0 0 16 16" width="16" height="16" fill="currentColor" display="inline-block" overflow="visible" style="vertical-align:text-bottom"><path d="M1.5 1.75V13.5h13.75a.75.75 0 0 1 0 1.5H.75a.75.75 0 0 1-.75-.75V1.75a.75.75 0 0 1 1.5 0Zm14.28 2.53-5.25 5.25a.75.75 0 0 1-1.06 0L7 7.06 4.28 9.78a.751.751 0 0 1-1.042-.018.751.751 0 0 1-.018-1.042l3.25-3.25a.75.75 0 0 1 1.06 0L10 7.94l4.72-4.72a.751.751 0 0 1 1.042.018.751.751 0 0 1 .018 1.042Z"></path></svg></span><span data-component="text" data-content="Insights">Insights</span></a></li></ul></nav></header><script type="application/json" id="__PRIMER_DATA__R_0___">{"resolvedServerColorMode":"night"}</script></div>
</react-partial>

      <div class="js-global-bar" style="display: none;">

<qbsearch-input class="search-input" data-scope="repo:labtroll/KiCad-DesignRules" data-custom-scopes-path="/search/custom_scopes" data-delete-custom-scopes-csrf="zgL5USYYSvDBYj3UNgZOpxqIs58GOSFNYyC0WPadrtSSr7NM9MgW6-GFa49XBy1fpvjnxCEf0UYTUMZrear56w" data-max-custom-scopes="10" data-header-redesign-enabled="true" data-initial-value="" data-blackbird-suggestions-path="/search/suggestions" data-jump-to-suggestions-path="/_graphql/GetSuggestedNavigationDestinations" data-current-repository="labtroll/KiCad-DesignRules" data-current-org="labtroll" data-current-owner="" data-logged-in="true" data-copilot-chat-enabled="false" data-nl-search-enabled="false">
  <div
    class="search-input-container search-with-dialog position-relative d-flex flex-row flex-items-center height-auto color-bg-transparent border-0 color-fg-subtle mx-0"
    data-action="click:qbsearch-input#searchInputContainerClicked"
  >

    <input type="hidden" name="type" class="js-site-search-type-field">

<div class="Overlay--hidden " data-modal-dialog-overlay>
  <modal-dialog data-action="close:qbsearch-input#handleClose cancel:qbsearch-input#handleClose" data-target="qbsearch-input.searchSuggestionsDialog" role="dialog" id="search-suggestions-dialog" aria-modal="true" aria-labelledby="search-suggestions-dialog-header" data-view-component="true" class="Overlay Overlay--width-medium Overlay--height-auto">
      <h1 id="search-suggestions-dialog-header" class="sr-only">Search code, repositories, users, issues, pull requests...</h1>
    <div class="Overlay-body Overlay-body--paddingNone">
      
          <div data-view-component="true">        <div class="search-suggestions position-absolute width-full color-shadow-large border color-fg-default color-bg-default overflow-hidden d-flex flex-column query-builder-container"
          style="border-radius: 12px;"
          data-target="qbsearch-input.queryBuilderContainer"
          hidden
        >
          <!-- '"` --><!-- </textarea></xmp> --></option></form><form id="query-builder-test-form" action="" accept-charset="UTF-8" method="get">
  <query-builder data-target="qbsearch-input.queryBuilder" id="query-builder-query-builder-test" data-filter-key=":" data-view-component="true" class="QueryBuilder search-query-builder">
    <div class="FormControl FormControl--fullWidth">
      <label id="query-builder-test-label" for="query-builder-test" class="FormControl-label sr-only">
        Search
      </label>
      <div
        class="QueryBuilder-StyledInput width-fit "
        data-target="query-builder.styledInput"
      >
          <span id="query-builder-test-leadingvisual-wrap" class="FormControl-input-leadingVisualWrap QueryBuilder-leadingVisualWrap">
            <svg aria-hidden="true" height="16" viewBox="0 0 16 16" version="1.1" width="16" data-view-component="true" class="octicon octicon-search FormControl-input-leadingVisual">
    <path d="M10.68 11.74a6 6 0 0 1-7.922-8.982 6 6 0 0 1 8.982 7.922l3.04 3.04a.749.749 0 0 1-.326 1.275.749.749 0 0 1-.734-.215ZM11.5 7a4.499 4.499 0 1 0-8.997 0A4.499 4.499 0 0 0 11.5 7Z"></path>
</svg>
          </span>
        <div data-target="query-builder.styledInputContainer" class="QueryBuilder-StyledInputContainer">
          
          <div class="QueryBuilder-InputWrapper">
            
            <input id="query-builder-test" name="query-builder-test" value="" autocomplete="off" type="text" role="combobox" spellcheck="false" aria-expanded="false" aria-describedby="validation-42d8001b-64ca-408d-bd02-55268ff1d565" data-target="query-builder.input" data-action="
          input:query-builder#inputChange
          blur:query-builder#inputBlur
          keydown:query-builder#inputKeydown
          focus:query-builder#inputFocus
        " data-view-component="true" class="FormControl-input QueryBuilder-Input FormControl-medium" />
          </div>
        </div>
          <span class="sr-only" id="query-builder-test-clear">Clear</span>
          <button role="button" id="query-builder-test-clear-button" aria-labelledby="query-builder-test-clear query-builder-test-label" data-target="query-builder.clearButton" data-action="
                click:query-builder#clear
                focus:query-builder#clearButtonFocus
                blur:query-builder#clearButtonBlur
              " variant="small" hidden="hidden" type="button" data-view-component="true" class="Button Button--iconOnly Button--invisible Button--medium mr-1 px-2 py-0 d-flex flex-items-center rounded-1 color-fg-muted">  <svg aria-hidden="true" height="16" viewBox="0 0 16 16" version="1.1" width="16" data-view-component="true" class="octicon octicon-x-circle-fill Button-visual">
    <path d="M2.343 13.657A8 8 0 1 1 13.658 2.343 8 8 0 0 1 2.343 13.657ZM6.03 4.97a.751.751 0 0 0-1.042.018.751.751 0 0 0-.018 1.042L6.94 8 4.97 9.97a.749.749 0 0 0 .326 1.275.749.749 0 0 0 .734-.215L8 9.06l1.97 1.97a.749.749 0 0 0 1.275-.326.749.749 0 0 0-.215-.734L9.06 8l1.97-1.97a.749.749 0 0 0-.326-1.275.749.749 0 0 0-.734.215L8 6.94Z"></path>
</svg>
</button>

      </div>
      <template id="search-icon">
  <svg aria-hidden="true" height="16" viewBox="0 0 16 16" version="1.1" width="16" data-view-component="true" class="octicon octicon-search">
    <path d="M10.68 11.74a6 6 0 0 1-7.922-8.982 6 6 0 0 1 8.982 7.922l3.04 3.04a.749.749 0 0 1-.326 1.275.749.749 0 0 1-.734-.215ZM11.5 7a4.499 4.499 0 1 0-8.997 0A4.499 4.499 0 0 0 11.5 7Z"></path>
</svg>
</template>

<template id="code-icon">
  <svg aria-hidden="true" height="16" viewBox="0 0 16 16" version="1.1" width="16" data-view-component="true" class="octicon octicon-code">
    <path d="m11.28 3.22 4.25 4.25a.75.75 0 0 1 0 1.06l-4.25 4.25a.749.749 0 0 1-1.275-.326.749.749 0 0 1 .215-.734L13.94 8l-3.72-3.72a.749.749 0 0 1 .326-1.275.749.749 0 0 1 .734.215Zm-6.56 0a.751.751 0 0 1 1.042.018.751.751 0 0 1 .018 1.042L2.06 8l3.72 3.72a.749.749 0 0 1-.326 1.275.749.749 0 0 1-.734-.215L.47 8.53a.75.75 0 0 1 0-1.06Z"></path>
</svg>
</template>

<template id="file-code-icon">
  <svg aria-hidden="true" height="16" viewBox="0 0 16 16" version="1.1" width="16" data-view-component="true" class="octicon octicon-file-code">
    <path d="M4 1.75C4 .784 4.784 0 5.75 0h5.586c.464 0 .909.184 1.237.513l2.914 2.914c.329.328.513.773.513 1.237v8.586A1.75 1.75 0 0 1 14.25 15h-9a.75.75 0 0 1 0-1.5h9a.25.25 0 0 0 .25-.25V6h-2.75A1.75 1.75 0 0 1 10 4.25V1.5H5.75a.25.25 0 0 0-.25.25v2.5a.75.75 0 0 1-1.5 0Zm1.72 4.97a.75.75 0 0 1 1.06 0l2 2a.75.75 0 0 1 0 1.06l-2 2a.749.749 0 0 1-1.275-.326.749.749 0 0 1 .215-.734l1.47-1.47-1.47-1.47a.75.75 0 0 1 0-1.06ZM3.28 7.78 1.81 9.25l1.47 1.47a.751.751 0 0 1-.018 1.042.751.751 0 0 1-1.042.018l-2-2a.75.75 0 0 1 0-1.06l2-2a.751.751 0 0 1 1.042.018.751.751 0 0 1 .018 1.042Zm8.22-6.218V4.25c0 .138.112.25.25.25h2.688l-.011-.013-2.914-2.914-.013-.011Z"></path>
</svg>
</template>

<template id="history-icon">
  <svg aria-hidden="true" height="16" viewBox="0 0 16 16" version="1.1" width="16" data-view-component="true" class="octicon octicon-history">
    <path d="m.427 1.927 1.215 1.215a8.002 8.002 0 1 1-1.6 5.685.75.75 0 1 1 1.493-.154 6.5 6.5 0 1 0 1.18-4.458l1.358 1.358A.25.25 0 0 1 3.896 6H.25A.25.25 0 0 1 0 5.75V2.104a.25.25 0 0 1 .427-.177ZM7.75 4a.75.75 0 0 1 .75.75v2.992l2.028.812a.75.75 0 0 1-.557 1.392l-2.5-1A.751.751 0 0 1 7 8.25v-3.5A.75.75 0 0 1 7.75 4Z"></path>
</svg>
</template>

<template id="repo-icon">
  <svg aria-hidden="true" height="16" viewBox="0 0 16 16" version="1.1" width="16" data-view-component="true" class="octicon octicon-repo">
    <path d="M2 2.5A2.5 2.5 0 0 1 4.5 0h8.75a.75.75 0 0 1 .75.75v12.5a.75.75 0 0 1-.75.75h-2.5a.75.75 0 0 1 0-1.5h1.75v-2h-8a1 1 0 0 0-.714 1.7.75.75 0 1 1-1.072 1.05A2.495 2.495 0 0 1 2 11.5Zm10.5-1h-8a1 1 0 0 0-1 1v6.708A2.486 2.486 0 0 1 4.5 9h8ZM5 12.25a.25.25 0 0 1 .25-.25h3.5a.25.25 0 0 1 .25.25v3.25a.25.25 0 0 1-.4.2l-1.45-1.087a.249.249 0 0 0-.3 0L5.4 15.7a.25.25 0 0 1-.4-.2Z"></path>
</svg>
</template>

<template id="bookmark-icon">
  <svg aria-hidden="true" height="16" viewBox="0 0 16 16" version="1.1" width="16" data-view-component="true" class="octicon octicon-bookmark">
    <path d="M3 2.75C3 1.784 3.784 1 4.75 1h6.5c.966 0 1.75.784 1.75 1.75v11.5a.75.75 0 0 1-1.227.579L8 11.722l-3.773 3.107A.751.751 0 0 1 3 14.25Zm1.75-.25a.25.25 0 0 0-.25.25v9.91l3.023-2.489a.75.75 0 0 1 .954 0l3.023 2.49V2.75a.25.25 0 0 0-.25-.25Z"></path>
</svg>
</template>

<template id="plus-circle-icon">
  <svg aria-hidden="true" height="16" viewBox="0 0 16 16" version="1.1" width="16" data-view-component="true" class="octicon octicon-plus-circle">
    <path d="M8 0a8 8 0 1 1 0 16A8 8 0 0 1 8 0ZM1.5 8a6.5 6.5 0 1 0 13 0 6.5 6.5 0 0 0-13 0Zm7.25-3.25v2.5h2.5a.75.75 0 0 1 0 1.5h-2.5v2.5a.75.75 0 0 1-1.5 0v-2.5h-2.5a.75.75 0 0 1 0-1.5h2.5v-2.5a.75.75 0 0 1 1.5 0Z"></path>
</svg>
</template>

<template id="circle-icon">
  <svg aria-hidden="true" height="16" viewBox="0 0 16 16" version="1.1" width="16" data-view-component="true" class="octicon octicon-dot-fill">
    <path d="M8 4a4 4 0 1 1 0 8 4 4 0 0 1 0-8Z"></path>
</svg>
</template>

<template id="trash-icon">
  <svg aria-hidden="true" height="16" viewBox="0 0 16 16" version="1.1" width="16" data-view-component="true" class="octicon octicon-trash">
    <path d="M11 1.75V3h2.25a.75.75 0 0 1 0 1.5H2.75a.75.75 0 0 1 0-1.5H5V1.75C5 .784 5.784 0 6.75 0h2.5C10.216 0 11 .784 11 1.75ZM4.496 6.675l.66 6.6a.25.25 0 0 0 .249.225h5.19a.25.25 0 0 0 .249-.225l.66-6.6a.75.75 0 0 1 1.492.149l-.66 6.6A1.748 1.748 0 0 1 10.595 15h-5.19a1.75 1.75 0 0 1-1.741-1.575l-.66-6.6a.75.75 0 1 1 1.492-.15ZM6.5 1.75V3h3V1.75a.25.25 0 0 0-.25-.25h-2.5a.25.25 0 0 0-.25.25Z"></path>
</svg>
</template>

<template id="team-icon">
  <svg aria-hidden="true" height="16" viewBox="0 0 16 16" version="1.1" width="16" data-view-component="true" class="octicon octicon-people">
    <path d="M2 5.5a3.5 3.5 0 1 1 5.898 2.549 5.508 5.508 0 0 1 3.034 4.084.75.75 0 1 1-1.482.235 4 4 0 0 0-7.9 0 .75.75 0 0 1-1.482-.236A5.507 5.507 0 0 1 3.102 8.05 3.493 3.493 0 0 1 2 5.5ZM11 4a3.001 3.001 0 0 1 2.22 5.018 5.01 5.01 0 0 1 2.56 3.012.749.749 0 0 1-.885.954.752.752 0 0 1-.549-.514 3.507 3.507 0 0 0-2.522-2.372.75.75 0 0 1-.574-.73v-.352a.75.75 0 0 1 .416-.672A1.5 1.5 0 0 0 11 5.5.75.75 0 0 1 11 4Zm-5.5-.5a2 2 0 1 0-.001 3.999A2 2 0 0 0 5.5 3.5Z"></path>
</svg>
</template>

<template id="project-icon">
  <svg aria-hidden="true" height="16" viewBox="0 0 16 16" version="1.1" width="16" data-view-component="true" class="octicon octicon-project">
    <path d="M1.75 0h12.5C15.216 0 16 .784 16 1.75v12.5A1.75 1.75 0 0 1 14.25 16H1.75A1.75 1.75 0 0 1 0 14.25V1.75C0 .784.784 0 1.75 0ZM1.5 1.75v12.5c0 .138.112.25.25.25h12.5a.25.25 0 0 0 .25-.25V1.75a.25.25 0 0 0-.25-.25H1.75a.25.25 0 0 0-.25.25ZM11.75 3a.75.75 0 0 1 .75.75v7.5a.75.75 0 0 1-1.5 0v-7.5a.75.75 0 0 1 .75-.75Zm-8.25.75a.75.75 0 0 1 1.5 0v5.5a.75.75 0 0 1-1.5 0ZM8 3a.75.75 0 0 1 .75.75v3.5a.75.75 0 0 1-1.5 0v-3.5A.75.75 0 0 1 8 3Z"></path>
</svg>
</template>

<template id="pencil-icon">
  <svg aria-hidden="true" height="16" viewBox="0 0 16 16" version="1.1" width="16" data-view-component="true" class="octicon octicon-pencil">
    <path d="M11.013 1.427a1.75 1.75 0 0 1 2.474 0l1.086 1.086a1.75 1.75 0 0 1 0 2.474l-8.61 8.61c-.21.21-.47.364-.756.445l-3.251.93a.75.75 0 0 1-.927-.928l.929-3.25c.081-.286.235-.547.445-.758l8.61-8.61Zm.176 4.823L9.75 4.81l-6.286 6.287a.253.253 0 0 0-.064.108l-.558 1.953 1.953-.558a.253.253 0 0 0 .108-.064Zm1.238-3.763a.25.25 0 0 0-.354 0L10.811 3.75l1.439 1.44 1.263-1.263a.25.25 0 0 0 0-.354Z"></path>
</svg>
</template>

<template id="copilot-icon">
  <svg aria-hidden="true" height="16" viewBox="0 0 16 16" version="1.1" width="16" data-view-component="true" class="octicon octicon-copilot">
    <path d="M7.998 15.035c-4.562 0-7.873-2.914-7.998-3.749V9.338c.085-.628.677-1.686 1.588-2.065.013-.07.024-.143.036-.218.029-.183.06-.384.126-.612-.201-.508-.254-1.084-.254-1.656 0-.87.128-1.769.693-2.484.579-.733 1.494-1.124 2.724-1.261 1.206-.134 2.262.034 2.944.765.05.053.096.108.139.165.044-.057.094-.112.143-.165.682-.731 1.738-.899 2.944-.765 1.23.137 2.145.528 2.724 1.261.566.715.693 1.614.693 2.484 0 .572-.053 1.148-.254 1.656.066.228.098.429.126.612.012.076.024.148.037.218.924.385 1.522 1.471 1.591 2.095v1.872c0 .766-3.351 3.795-8.002 3.795Zm0-1.485c2.28 0 4.584-1.11 5.002-1.433V7.862l-.023-.116c-.49.21-1.075.291-1.727.291-1.146 0-2.059-.327-2.71-.991A3.222 3.222 0 0 1 8 6.303a3.24 3.24 0 0 1-.544.743c-.65.664-1.563.991-2.71.991-.652 0-1.236-.081-1.727-.291l-.023.116v4.255c.419.323 2.722 1.433 5.002 1.433ZM6.762 2.83c-.193-.206-.637-.413-1.682-.297-1.019.113-1.479.404-1.713.7-.247.312-.369.789-.369 1.554 0 .793.129 1.171.308 1.371.162.181.519.379 1.442.379.853 0 1.339-.235 1.638-.54.315-.322.527-.827.617-1.553.117-.935-.037-1.395-.241-1.614Zm4.155-.297c-1.044-.116-1.488.091-1.681.297-.204.219-.359.679-.242 1.614.091.726.303 1.231.618 1.553.299.305.784.54 1.638.54.922 0 1.28-.198 1.442-.379.179-.2.308-.578.308-1.371 0-.765-.123-1.242-.37-1.554-.233-.296-.693-.587-1.713-.7Z"></path><path d="M6.25 9.037a.75.75 0 0 1 .75.75v1.501a.75.75 0 0 1-1.5 0V9.787a.75.75 0 0 1 .75-.75Zm4.25.75v1.501a.75.75 0 0 1-1.5 0V9.787a.75.75 0 0 1 1.5 0Z"></path>
</svg>
</template>

<template id="copilot-error-icon">
  <svg aria-hidden="true" height="16" viewBox="0 0 16 16" version="1.1" width="16" data-view-component="true" class="octicon octicon-copilot-error">
    <path d="M16 11.24c0 .112-.072.274-.21.467L13 9.688V7.862l-.023-.116c-.49.21-1.075.291-1.727.291-.198 0-.388-.009-.571-.029L6.833 5.226a4.01 4.01 0 0 0 .17-.782c.117-.935-.037-1.395-.241-1.614-.193-.206-.637-.413-1.682-.297-.683.076-1.115.231-1.395.415l-1.257-.91c.579-.564 1.413-.877 2.485-.996 1.206-.134 2.262.034 2.944.765.05.053.096.108.139.165.044-.057.094-.112.143-.165.682-.731 1.738-.899 2.944-.765 1.23.137 2.145.528 2.724 1.261.566.715.693 1.614.693 2.484 0 .572-.053 1.148-.254 1.656.066.228.098.429.126.612.012.076.024.148.037.218.924.385 1.522 1.471 1.591 2.095Zm-5.083-8.707c-1.044-.116-1.488.091-1.681.297-.204.219-.359.679-.242 1.614.091.726.303 1.231.618 1.553.299.305.784.54 1.638.54.922 0 1.28-.198 1.442-.379.179-.2.308-.578.308-1.371 0-.765-.123-1.242-.37-1.554-.233-.296-.693-.587-1.713-.7Zm2.511 11.074c-1.393.776-3.272 1.428-5.43 1.428-4.562 0-7.873-2.914-7.998-3.749V9.338c.085-.628.677-1.686 1.588-2.065.013-.07.024-.143.036-.218.029-.183.06-.384.126-.612-.18-.455-.241-.963-.252-1.475L.31 4.107A.747.747 0 0 1 0 3.509V3.49a.748.748 0 0 1 .625-.73c.156-.026.306.047.435.139l14.667 10.578a.592.592 0 0 1 .227.264.752.752 0 0 1 .046.249v.022a.75.75 0 0 1-1.19.596Zm-1.367-.991L5.635 7.964a5.128 5.128 0 0 1-.889.073c-.652 0-1.236-.081-1.727-.291l-.023.116v4.255c.419.323 2.722 1.433 5.002 1.433 1.539 0 3.089-.505 4.063-.934Z"></path>
</svg>
</template>

<template id="workflow-icon">
  <svg aria-hidden="true" height="16" viewBox="0 0 16 16" version="1.1" width="16" data-view-component="true" class="octicon octicon-workflow">
    <path d="M0 1.75C0 .784.784 0 1.75 0h3.5C6.216 0 7 .784 7 1.75v3.5A1.75 1.75 0 0 1 5.25 7H4v4a1 1 0 0 0 1 1h4v-1.25C9 9.784 9.784 9 10.75 9h3.5c.966 0 1.75.784 1.75 1.75v3.5A1.75 1.75 0 0 1 14.25 16h-3.5A1.75 1.75 0 0 1 9 14.25v-.75H5A2.5 2.5 0 0 1 2.5 11V7h-.75A1.75 1.75 0 0 1 0 5.25Zm1.75-.25a.25.25 0 0 0-.25.25v3.5c0 .138.112.25.25.25h3.5a.25.25 0 0 0 .25-.25v-3.5a.25.25 0 0 0-.25-.25Zm9 9a.25.25 0 0 0-.25.25v3.5c0 .138.112.25.25.25h3.5a.25.25 0 0 0 .25-.25v-3.5a.25.25 0 0 0-.25-.25Z"></path>
</svg>
</template>

<template id="book-icon">
  <svg aria-hidden="true" height="16" viewBox="0 0 16 16" version="1.1" width="16" data-view-component="true" class="octicon octicon-book">
    <path d="M0 1.75A.75.75 0 0 1 .75 1h4.253c1.227 0 2.317.59 3 1.501A3.743 3.743 0 0 1 11.006 1h4.245a.75.75 0 0 1 .75.75v10.5a.75.75 0 0 1-.75.75h-4.507a2.25 2.25 0 0 0-1.591.659l-.622.621a.75.75 0 0 1-1.06 0l-.622-.621A2.25 2.25 0 0 0 5.258 13H.75a.75.75 0 0 1-.75-.75Zm7.251 10.324.004-5.073-.002-2.253A2.25 2.25 0 0 0 5.003 2.5H1.5v9h3.757a3.75 3.75 0 0 1 1.994.574ZM8.755 4.75l-.004 7.322a3.752 3.752 0 0 1 1.992-.572H14.5v-9h-3.495a2.25 2.25 0 0 0-2.25 2.25Z"></path>
</svg>
</template>

<template id="code-review-icon">
  <svg aria-hidden="true" height="16" viewBox="0 0 16 16" version="1.1" width="16" data-view-component="true" class="octicon octicon-code-review">
    <path d="M1.75 1h12.5c.966 0 1.75.784 1.75 1.75v8.5A1.75 1.75 0 0 1 14.25 13H8.061l-2.574 2.573A1.458 1.458 0 0 1 3 14.543V13H1.75A1.75 1.75 0 0 1 0 11.25v-8.5C0 1.784.784 1 1.75 1ZM1.5 2.75v8.5c0 .138.112.25.25.25h2a.75.75 0 0 1 .75.75v2.19l2.72-2.72a.749.749 0 0 1 .53-.22h6.5a.25.25 0 0 0 .25-.25v-8.5a.25.25 0 0 0-.25-.25H1.75a.25.25 0 0 0-.25.25Zm5.28 1.72a.75.75 0 0 1 0 1.06L5.31 7l1.47 1.47a.751.751 0 0 1-.018 1.042.751.751 0 0 1-1.042.018l-2-2a.75.75 0 0 1 0-1.06l2-2a.75.75 0 0 1 1.06 0Zm2.44 0a.75.75 0 0 1 1.06 0l2 2a.75.75 0 0 1 0 1.06l-2 2a.751.751 0 0 1-1.042-.018.751.751 0 0 1-.018-1.042L10.69 7 9.22 5.53a.75.75 0 0 1 0-1.06Z"></path>
</svg>
</template>

<template id="codespaces-icon">
  <svg aria-hidden="true" height="16" viewBox="0 0 16 16" version="1.1" width="16" data-view-component="true" class="octicon octicon-codespaces">
    <path d="M0 11.25c0-.966.784-1.75 1.75-1.75h12.5c.966 0 1.75.784 1.75 1.75v3A1.75 1.75 0 0 1 14.25 16H1.75A1.75 1.75 0 0 1 0 14.25Zm2-9.5C2 .784 2.784 0 3.75 0h8.5C13.216 0 14 .784 14 1.75v5a1.75 1.75 0 0 1-1.75 1.75h-8.5A1.75 1.75 0 0 1 2 6.75Zm1.75-.25a.25.25 0 0 0-.25.25v5c0 .138.112.25.25.25h8.5a.25.25 0 0 0 .25-.25v-5a.25.25 0 0 0-.25-.25Zm-2 9.5a.25.25 0 0 0-.25.25v3c0 .138.112.25.25.25h12.5a.25.25 0 0 0 .25-.25v-3a.25.25 0 0 0-.25-.25Z"></path><path d="M7 12.75a.75.75 0 0 1 .75-.75h4.5a.75.75 0 0 1 0 1.5h-4.5a.75.75 0 0 1-.75-.75Zm-4 0a.75.75 0 0 1 .75-.75h.5a.75.75 0 0 1 0 1.5h-.5a.75.75 0 0 1-.75-.75Z"></path>
</svg>
</template>

<template id="comment-icon">
  <svg aria-hidden="true" height="16" viewBox="0 0 16 16" version="1.1" width="16" data-view-component="true" class="octicon octicon-comment">
    <path d="M1 2.75C1 1.784 1.784 1 2.75 1h10.5c.966 0 1.75.784 1.75 1.75v7.5A1.75 1.75 0 0 1 13.25 12H9.06l-2.573 2.573A1.458 1.458 0 0 1 4 13.543V12H2.75A1.75 1.75 0 0 1 1 10.25Zm1.75-.25a.25.25 0 0 0-.25.25v7.5c0 .138.112.25.25.25h2a.75.75 0 0 1 .75.75v2.19l2.72-2.72a.749.749 0 0 1 .53-.22h4.5a.25.25 0 0 0 .25-.25v-7.5a.25.25 0 0 0-.25-.25Z"></path>
</svg>
</template>

<template id="comment-discussion-icon">
  <svg aria-hidden="true" height="16" viewBox="0 0 16 16" version="1.1" width="16" data-view-component="true" class="octicon octicon-comment-discussion">
    <path d="M1.75 1h8.5c.966 0 1.75.784 1.75 1.75v5.5A1.75 1.75 0 0 1 10.25 10H7.061l-2.574 2.573A1.458 1.458 0 0 1 2 11.543V10h-.25A1.75 1.75 0 0 1 0 8.25v-5.5C0 1.784.784 1 1.75 1ZM1.5 2.75v5.5c0 .138.112.25.25.25h1a.75.75 0 0 1 .75.75v2.19l2.72-2.72a.749.749 0 0 1 .53-.22h3.5a.25.25 0 0 0 .25-.25v-5.5a.25.25 0 0 0-.25-.25h-8.5a.25.25 0 0 0-.25.25Zm13 2a.25.25 0 0 0-.25-.25h-.5a.75.75 0 0 1 0-1.5h.5c.966 0 1.75.784 1.75 1.75v5.5A1.75 1.75 0 0 1 14.25 12H14v1.543a1.458 1.458 0 0 1-2.487 1.03L9.22 12.28a.749.749 0 0 1 .326-1.275.749.749 0 0 1 .734.215l2.22 2.22v-2.19a.75.75 0 0 1 .75-.75h1a.25.25 0 0 0 .25-.25Z"></path>
</svg>
</template>

<template id="organization-icon">
  <svg aria-hidden="true" height="16" viewBox="0 0 16 16" version="1.1" width="16" data-view-component="true" class="octicon octicon-organization">
    <path d="M1.75 16A1.75 1.75 0 0 1 0 14.25V1.75C0 .784.784 0 1.75 0h8.5C11.216 0 12 .784 12 1.75v12.5c0 .085-.006.168-.018.25h2.268a.25.25 0 0 0 .25-.25V8.285a.25.25 0 0 0-.111-.208l-1.055-.703a.749.749 0 1 1 .832-1.248l1.055.703c.487.325.779.871.779 1.456v5.965A1.75 1.75 0 0 1 14.25 16h-3.5a.766.766 0 0 1-.197-.026c-.099.017-.2.026-.303.026h-3a.75.75 0 0 1-.75-.75V14h-1v1.25a.75.75 0 0 1-.75.75Zm-.25-1.75c0 .138.112.25.25.25H4v-1.25a.75.75 0 0 1 .75-.75h2.5a.75.75 0 0 1 .75.75v1.25h2.25a.25.25 0 0 0 .25-.25V1.75a.25.25 0 0 0-.25-.25h-8.5a.25.25 0 0 0-.25.25ZM3.75 6h.5a.75.75 0 0 1 0 1.5h-.5a.75.75 0 0 1 0-1.5ZM3 3.75A.75.75 0 0 1 3.75 3h.5a.75.75 0 0 1 0 1.5h-.5A.75.75 0 0 1 3 3.75Zm4 3A.75.75 0 0 1 7.75 6h.5a.75.75 0 0 1 0 1.5h-.5A.75.75 0 0 1 7 6.75ZM7.75 3h.5a.75.75 0 0 1 0 1.5h-.5a.75.75 0 0 1 0-1.5ZM3 9.75A.75.75 0 0 1 3.75 9h.5a.75.75 0 0 1 0 1.5h-.5A.75.75 0 0 1 3 9.75ZM7.75 9h.5a.75.75 0 0 1 0 1.5h-.5a.75.75 0 0 1 0-1.5Z"></path>
</svg>
</template>

<template id="rocket-icon">
  <svg aria-hidden="true" height="16" viewBox="0 0 16 16" version="1.1" width="16" data-view-component="true" class="octicon octicon-rocket">
    <path d="M14.064 0h.186C15.216 0 16 .784 16 1.75v.186a8.752 8.752 0 0 1-2.564 6.186l-.458.459c-.314.314-.641.616-.979.904v3.207c0 .608-.315 1.172-.833 1.49l-2.774 1.707a.749.749 0 0 1-1.11-.418l-.954-3.102a1.214 1.214 0 0 1-.145-.125L3.754 9.816a1.218 1.218 0 0 1-.124-.145L.528 8.717a.749.749 0 0 1-.418-1.11l1.71-2.774A1.748 1.748 0 0 1 3.31 4h3.204c.288-.338.59-.665.904-.979l.459-.458A8.749 8.749 0 0 1 14.064 0ZM8.938 3.623h-.002l-.458.458c-.76.76-1.437 1.598-2.02 2.5l-1.5 2.317 2.143 2.143 2.317-1.5c.902-.583 1.74-1.26 2.499-2.02l.459-.458a7.25 7.25 0 0 0 2.123-5.127V1.75a.25.25 0 0 0-.25-.25h-.186a7.249 7.249 0 0 0-5.125 2.123ZM3.56 14.56c-.732.732-2.334 1.045-3.005 1.148a.234.234 0 0 1-.201-.064.234.234 0 0 1-.064-.201c.103-.671.416-2.273 1.15-3.003a1.502 1.502 0 1 1 2.12 2.12Zm6.94-3.935c-.088.06-.177.118-.266.175l-2.35 1.521.548 1.783 1.949-1.2a.25.25 0 0 0 .119-.213ZM3.678 8.116 5.2 5.766c.058-.09.117-.178.176-.266H3.309a.25.25 0 0 0-.213.119l-1.2 1.95ZM12 5a1 1 0 1 1-2 0 1 1 0 0 1 2 0Z"></path>
</svg>
</template>

<template id="shield-check-icon">
  <svg aria-hidden="true" height="16" viewBox="0 0 16 16" version="1.1" width="16" data-view-component="true" class="octicon octicon-shield-check">
    <path d="m8.533.133 5.25 1.68A1.75 1.75 0 0 1 15 3.48V7c0 1.566-.32 3.182-1.303 4.682-.983 1.498-2.585 2.813-5.032 3.855a1.697 1.697 0 0 1-1.33 0c-2.447-1.042-4.049-2.357-5.032-3.855C1.32 10.182 1 8.566 1 7V3.48a1.75 1.75 0 0 1 1.217-1.667l5.25-1.68a1.748 1.748 0 0 1 1.066 0Zm-.61 1.429.001.001-5.25 1.68a.251.251 0 0 0-.174.237V7c0 1.36.275 2.666 1.057 3.859.784 1.194 2.121 2.342 4.366 3.298a.196.196 0 0 0 .154 0c2.245-.957 3.582-2.103 4.366-3.297C13.225 9.666 13.5 8.358 13.5 7V3.48a.25.25 0 0 0-.174-.238l-5.25-1.68a.25.25 0 0 0-.153 0ZM11.28 6.28l-3.5 3.5a.75.75 0 0 1-1.06 0l-1.5-1.5a.749.749 0 0 1 .326-1.275.749.749 0 0 1 .734.215l.97.97 2.97-2.97a.751.751 0 0 1 1.042.018.751.751 0 0 1 .018 1.042Z"></path>
</svg>
</template>

<template id="heart-icon">
  <svg aria-hidden="true" height="16" viewBox="0 0 16 16" version="1.1" width="16" data-view-component="true" class="octicon octicon-heart">
    <path d="m8 14.25.345.666a.75.75 0 0 1-.69 0l-.008-.004-.018-.01a7.152 7.152 0 0 1-.31-.17 22.055 22.055 0 0 1-3.434-2.414C2.045 10.731 0 8.35 0 5.5 0 2.836 2.086 1 4.25 1 5.797 1 7.153 1.802 8 3.02 8.847 1.802 10.203 1 11.75 1 13.914 1 16 2.836 16 5.5c0 2.85-2.045 5.231-3.885 6.818a22.066 22.066 0 0 1-3.744 2.584l-.018.01-.006.003h-.002ZM4.25 2.5c-1.336 0-2.75 1.164-2.75 3 0 2.15 1.58 4.144 3.365 5.682A20.58 20.58 0 0 0 8 13.393a20.58 20.58 0 0 0 3.135-2.211C12.92 9.644 14.5 7.65 14.5 5.5c0-1.836-1.414-3-2.75-3-1.373 0-2.609.986-3.029 2.456a.749.749 0 0 1-1.442 0C6.859 3.486 5.623 2.5 4.25 2.5Z"></path>
</svg>
</template>

<template id="server-icon">
  <svg aria-hidden="true" height="16" viewBox="0 0 16 16" version="1.1" width="16" data-view-component="true" class="octicon octicon-server">
    <path d="M1.75 1h12.5c.966 0 1.75.784 1.75 1.75v4c0 .372-.116.717-.314 1 .198.283.314.628.314 1v4a1.75 1.75 0 0 1-1.75 1.75H1.75A1.75 1.75 0 0 1 0 12.75v-4c0-.358.109-.707.314-1a1.739 1.739 0 0 1-.314-1v-4C0 1.784.784 1 1.75 1ZM1.5 2.75v4c0 .138.112.25.25.25h12.5a.25.25 0 0 0 .25-.25v-4a.25.25 0 0 0-.25-.25H1.75a.25.25 0 0 0-.25.25Zm.25 5.75a.25.25 0 0 0-.25.25v4c0 .138.112.25.25.25h12.5a.25.25 0 0 0 .25-.25v-4a.25.25 0 0 0-.25-.25ZM7 4.75A.75.75 0 0 1 7.75 4h4.5a.75.75 0 0 1 0 1.5h-4.5A.75.75 0 0 1 7 4.75ZM7.75 10h4.5a.75.75 0 0 1 0 1.5h-4.5a.75.75 0 0 1 0-1.5ZM3 4.75A.75.75 0 0 1 3.75 4h.5a.75.75 0 0 1 0 1.5h-.5A.75.75 0 0 1 3 4.75ZM3.75 10h.5a.75.75 0 0 1 0 1.5h-.5a.75.75 0 0 1 0-1.5Z"></path>
</svg>
</template>

<template id="globe-icon">
  <svg aria-hidden="true" height="16" viewBox="0 0 16 16" version="1.1" width="16" data-view-component="true" class="octicon octicon-globe">
    <path d="M8 0a8 8 0 1 1 0 16A8 8 0 0 1 8 0ZM5.78 8.75a9.64 9.64 0 0 0 1.363 4.177c.255.426.542.832.857 1.215.245-.296.551-.705.857-1.215A9.64 9.64 0 0 0 10.22 8.75Zm4.44-1.5a9.64 9.64 0 0 0-1.363-4.177c-.307-.51-.612-.919-.857-1.215a9.927 9.927 0 0 0-.857 1.215A9.64 9.64 0 0 0 5.78 7.25Zm-5.944 1.5H1.543a6.507 6.507 0 0 0 4.666 5.5c-.123-.181-.24-.365-.352-.552-.715-1.192-1.437-2.874-1.581-4.948Zm-2.733-1.5h2.733c.144-2.074.866-3.756 1.58-4.948.12-.197.237-.381.353-.552a6.507 6.507 0 0 0-4.666 5.5Zm10.181 1.5c-.144 2.074-.866 3.756-1.58 4.948-.12.197-.237.381-.353.552a6.507 6.507 0 0 0 4.666-5.5Zm2.733-1.5a6.507 6.507 0 0 0-4.666-5.5c.123.181.24.365.353.552.714 1.192 1.436 2.874 1.58 4.948Z"></path>
</svg>
</template>

<template id="issue-opened-icon">
  <svg aria-hidden="true" height="16" viewBox="0 0 16 16" version="1.1" width="16" data-view-component="true" class="octicon octicon-issue-opened">
    <path d="M8 9.5a1.5 1.5 0 1 0 0-3 1.5 1.5 0 0 0 0 3Z"></path><path d="M8 0a8 8 0 1 1 0 16A8 8 0 0 1 8 0ZM1.5 8a6.5 6.5 0 1 0 13 0 6.5 6.5 0 0 0-13 0Z"></path>
</svg>
</template>

<template id="device-mobile-icon">
  <svg aria-hidden="true" height="16" viewBox="0 0 16 16" version="1.1" width="16" data-view-component="true" class="octicon octicon-device-mobile">
    <path d="M3.75 0h8.5C13.216 0 14 .784 14 1.75v12.5A1.75 1.75 0 0 1 12.25 16h-8.5A1.75 1.75 0 0 1 2 14.25V1.75C2 .784 2.784 0 3.75 0ZM3.5 1.75v12.5c0 .138.112.25.25.25h8.5a.25.25 0 0 0 .25-.25V1.75a.25.25 0 0 0-.25-.25h-8.5a.25.25 0 0 0-.25.25ZM8 13a1 1 0 1 1 0-2 1 1 0 0 1 0 2Z"></path>
</svg>
</template>

<template id="package-icon">
  <svg aria-hidden="true" height="16" viewBox="0 0 16 16" version="1.1" width="16" data-view-component="true" class="octicon octicon-package">
    <path d="m8.878.392 5.25 3.045c.54.314.872.89.872 1.514v6.098a1.75 1.75 0 0 1-.872 1.514l-5.25 3.045a1.75 1.75 0 0 1-1.756 0l-5.25-3.045A1.75 1.75 0 0 1 1 11.049V4.951c0-.624.332-1.201.872-1.514L7.122.392a1.75 1.75 0 0 1 1.756 0ZM7.875 1.69l-4.63 2.685L8 7.133l4.755-2.758-4.63-2.685a.248.248 0 0 0-.25 0ZM2.5 5.677v5.372c0 .09.047.171.125.216l4.625 2.683V8.432Zm6.25 8.271 4.625-2.683a.25.25 0 0 0 .125-.216V5.677L8.75 8.432Z"></path>
</svg>
</template>

<template id="credit-card-icon">
  <svg aria-hidden="true" height="16" viewBox="0 0 16 16" version="1.1" width="16" data-view-component="true" class="octicon octicon-credit-card">
    <path d="M10.75 9a.75.75 0 0 0 0 1.5h1.5a.75.75 0 0 0 0-1.5h-1.5Z"></path><path d="M0 3.75C0 2.784.784 2 1.75 2h12.5c.966 0 1.75.784 1.75 1.75v8.5A1.75 1.75 0 0 1 14.25 14H1.75A1.75 1.75 0 0 1 0 12.25ZM14.5 6.5h-13v5.75c0 .138.112.25.25.25h12.5a.25.25 0 0 0 .25-.25Zm0-2.75a.25.25 0 0 0-.25-.25H1.75a.25.25 0 0 0-.25.25V5h13Z"></path>
</svg>
</template>

<template id="play-icon">
  <svg aria-hidden="true" height="16" viewBox="0 0 16 16" version="1.1" width="16" data-view-component="true" class="octicon octicon-play">
    <path d="M8 0a8 8 0 1 1 0 16A8 8 0 0 1 8 0ZM1.5 8a6.5 6.5 0 1 0 13 0 6.5 6.5 0 0 0-13 0Zm4.879-2.773 4.264 2.559a.25.25 0 0 1 0 .428l-4.264 2.559A.25.25 0 0 1 6 10.559V5.442a.25.25 0 0 1 .379-.215Z"></path>
</svg>
</template>

<template id="gift-icon">
  <svg aria-hidden="true" height="16" viewBox="0 0 16 16" version="1.1" width="16" data-view-component="true" class="octicon octicon-gift">
    <path d="M2 2.75A2.75 2.75 0 0 1 4.75 0c.983 0 1.873.42 2.57 1.232.268.318.497.668.68 1.042.183-.375.411-.725.68-1.044C9.376.42 10.266 0 11.25 0a2.75 2.75 0 0 1 2.45 4h.55c.966 0 1.75.784 1.75 1.75v2c0 .698-.409 1.301-1 1.582v4.918A1.75 1.75 0 0 1 13.25 16H2.75A1.75 1.75 0 0 1 1 14.25V9.332C.409 9.05 0 8.448 0 7.75v-2C0 4.784.784 4 1.75 4h.55c-.192-.375-.3-.8-.3-1.25ZM7.25 9.5H2.5v4.75c0 .138.112.25.25.25h4.5Zm1.5 0v5h4.5a.25.25 0 0 0 .25-.25V9.5Zm0-4V8h5.5a.25.25 0 0 0 .25-.25v-2a.25.25 0 0 0-.25-.25Zm-7 0a.25.25 0 0 0-.25.25v2c0 .138.112.25.25.25h5.5V5.5h-5.5Zm3-4a1.25 1.25 0 0 0 0 2.5h2.309c-.233-.818-.542-1.401-.878-1.793-.43-.502-.915-.707-1.431-.707ZM8.941 4h2.309a1.25 1.25 0 0 0 0-2.5c-.516 0-1 .205-1.43.707-.337.392-.646.975-.879 1.793Z"></path>
</svg>
</template>

<template id="code-square-icon">
  <svg aria-hidden="true" height="16" viewBox="0 0 16 16" version="1.1" width="16" data-view-component="true" class="octicon octicon-code-square">
    <path d="M0 1.75C0 .784.784 0 1.75 0h12.5C15.216 0 16 .784 16 1.75v12.5A1.75 1.75 0 0 1 14.25 16H1.75A1.75 1.75 0 0 1 0 14.25Zm1.75-.25a.25.25 0 0 0-.25.25v12.5c0 .138.112.25.25.25h12.5a.25.25 0 0 0 .25-.25V1.75a.25.25 0 0 0-.25-.25Zm7.47 3.97a.75.75 0 0 1 1.06 0l2 2a.75.75 0 0 1 0 1.06l-2 2a.749.749 0 0 1-1.275-.326.749.749 0 0 1 .215-.734L10.69 8 9.22 6.53a.75.75 0 0 1 0-1.06ZM6.78 6.53 5.31 8l1.47 1.47a.749.749 0 0 1-.326 1.275.749.749 0 0 1-.734-.215l-2-2a.75.75 0 0 1 0-1.06l2-2a.751.751 0 0 1 1.042.018.751.751 0 0 1 .018 1.042Z"></path>
</svg>
</template>

<template id="device-desktop-icon">
  <svg aria-hidden="true" height="16" viewBox="0 0 16 16" version="1.1" width="16" data-view-component="true" class="octicon octicon-device-desktop">
    <path d="M14.25 1c.966 0 1.75.784 1.75 1.75v7.5A1.75 1.75 0 0 1 14.25 12h-3.727c.099 1.041.52 1.872 1.292 2.757A.752.752 0 0 1 11.25 16h-6.5a.75.75 0 0 1-.565-1.243c.772-.885 1.192-1.716 1.292-2.757H1.75A1.75 1.75 0 0 1 0 10.25v-7.5C0 1.784.784 1 1.75 1ZM1.75 2.5a.25.25 0 0 0-.25.25v7.5c0 .138.112.25.25.25h12.5a.25.25 0 0 0 .25-.25v-7.5a.25.25 0 0 0-.25-.25ZM9.018 12H6.982a5.72 5.72 0 0 1-.765 2.5h3.566a5.72 5.72 0 0 1-.765-2.5Z"></path>
</svg>
</template>

        <div class="position-relative">
                        <ul
              role="listbox"
              class="ActionListWrap QueryBuilder-ListWrap"
              aria-label="Suggestions"
              data-action="
                combobox-commit:query-builder#comboboxCommit
                mousedown:query-builder#resultsMousedown
              "
              data-target="query-builder.resultsList"
              data-persist-list=false
              id="query-builder-test-results"
              tabindex="-1"
            ></ul>

        </div>
      <div class="FormControl-inlineValidation" id="validation-42d8001b-64ca-408d-bd02-55268ff1d565" hidden="hidden">
        <span class="FormControl-inlineValidation--visual">
          <svg aria-hidden="true" height="12" viewBox="0 0 12 12" version="1.1" width="12" data-view-component="true" class="octicon octicon-alert-fill">
    <path d="M4.855.708c.5-.896 1.79-.896 2.29 0l4.675 8.351a1.312 1.312 0 0 1-1.146 1.954H1.33A1.313 1.313 0 0 1 .183 9.058ZM7 7V3H5v4Zm-1 3a1 1 0 1 0 0-2 1 1 0 0 0 0 2Z"></path>
</svg>
        </span>
        <span></span>
</div>    </div>
    
</query-builder></form>
          <div class="d-flex flex-row color-fg-muted px-3 text-small color-bg-default search-feedback-prompt">
            <a target="_blank" href="https://docs.github.com/search-github/github-code-search/understanding-github-code-search-syntax" data-view-component="true" class="Link color-fg-accent text-normal ml-2">Search syntax tips</a>            
              <button data-action="click:qbsearch-input#showFeedbackDialog" type="button" data-view-component="true" class="Button--link Button--medium Button color-fg-accent text-normal ml-2">  <span class="Button-content">
    <span class="Button-label">Give feedback</span>
  </span>
</button>
          </div>
        </div>
</div>

    </div>
</modal-dialog></div>
  </div>
  
  <div class="color-fg-default">
    
<dialog-helper>
  <dialog data-target="qbsearch-input.feedbackDialog" data-action="close:qbsearch-input#handleDialogClose cancel:qbsearch-input#handleDialogClose" id="feedback-dialog" aria-modal="true" aria-labelledby="feedback-dialog-title" aria-describedby="feedback-dialog-description" data-view-component="true" class="Overlay Overlay-whenNarrow Overlay--size-medium Overlay--motion-scaleFade Overlay--disableScroll">
    <div data-view-component="true" class="Overlay-header">
  <div class="Overlay-headerContentWrap">
    <div class="Overlay-titleWrap">
      <h1 class="Overlay-title " id="feedback-dialog-title">
        Provide feedback
      </h1>
        
    </div>
    <div class="Overlay-actionWrap">
      <button data-close-dialog-id="feedback-dialog" aria-label="Close" aria-label="Close" type="button" data-view-component="true" class="close-button Overlay-closeButton"><svg aria-hidden="true" height="16" viewBox="0 0 16 16" version="1.1" width="16" data-view-component="true" class="octicon octicon-x">
    <path d="M3.72 3.72a.75.75 0 0 1 1.06 0L8 6.94l3.22-3.22a.749.749 0 0 1 1.275.326.749.749 0 0 1-.215.734L9.06 8l3.22 3.22a.749.749 0 0 1-.326 1.275.749.749 0 0 1-.734-.215L8 9.06l-3.22 3.22a.751.751 0 0 1-1.042-.018.751.751 0 0 1-.018-1.042L6.94 8 3.72 4.78a.75.75 0 0 1 0-1.06Z"></path>
</svg></button>
    </div>
  </div>
  
</div>
      <scrollable-region data-labelled-by="feedback-dialog-title">
        <div data-view-component="true" class="Overlay-body">        <!-- '"` --><!-- </textarea></xmp> --></option></form><form id="code-search-feedback-form" data-turbo="false" action="/search/feedback" accept-charset="UTF-8" method="post"><input type="hidden" name="authenticity_token" value="YcBu3J9gd5i8-KTmtcQg-HiAsrfraqE9YZipcKCPsybC08mHQv_XC1g0cVi5Z61Sc_bg4MFFFkG-FO4O0jdAhg" />
          <p>We read every piece of feedback, and take your input very seriously.</p>
          <textarea name="feedback" class="form-control width-full mb-2" style="height: 120px" id="feedback"></textarea>
          <input name="include_email" id="include_email" aria-label="Include my email address so I can be contacted" class="form-control mr-2" type="checkbox">
          <label for="include_email" style="font-weight: normal">Include my email address so I can be contacted</label>
</form></div>
      </scrollable-region>
      <div data-view-component="true" class="Overlay-footer Overlay-footer--alignEnd">          <button data-close-dialog-id="feedback-dialog" type="button" data-view-component="true" class="btn">    Cancel
</button>
          <button form="code-search-feedback-form" data-action="click:qbsearch-input#submitFeedback" type="submit" data-view-component="true" class="btn-primary btn">    Submit feedback
</button>
</div>
</dialog></dialog-helper>

    <custom-scopes data-target="qbsearch-input.customScopesManager">
    
<dialog-helper>
  <dialog data-target="custom-scopes.customScopesModalDialog" data-action="close:qbsearch-input#handleDialogClose cancel:qbsearch-input#handleDialogClose" id="custom-scopes-dialog" aria-modal="true" aria-labelledby="custom-scopes-dialog-title" aria-describedby="custom-scopes-dialog-description" data-view-component="true" class="Overlay Overlay-whenNarrow Overlay--size-medium Overlay--motion-scaleFade Overlay--disableScroll">
    <div data-view-component="true" class="Overlay-header Overlay-header--divided">
  <div class="Overlay-headerContentWrap">
    <div class="Overlay-titleWrap">
      <h1 class="Overlay-title " id="custom-scopes-dialog-title">
        Saved searches
      </h1>
        <h2 id="custom-scopes-dialog-description" class="Overlay-description">Use saved searches to filter your results more quickly</h2>
    </div>
    <div class="Overlay-actionWrap">
      <button data-close-dialog-id="custom-scopes-dialog" aria-label="Close" aria-label="Close" type="button" data-view-component="true" class="close-button Overlay-closeButton"><svg aria-hidden="true" height="16" viewBox="0 0 16 16" version="1.1" width="16" data-view-component="true" class="octicon octicon-x">
    <path d="M3.72 3.72a.75.75 0 0 1 1.06 0L8 6.94l3.22-3.22a.749.749 0 0 1 1.275.326.749.749 0 0 1-.215.734L9.06 8l3.22 3.22a.749.749 0 0 1-.326 1.275.749.749 0 0 1-.734-.215L8 9.06l-3.22 3.22a.751.751 0 0 1-1.042-.018.751.751 0 0 1-.018-1.042L6.94 8 3.72 4.78a.75.75 0 0 1 0-1.06Z"></path>
</svg></button>
    </div>
  </div>
  
</div>
      <scrollable-region data-labelled-by="custom-scopes-dialog-title">
        <div data-view-component="true" class="Overlay-body">        

        <div hidden class="create-custom-scope-form" data-target="custom-scopes.createCustomScopeForm">
        <!-- '"` --><!-- </textarea></xmp> --></option></form><form id="custom-scopes-dialog-form" data-turbo="false" action="/search/custom_scopes" accept-charset="UTF-8" method="post"><input type="hidden" name="authenticity_token" value="JrU2T7rAk9RXJulfK0UG2U3DJ-9rE_CqgDETJPKu76UkA43MCAFBc8WAnEyIcd4X-GPWdOOt4ldD6Ks6XgvAOg" />

          <input type="hidden" id="custom_scope_id" name="custom_scope_id" data-target="custom-scopes.customScopesIdField">

          <div class="form-group">
            <label for="custom_scope_name">Name</label>
            <auto-check src="/search/custom_scopes/check_name" required>
              <input
                type="text"
                name="custom_scope_name"
                id="custom_scope_name"
                data-target="custom-scopes.customScopesNameField"
                class="form-control"
                autocomplete="off"
                placeholder="github-ruby"
                required
                maxlength="50">
              <input type="hidden" value="h3JTS3Wg6_craBtjQ7pXh3gatNSjdjvE0k7fmykSLhjkR6zzhrzf45FvmxAa_uJhMwjqtFgTeSQc9gecwg4u8w" data-csrf="true" />
            </auto-check>
          </div>

          <div class="form-group">
            <label for="custom_scope_query">Query</label>
            <input
              type="text"
              name="custom_scope_query"
              id="custom_scope_query"
              data-target="custom-scopes.customScopesQueryField"
              class="form-control"
              autocomplete="off"
              placeholder="(repo:mona/a OR repo:mona/b) AND lang:python"
              required
              maxlength="500">
          </div>

          <p class="text-small color-fg-muted">
            To see all available qualifiers, see our <a class="Link--inTextBlock" href="https://docs.github.com/search-github/github-code-search/understanding-github-code-search-syntax">documentation</a>.
          </p>
</form>        </div>

        <div data-target="custom-scopes.manageCustomScopesForm">
          
        </div>

</div>
      </scrollable-region>
      <div data-view-component="true" class="Overlay-footer Overlay-footer--alignEnd Overlay-footer--divided">          <button data-action="click:custom-scopes#customScopesCancel" type="button" data-view-component="true" class="btn">    Cancel
</button>
          <button form="custom-scopes-dialog-form" data-action="click:custom-scopes#customScopesSubmit" data-target="custom-scopes.customScopesSubmitButton" type="submit" data-view-component="true" class="btn-primary btn">    Create saved search
</button>
</div>
</dialog></dialog-helper>
    </custom-scopes>
  </div>
</qbsearch-input>  <input type="hidden" value="lRPkMmSZZe7kLzRyIXqjYSXh2t-ZN_Zddyck2jhWiPEmguQ7IjHiNHQGNQLI2W_THdiak2mTWF7pSqN6HtFXUQ" data-csrf="true" class="js-data-jump-to-suggestions-path-csrf" />

      </div>

      <div hidden="hidden" data-view-component="true" class="js-stale-session-flash stale-session-flash flash flash-warn flash-full">
  
        <svg aria-hidden="true" height="16" viewBox="0 0 16 16" version="1.1" width="16" data-view-component="true" class="octicon octicon-alert">
    <path d="M6.457 1.047c.659-1.234 2.427-1.234 3.086 0l6.082 11.378A1.75 1.75 0 0 1 14.082 15H1.918a1.75 1.75 0 0 1-1.543-2.575Zm1.763.707a.25.25 0 0 0-.44 0L1.698 13.132a.25.25 0 0 0 .22.368h12.164a.25.25 0 0 0 .22-.368Zm.53 3.996v2.5a.75.75 0 0 1-1.5 0v-2.5a.75.75 0 0 1 1.5 0ZM9 11a1 1 0 1 1-2 0 1 1 0 0 1 2 0Z"></path>
</svg>
        <span class="js-stale-session-flash-signed-in" hidden>You signed in with another tab or window. <a class="Link--inTextBlock" href="">Reload</a> to refresh your session.</span>
        <span class="js-stale-session-flash-signed-out" hidden>You signed out in another tab or window. <a class="Link--inTextBlock" href="">Reload</a> to refresh your session.</span>
        <span class="js-stale-session-flash-switched" hidden>You switched accounts on another tab or window. <a class="Link--inTextBlock" href="">Reload</a> to refresh your session.</span>

    <button id="icon-button-0f775d01-0cdf-4e20-b9d5-37ce2144c707" aria-labelledby="tooltip-b8fb71f7-4fa3-4daa-8e1f-d0d897d2fdb4" type="button" data-view-component="true" class="Button Button--iconOnly Button--invisible Button--medium flash-close js-flash-close">  <svg aria-hidden="true" height="16" viewBox="0 0 16 16" version="1.1" width="16" data-view-component="true" class="octicon octicon-x Button-visual">
    <path d="M3.72 3.72a.75.75 0 0 1 1.06 0L8 6.94l3.22-3.22a.749.749 0 0 1 1.275.326.749.749 0 0 1-.215.734L9.06 8l3.22 3.22a.749.749 0 0 1-.326 1.275.749.749 0 0 1-.734-.215L8 9.06l-3.22 3.22a.751.751 0 0 1-1.042-.018.751.751 0 0 1-.018-1.042L6.94 8 3.72 4.78a.75.75 0 0 1 0-1.06Z"></path>
</svg>
</button><tool-tip id="tooltip-b8fb71f7-4fa3-4daa-8e1f-d0d897d2fdb4" for="icon-button-0f775d01-0cdf-4e20-b9d5-37ce2144c707" popover="manual" data-direction="s" data-type="label" data-view-component="true" class="sr-only position-absolute">Dismiss alert</tool-tip>

</div>

    </div>

    <div id="js-flash-container" class="flash-container" data-turbo-replace>

  <template class="js-flash-template">
    
<div class="flash flash-full   {{ className }}">
  <div >
    <button autofocus class="flash-close js-flash-close" type="button" aria-label="Dismiss this message">
      <svg aria-hidden="true" height="16" viewBox="0 0 16 16" version="1.1" width="16" data-view-component="true" class="octicon octicon-x">
    <path d="M3.72 3.72a.75.75 0 0 1 1.06 0L8 6.94l3.22-3.22a.749.749 0 0 1 1.275.326.749.749 0 0 1-.215.734L9.06 8l3.22 3.22a.749.749 0 0 1-.326 1.275.749.749 0 0 1-.734-.215L8 9.06l-3.22 3.22a.751.751 0 0 1-1.042-.018.751.751 0 0 1-.018-1.042L6.94 8 3.72 4.78a.75.75 0 0 1 0-1.06Z"></path>
</svg>
    </button>
    <div aria-atomic="true" role="alert" class="js-flash-alert">
      
      <div>{{ message }}</div>

    </div>
  </div>
</div>
  </template>
</div>

  <notification-shelf-watcher data-base-url="https://github.com/notifications/beta/shelf" data-channel="eyJjIjoibm90aWZpY2F0aW9uLWNoYW5nZWQ6MTQzNTM5MDMzIiwidCI6MTc3MDU2MTkzOX0=--a917f5afcf028cbdbd35cc01e1f16011ded0ca117255a4114babf1b88724b463" data-view-component="true" class="js-socket-channel"></notification-shelf-watcher>

  <div
    class="application-main "
    data-commit-hovercards-enabled
    data-discussion-hovercards-enabled
    data-issue-and-pr-hovercards-enabled
    data-project-hovercards-enabled
  >
        <div itemscope itemtype="http://schema.org/SoftwareSourceCode" class="">
    <main id="js-repo-pjax-container" >

<turbo-frame id="repo-content-turbo-frame" target="_top" data-turbo-action="advance" class="">
    <div id="repo-content-pjax-container" class="repository-content " >
      <a href="https://github.dev/" class="d-none js-github-dev-shortcut" data-hotkey=".,Mod+Alt+.">Open in github.dev</a>
  <a href="https://github.dev/" class="d-none js-github-dev-new-tab-shortcut" data-hotkey="Shift+.,Shift+&gt;,&gt;" target="_blank" rel="noopener noreferrer">Open in a new github.dev tab</a>
    <a class="d-none" data-hotkey=",,Mod+Alt+," target="_blank" href="/codespaces/new/labtroll/KiCad-DesignRules/tree/main?resume=1">Open in codespace</a>

<react-app
  app-name="react-code-view"
  initial-path="/labtroll/KiCad-DesignRules/blob/main/JLCPCB/README.md"
  style="display: block; min-height: calc(100vh - 64px);"
  data-attempted-ssr="true"
  data-ssr="true"
  data-lazy="false"
  data-alternate="false"
  data-data-router-enabled="false"
  data-react-profiling="true"
>
  
  <script type="application/json" data-target="react-app.embeddedData">{"payload":{"codeLineWrapEnabled":false,"refInfo":{"name":"main","listCacheKey":"v0:1697734993.313987","canEdit":true,"refType":"branch","currentOid":"9203afefd301e531d37842ddc7ed9c03006c3ea9","canEditOnDefaultBranch":true,"fileExistsOnDefault":true},"path":"JLCPCB/README.md","blob":{"rawLines":null,"stylingDirectives":null,"colorizedLines":null,"csv":null,"csvError":null,"copilotSWEAgentEnabled":false,"dependabotInfo":{"showConfigurationBanner":false,"configFilePath":null,"networkDependabotPath":"/labtroll/KiCad-DesignRules/network/updates","dismissConfigurationNoticePath":"/settings/dismiss-notice/dependabot_configuration_notice","configurationNoticeDismissed":false},"displayName":"README.md","displayUrl":"https://github.com/labtroll/KiCad-DesignRules/blob/main/JLCPCB/README.md?raw=true","headerInfo":{"blobSize":"26 Bytes","deleteTooltip":"Fork this repository and delete the file","editTooltip":"Fork this repository and edit the file","ghDesktopPath":"x-github-client://openRepo/https://github.com/labtroll/KiCad-DesignRules?branch=main\u0026filepath=JLCPCB%2FREADME.md","isGitLfs":false,"onBranch":true,"shortPath":"952448c","siteNavLoginPath":"/login?return_to=https%3A%2F%2Fgithub.com%2Flabtroll%2FKiCad-DesignRules%2Fblob%2Fmain%2FJLCPCB%2FREADME.md","isCSV":false,"isRichtext":true,"toc":[{"level":1,"text":"Design Rules for JLCPCB","anchor":"design-rules-for-jlcpcb","htmlText":"Design Rules for JLCPCB"}],"lineInfo":{"truncatedLoc":"1","truncatedSloc":"1"},"mode":"file"},"image":false,"isCodeownersFile":null,"isPlain":false,"isValidLegacyIssueTemplate":false,"issueTemplate":null,"discussionTemplate":null,"language":"Markdown","languageID":222,"large":false,"planSupportInfo":{"repoIsFork":null,"repoOwnedByCurrentUser":null,"requestFullPath":"/labtroll/KiCad-DesignRules/blob/main/JLCPCB/README.md","showFreeOrgGatedFeatureMessage":null,"showPlanSupportBanner":null,"upgradeDataAttributes":null,"upgradePath":null},"publishBannersInfo":{"dismissActionNoticePath":"/settings/dismiss-notice/publish_action_from_dockerfile","releasePath":"/labtroll/KiCad-DesignRules/releases/new?marketplace=true","showPublishActionBanner":false},"rawBlobUrl":"https://github.com/labtroll/KiCad-DesignRules/raw/refs/heads/main/JLCPCB/README.md","renderImageOrRaw":false,"richText":"\u003carticle class=\"markdown-body entry-content container-lg\" itemprop=\"text\"\u003e\u003cdiv class=\"markdown-heading\" dir=\"auto\"\u003e\u003ch1 tabindex=\"-1\" class=\"heading-element\" dir=\"auto\"\u003eDesign Rules for JLCPCB\u003c/h1\u003e\u003ca id=\"user-content-design-rules-for-jlcpcb\" class=\"anchor\" aria-label=\"Permalink: Design Rules for JLCPCB\" href=\"#design-rules-for-jlcpcb\"\u003e\u003csvg class=\"octicon octicon-link\" viewBox=\"0 0 16 16\" version=\"1.1\" width=\"16\" height=\"16\" aria-hidden=\"true\"\u003e\u003cpath d=\"m7.775 3.275 1.25-1.25a3.5 3.5 0 1 1 4.95 4.95l-2.5 2.5a3.5 3.5 0 0 1-4.95 0 .751.751 0 0 1 .018-1.042.751.751 0 0 1 1.042-.018 1.998 1.998 0 0 0 2.83 0l2.5-2.5a2.002 2.002 0 0 0-2.83-2.83l-1.25 1.25a.751.751 0 0 1-1.042-.018.751.751 0 0 1-.018-1.042Zm-4.69 9.64a1.998 1.998 0 0 0 2.83 0l1.25-1.25a.751.751 0 0 1 1.042.018.751.751 0 0 1 .018 1.042l-1.25 1.25a3.5 3.5 0 1 1-4.95-4.95l2.5-2.5a3.5 3.5 0 0 1 4.95 0 .751.751 0 0 1-.018 1.042.751.751 0 0 1-1.042.018 1.998 1.998 0 0 0-2.83 0l-2.5 2.5a1.998 1.998 0 0 0 0 2.83Z\"\u003e\u003c/path\u003e\u003c/svg\u003e\u003c/a\u003e\u003c/div\u003e\n\u003c/article\u003e","renderedFileInfo":null,"shortPath":null,"symbolsEnabled":true,"tabSize":4,"topBannersInfo":{"overridingGlobalFundingFile":false,"globalPreferredFundingPath":null,"showInvalidCitationWarning":false,"citationHelpUrl":"https://docs.github.com/github/creating-cloning-and-archiving-repositories/creating-a-repository-on-github/about-citation-files","actionsOnboardingTip":null},"truncated":false,"viewable":true,"workflowRedirectUrl":null,"symbols":{"timed_out":false,"not_analyzed":false,"symbols":[{"name":"Design Rules for JLCPCB","kind":"section_1","ident_start":2,"ident_end":25,"extent_start":0,"extent_end":26,"fully_qualified_name":"Design Rules for JLCPCB","ident_utf16":{"start":{"line_number":0,"utf16_col":2},"end":{"line_number":0,"utf16_col":25}},"extent_utf16":{"start":{"line_number":0,"utf16_col":0},"end":{"line_number":1,"utf16_col":0}}}]}},"copilotInfo":null,"copilotAccessAllowed":false,"copilotSpacesEnabled":false,"modelsAccessAllowed":false,"modelsRepoIntegrationEnabled":false,"isMarketplaceEnabled":true,"allShortcutsEnabled":true,"fileTree":{"JLCPCB":{"items":[{"name":"JLCPCB.kicad_dru","path":"JLCPCB/JLCPCB.kicad_dru","contentType":"file"},{"name":"JLCPCB.kicad_pcb","path":"JLCPCB/JLCPCB.kicad_pcb","contentType":"file"},{"name":"JLCPCB.kicad_pro","path":"JLCPCB/JLCPCB.kicad_pro","contentType":"file"},{"name":"JLCPCB.kicad_sch","path":"JLCPCB/JLCPCB.kicad_sch","contentType":"file"},{"name":"README.md","path":"JLCPCB/README.md","contentType":"file"}],"totalCount":5},"":{"items":[{"name":"JLCPCB","path":"JLCPCB","contentType":"directory"},{"name":"PCBWAY","path":"PCBWAY","contentType":"directory"},{"name":".gitignore","path":".gitignore","contentType":"file"},{"name":"README.md","path":"README.md","contentType":"file"}],"totalCount":4}},"fileTreeProcessingTime":8.500805,"incompleteFileTree":false,"foldersToFetch":[],"repo":{"id":707325958,"defaultBranch":"main","name":"KiCad-DesignRules","ownerLogin":"labtroll","currentUserCanPush":false,"isFork":false,"isEmpty":false,"createdAt":"2023-10-19T19:03:12.000+02:00","ownerAvatar":"https://avatars.githubusercontent.com/u/147919420?v=4","public":true,"private":false,"isOrgOwned":true},"currentUser":{"id":143539033,"login":"stefan-R75","userEmail":"stefan@vanrozendaal.eu"},"csrf_tokens":{"/labtroll/KiCad-DesignRules/branches":{"post":"6tm7s0tfTDrhy3TelOdnkQ_DUiW8vnCDHlalypK_QvJfoPCMTQEDma1sAjmb5u_kEIJQpUq3w2hKLyJXTkBEBA"}}},"title":"KiCad-DesignRules/JLCPCB/README.md at main · labtroll/KiCad-DesignRules","appPayload":{"helpUrl":"https://docs.github.com","findFileWorkerPath":"/assets-cdn/worker/find-file-worker-c9afb5c8e6c259af.js","findInFileWorkerPath":"/assets-cdn/worker/find-in-file-worker-d621bf533c3cac9a.js","githubDevUrl":"https://github.dev/","enabled_features":{"code_nav_ui_events":false,"react_blob_overlay":true}}}</script>
  <div data-target="react-app.reactRoot"><style data-styled="true" data-styled-version="5.3.11">.jmjlbk{width:100%;}/*!sc*/
@media screen and (min-width:544px){.jmjlbk{width:100%;}}/*!sc*/
@media screen and (min-width:768px){.jmjlbk{width:auto;}}/*!sc*/
.cybVuK{margin-left:auto;margin-right:auto;-webkit-flex-direction:column;-ms-flex-direction:column;flex-direction:column;padding-bottom:40px;max-width:100%;margin-top:0;}/*!sc*/
.gSjuRy{display:inherit;}/*!sc*/
.jqtuOB{display:block;margin-right:8px;}/*!sc*/
@media screen and (min-width:1360px){.jqtuOB{display:block;}}/*!sc*/
.jyTWxL{margin-left:16px;margin-right:16px;}/*!sc*/
.hGzGyY{display:-webkit-box;display:-webkit-flex;display:-ms-flexbox;display:flex;-webkit-flex-direction:row;-ms-flex-direction:row;flex-direction:row;}/*!sc*/
.cJXRZE{width:100%;height:-webkit-fit-content;height:-moz-fit-content;height:fit-content;min-width:0;margin-right:0;}/*!sc*/
.fpyUWF{height:40px;padding-left:4px;padding-bottom:16px;}/*!sc*/
.iafbuG{top:0px;z-index:4;background:var(--bgColor-default,var(--color-canvas-default));position:-webkit-sticky;position:sticky;}/*!sc*/
.iNRqcN{display:none;min-width:0;padding-top:8px;padding-bottom:8px;}/*!sc*/
.dIDnLY{border:1px solid;border-top:none;border-color:var(--borderColor-default,var(--color-border-default,#30363d));border-radius:0px 0px 6px 6px;min-width:273px;}/*!sc*/
.iZiBDT{background-color:var(--bgColor-default,var(--color-canvas-default));border:0px;border-width:0;border-radius:0px 0px 6px 6px;padding:0;min-width:0;margin-top:46px;-webkit-box-pack:center;-webkit-justify-content:center;-ms-flex-pack:center;justify-content:center;}/*!sc*/
.lhfNqO{border-bottom-left-radius:6px;border-bottom-right-radius:6px;padding:32px;min-width:0;}/*!sc*/
.vdPNv{position:fixed;top:0;right:0;height:100%;width:15px;-webkit-transition:-webkit-transform 0.3s;-webkit-transition:transform 0.3s;transition:transform 0.3s;z-index:1;}/*!sc*/
.vdPNv:hover{-webkit-transform:scaleX(1.5);-ms-transform:scaleX(1.5);transform:scaleX(1.5);}/*!sc*/
data-styled.g1[id="Box-sc-62in7e-0"]{content:"jmjlbk,cybVuK,gSjuRy,jqtuOB,jyTWxL,hGzGyY,cJXRZE,fpyUWF,iafbuG,iNRqcN,dIDnLY,iZiBDT,lhfNqO,vdPNv,"}/*!sc*/
.hfSsoj[data-size="medium"][data-no-visuals]{display:none;}/*!sc*/
data-styled.g14[id="Button__StyledButtonComponent-sc-vqy3e4-0"]{content:"hfSsoj,"}/*!sc*/
</style><meta name="github-code-view-meta-stats" id="github-code-view-meta-stats" data-hydrostats="publish"/> <!-- --> <!-- --> <button hidden="" data-testid="header-permalink-button" data-hotkey-scope="read-only-cursor-text-area"></button><button hidden=""></button><div><div style="--spacing:var(--spacing-none)" class="prc-PageLayout-PageLayoutRoot--KH-d"><div class="prc-PageLayout-PageLayoutWrapper-2BhU2" data-width="full"><div class="prc-PageLayout-PageLayoutContent-BneH9"><div tabindex="0" class="Box-sc-62in7e-0 jmjlbk"><div class="prc-PageLayout-PaneWrapper-pHPop ReposFileTreePane-module__Pane__G6mCt9A ReposFileTreePane-module__HideTree__os1Arl_ ReposFileTreePane-module__HidePane__glpb72p" style="--offset-header:0px;--spacing-row:var(--spacing-none);--spacing-column:var(--spacing-none)" data-is-hidden="false" data-position="start" data-sticky="true"><div class="prc-PageLayout-VerticalDivider-9QRmK prc-PageLayout-PaneVerticalDivider-le57g" data-variant-narrow="none" data-variant-regular="line" data-variant-wide="line" data-position="start" style="--spacing:var(--spacing-none)"></div></div></div><div class="prc-PageLayout-ContentWrapper-gR9eG" data-is-hidden-narrow="false"><div class="prc-PageLayout-Content-xWL-A" data-width="full" style="--spacing:var(--spacing-none)"><div data-selector="repos-split-pane-content" tabindex="0" class="Box-sc-62in7e-0 cybVuK"><div class="Box-sc-62in7e-0 gSjuRy"><div class="container CodeViewHeader-module__Box__U5tFW12"><div class="pr-px-3 pr-pt-3 pb-0" id="StickyHeader"><div class="CodeViewHeader-module__Box_1__ZwWUsk9"><div class="CodeViewHeader-module__Box_2__ONieP7J"><div class="react-code-view-header-wrap--narrow CodeViewHeader-module__Box_3__NJjBsee"><div class="Box-sc-62in7e-0 jqtuOB"><h2 class="use-tree-pane-module__Heading__OiAv1P0 prc-Heading-Heading-MtWFE"><button type="button" aria-label="Expand file tree" data-testid="expand-file-tree-button-mobile" class="prc-Button-ButtonBase-9n-Xk ExpandFileTreeButton-module__Button_1__UeSyAxq" data-loading="false" data-size="medium" data-variant="invisible"><span data-component="buttonContent" data-align="center" class="prc-Button-ButtonContent-Iohp5"><span data-component="leadingVisual" class="prc-Button-Visual-YNt2F prc-Button-VisualWrap-E4cnq"><svg aria-hidden="true" focusable="false" class="octicon octicon-arrow-left" viewBox="0 0 16 16" width="16" height="16" fill="currentColor" display="inline-block" overflow="visible" style="vertical-align:text-bottom"><path d="M7.78 12.53a.75.75 0 0 1-1.06 0L2.47 8.28a.75.75 0 0 1 0-1.06l4.25-4.25a.751.751 0 0 1 1.042.018.751.751 0 0 1 .018 1.042L4.81 7h7.44a.75.75 0 0 1 0 1.5H4.81l2.97 2.97a.75.75 0 0 1 0 1.06Z"></path></svg></span><span data-component="text" class="prc-Button-Label-FWkx3">Files</span></span></button><button data-component="IconButton" type="button" data-testid="expand-file-tree-button" aria-expanded="false" aria-controls="repos-file-tree" class="prc-Button-ButtonBase-9n-Xk position-relative ExpandFileTreeButton-module__expandButton__rEZZsDe ExpandFileTreeButton-module__filesButtonBreakpoint__A9ISuMX fgColor-muted prc-Button-IconButton-fyge7" data-loading="false" data-no-visuals="true" data-size="medium" data-variant="invisible" aria-labelledby="_R_9b9lab_"><svg aria-hidden="true" focusable="false" class="octicon octicon-sidebar-collapse" viewBox="0 0 16 16" width="16" height="16" fill="currentColor" display="inline-block" overflow="visible" style="vertical-align:text-bottom"><path d="M6.823 7.823a.25.25 0 0 1 0 .354l-2.396 2.396A.25.25 0 0 1 4 10.396V5.604a.25.25 0 0 1 .427-.177Z"></path><path d="M1.75 0h12.5C15.216 0 16 .784 16 1.75v12.5A1.75 1.75 0 0 1 14.25 16H1.75A1.75 1.75 0 0 1 0 14.25V1.75C0 .784.784 0 1.75 0ZM1.5 1.75v12.5c0 .138.112.25.25.25H9.5v-13H1.75a.25.25 0 0 0-.25.25ZM11 14.5h3.25a.25.25 0 0 0 .25-.25V1.75a.25.25 0 0 0-.25-.25H11Z"></path></svg></button><span class="prc-TooltipV2-Tooltip-tLeuB" data-direction="se" aria-hidden="true" id="_R_9b9lab_">Expand file tree</span><button hidden="" data-testid="" data-hotkey-scope="read-only-cursor-text-area"></button></h2></div><div class="react-code-view-header-mb--narrow mr-2"><button type="button" aria-haspopup="true" aria-expanded="false" tabindex="0" aria-label="main branch" data-testid="anchor-button" class="prc-Button-ButtonBase-9n-Xk ref-selector-class RefSelectorAnchoredOverlay-module__RefSelectorOverlayBtn___JIX2hJ" data-loading="false" data-size="medium" data-variant="default" id="ref-picker-repos-header-ref-selector-wide"><span data-component="buttonContent" data-align="center" class="prc-Button-ButtonContent-Iohp5"><span data-component="text" class="prc-Button-Label-FWkx3"><div class="RefSelectorAnchoredOverlay-module__RefSelectorOverlayContainer__yCloy3g"><div class="RefSelectorAnchoredOverlay-module__RefSelectorOverlayHeader__zA8XfwW"><svg aria-hidden="true" focusable="false" class="octicon octicon-git-branch" viewBox="0 0 16 16" width="16" height="16" fill="currentColor" display="inline-block" overflow="visible" style="vertical-align:text-bottom"><path d="M9.5 3.25a2.25 2.25 0 1 1 3 2.122V6A2.5 2.5 0 0 1 10 8.5H6a1 1 0 0 0-1 1v1.128a2.251 2.251 0 1 1-1.5 0V5.372a2.25 2.25 0 1 1 1.5 0v1.836A2.493 2.493 0 0 1 6 7h4a1 1 0 0 0 1-1v-.628A2.25 2.25 0 0 1 9.5 3.25Zm-6 0a.75.75 0 1 0 1.5 0 .75.75 0 0 0-1.5 0Zm8.25-.75a.75.75 0 1 0 0 1.5.75.75 0 0 0 0-1.5ZM4.25 12a.75.75 0 1 0 0 1.5.75.75 0 0 0 0-1.5Z"></path></svg></div><div style="max-width:125px" class="ref-selector-button-text-container RefSelectorAnchoredOverlay-module__RefSelectorBtnTextContainer__AUMBIdr"><span class="RefSelectorAnchoredOverlay-module__RefSelectorText__cr_6IZh"> <!-- -->main</span></div></div></span><span data-component="trailingVisual" class="prc-Button-Visual-YNt2F prc-Button-VisualWrap-E4cnq"><svg aria-hidden="true" focusable="false" class="octicon octicon-triangle-down" viewBox="0 0 16 16" width="16" height="16" fill="currentColor" display="inline-block" overflow="visible" style="vertical-align:text-bottom"><path d="m4.427 7.427 3.396 3.396a.25.25 0 0 0 .354 0l3.396-3.396A.25.25 0 0 0 11.396 7H4.604a.25.25 0 0 0-.177.427Z"></path></svg></span></span></button><button hidden="" data-testid="ref-selector-hotkey-button" data-hotkey-scope="read-only-cursor-text-area"></button></div><div class="react-code-view-header-mb--narrow CodeViewHeader-module__Box_5__hHY3CCD"><div class="Breadcrumb-module__container__aEAUiP7 Breadcrumb-module__lg__KxKpkBV"><nav data-testid="breadcrumbs" aria-labelledby="repos-header-breadcrumb-heading" id="repos-header-breadcrumb" class="Breadcrumb-module__nav__BRfbfdO"><h2 class="sr-only ScreenReaderHeading-module__userSelectNone__aUugMbG prc-Heading-Heading-MtWFE" data-testid="screen-reader-heading" id="repos-header-breadcrumb-heading">Breadcrumbs</h2><ol class="Breadcrumb-module__list__qpqFQku"><li class="Breadcrumb-module__listItem__W3_tsXT"><a class="Breadcrumb-module__repoLink__B0mCbkn prc-Link-Link-9ZwDx" data-testid="breadcrumbs-repo-link" href="/labtroll/KiCad-DesignRules/tree/main" data-discover="true">KiCad-DesignRules</a></li><li class="Breadcrumb-module__listItem__W3_tsXT"><span class="Breadcrumb-module__separator__LxqUd1n Breadcrumb-module__lg__KxKpkBV" aria-hidden="true">/</span><a class="Breadcrumb-module__directoryLink__Rw4tjJ3 prc-Link-Link-9ZwDx" href="/labtroll/KiCad-DesignRules/tree/main/JLCPCB" data-discover="true">JLCPCB</a></li></ol></nav><div data-testid="breadcrumbs-filename" class="Breadcrumb-module__filename__YAu0vNQ"><span class="Breadcrumb-module__separator__LxqUd1n Breadcrumb-module__lg__KxKpkBV" aria-hidden="true">/</span><h1 class="Breadcrumb-module__filenameHeading__KgWIvqA Breadcrumb-module__lg__KxKpkBV prc-Heading-Heading-MtWFE" tabindex="-1" id="file-name-id">README.md</h1></div><button data-component="IconButton" type="button" class="prc-Button-ButtonBase-9n-Xk ml-2 prc-Button-IconButton-fyge7" data-loading="false" data-no-visuals="true" data-size="small" data-variant="invisible" aria-labelledby="_R_fb9lab_"><svg aria-hidden="true" focusable="false" class="octicon octicon-copy" viewBox="0 0 16 16" width="16" height="16" fill="currentColor" display="inline-block" overflow="visible" style="vertical-align:text-bottom"><path d="M0 6.75C0 5.784.784 5 1.75 5h1.5a.75.75 0 0 1 0 1.5h-1.5a.25.25 0 0 0-.25.25v7.5c0 .138.112.25.25.25h7.5a.25.25 0 0 0 .25-.25v-1.5a.75.75 0 0 1 1.5 0v1.5A1.75 1.75 0 0 1 9.25 16h-7.5A1.75 1.75 0 0 1 0 14.25Z"></path><path d="M5 1.75C5 .784 5.784 0 6.75 0h7.5C15.216 0 16 .784 16 1.75v7.5A1.75 1.75 0 0 1 14.25 11h-7.5A1.75 1.75 0 0 1 5 9.25Zm1.75-.25a.25.25 0 0 0-.25.25v7.5c0 .138.112.25.25.25h7.5a.25.25 0 0 0 .25-.25v-7.5a.25.25 0 0 0-.25-.25Z"></path></svg></button><span class="CopyToClipboardButton-module__tooltip__eCErBjn prc-TooltipV2-Tooltip-tLeuB" data-direction="nw" aria-label="Copy path" aria-hidden="true" id="_R_fb9lab_">Copy path</span></div></div></div><div class="react-code-view-header-element--wide"><div class="CodeViewHeader-module__Box_7__GuOdVSR"><div class="d-flex gap-2"> <div><div class="Box-sc-62in7e-0 CodeViewHeader-module__FileResultsList__q5KHdj_"><span class="TextInput__StyledTextInput-sc-ttxlvl-0 d-flex FileResultsList-module__FilesSearchBox__VEX5_qz TextInput-wrapper prc-components-TextInputWrapper-Hpdqi prc-components-TextInputBaseWrapper-wY-n0" data-leading-visual="true" data-trailing-visual="true" aria-busy="false"><span class="TextInput-icon" id="_R_2phj9lab_" aria-hidden="true"><svg aria-hidden="true" focusable="false" class="octicon octicon-search" viewBox="0 0 16 16" width="16" height="16" fill="currentColor" display="inline-block" overflow="visible" style="vertical-align:text-bottom"><path d="M10.68 11.74a6 6 0 0 1-7.922-8.982 6 6 0 0 1 8.982 7.922l3.04 3.04a.749.749 0 0 1-.326 1.275.749.749 0 0 1-.734-.215ZM11.5 7a4.499 4.499 0 1 0-8.997 0A4.499 4.499 0 0 0 11.5 7Z"></path></svg></span><input type="text" aria-label="Go to file" role="combobox" aria-controls="file-results-list" aria-expanded="false" aria-haspopup="dialog" autoCorrect="off" spellCheck="false" placeholder="Go to file" aria-describedby="_R_2phj9lab_ _R_2phj9labH1_" data-component="input" class="prc-components-Input-IwWrt" value=""/><span class="TextInput-icon" id="_R_2phj9labH1_" aria-hidden="true"><kbd>t</kbd></span></span></div><button hidden="" data-testid="" data-hotkey-scope="read-only-cursor-text-area"></button><button hidden=""></button></div><button type="button" class="prc-Button-ButtonBase-9n-Xk Button__StyledButtonComponent-sc-vqy3e4-0 hfSsoj NavigationMenu-module__Button__qhkUiT5" data-loading="false" data-no-visuals="true" data-size="medium" data-variant="default"><span data-component="buttonContent" data-align="center" class="prc-Button-ButtonContent-Iohp5"><span data-component="text" class="prc-Button-Label-FWkx3">Blame</span></span></button><button hidden="" data-testid="" data-hotkey-scope="read-only-cursor-text-area"></button><button data-component="IconButton" type="button" data-testid="more-file-actions-button-nav-menu-wide" aria-haspopup="true" aria-expanded="false" tabindex="0" class="prc-Button-ButtonBase-9n-Xk js-blob-dropdown-click NavigationMenu-module__IconButton__duJXDxm prc-Button-IconButton-fyge7" data-loading="false" data-no-visuals="true" data-size="medium" data-variant="default" aria-labelledby="_R_fihj9lab_" id="_R_ihj9lab_"><svg aria-hidden="true" focusable="false" class="octicon octicon-kebab-horizontal" viewBox="0 0 16 16" width="16" height="16" fill="currentColor" display="inline-block" overflow="visible" style="vertical-align:text-bottom"><path d="M8 9a1.5 1.5 0 1 0 0-3 1.5 1.5 0 0 0 0 3ZM1.5 9a1.5 1.5 0 1 0 0-3 1.5 1.5 0 0 0 0 3Zm13 0a1.5 1.5 0 1 0 0-3 1.5 1.5 0 0 0 0 3Z"></path></svg></button><span class="prc-TooltipV2-Tooltip-tLeuB" data-direction="nw" aria-hidden="true" id="_R_fihj9lab_">More file actions</span> </div></div></div><div class="react-code-view-header-element--narrow"><div class="CodeViewHeader-module__Box_7__GuOdVSR"><div class="d-flex gap-2"> <button type="button" class="prc-Button-ButtonBase-9n-Xk Button__StyledButtonComponent-sc-vqy3e4-0 hfSsoj NavigationMenu-module__Button__qhkUiT5" data-loading="false" data-no-visuals="true" data-size="medium" data-variant="default"><span data-component="buttonContent" data-align="center" class="prc-Button-ButtonContent-Iohp5"><span data-component="text" class="prc-Button-Label-FWkx3">Blame</span></span></button><button hidden="" data-testid="" data-hotkey-scope="read-only-cursor-text-area"></button><button data-component="IconButton" type="button" data-testid="more-file-actions-button-nav-menu-narrow" aria-haspopup="true" aria-expanded="false" tabindex="0" class="prc-Button-ButtonBase-9n-Xk js-blob-dropdown-click NavigationMenu-module__IconButton__duJXDxm prc-Button-IconButton-fyge7" data-loading="false" data-no-visuals="true" data-size="medium" data-variant="default" aria-labelledby="_R_fihr9lab_" id="_R_ihr9lab_"><svg aria-hidden="true" focusable="false" class="octicon octicon-kebab-horizontal" viewBox="0 0 16 16" width="16" height="16" fill="currentColor" display="inline-block" overflow="visible" style="vertical-align:text-bottom"><path d="M8 9a1.5 1.5 0 1 0 0-3 1.5 1.5 0 0 0 0 3ZM1.5 9a1.5 1.5 0 1 0 0-3 1.5 1.5 0 0 0 0 3Zm13 0a1.5 1.5 0 1 0 0-3 1.5 1.5 0 0 0 0 3Z"></path></svg></button><span class="prc-TooltipV2-Tooltip-tLeuB" data-direction="nw" aria-hidden="true" id="_R_fihr9lab_">More file actions</span> </div></div></div></div></div></div></div></div><div class="Box-sc-62in7e-0 jyTWxL react-code-view-bottom-padding">  <!-- --> <!-- --> </div><div class="Box-sc-62in7e-0 jyTWxL"> <!-- --> <!-- --> <button hidden="" data-testid="" data-hotkey-scope="read-only-cursor-text-area"></button><button hidden=""></button><div class="d-flex flex-column border rounded-2 pr-mb-3 pl-1"><div class="LatestCommit-module__Box__HssRvyQ"><h2 class="sr-only ScreenReaderHeading-module__userSelectNone__aUugMbG prc-Heading-Heading-MtWFE" data-testid="screen-reader-heading">Latest commit</h2><div class="d-flex flex-shrink-0 gap-2"><div class="d-flex gap-2"><h2 class="sr-only ScreenReaderHeading-module__userSelectNone__aUugMbG prc-Heading-Heading-MtWFE" data-testid="screen-reader-heading">History</h2><a href="/labtroll/KiCad-DesignRules/commits/main/JLCPCB/README.md" class="prc-Button-ButtonBase-9n-Xk d-none d-lg-flex LinkButton-module__linkButton__JN9f0Tw flex-items-center fgColor-default" data-loading="false" data-size="small" data-variant="invisible"><span data-component="buttonContent" data-align="center" class="prc-Button-ButtonContent-Iohp5"><span data-component="leadingVisual" class="prc-Button-Visual-YNt2F prc-Button-VisualWrap-E4cnq"><svg aria-hidden="true" focusable="false" class="octicon octicon-history" viewBox="0 0 16 16" width="16" height="16" fill="currentColor" display="inline-block" overflow="visible" style="vertical-align:text-bottom"><path d="m.427 1.927 1.215 1.215a8.002 8.002 0 1 1-1.6 5.685.75.75 0 1 1 1.493-.154 6.5 6.5 0 1 0 1.18-4.458l1.358 1.358A.25.25 0 0 1 3.896 6H.25A.25.25 0 0 1 0 5.75V2.104a.25.25 0 0 1 .427-.177ZM7.75 4a.75.75 0 0 1 .75.75v2.992l2.028.812a.75.75 0 0 1-.557 1.392l-2.5-1A.751.751 0 0 1 7 8.25v-3.5A.75.75 0 0 1 7.75 4Z"></path></svg></span><span data-component="text" class="prc-Button-Label-FWkx3"><span class="fgColor-default">History</span></span></span></a><div class="d-flex d-lg-none"><a aria-label="View commit history for this file." href="/labtroll/KiCad-DesignRules/commits/main/JLCPCB/README.md" class="prc-Button-ButtonBase-9n-Xk LinkButton-module__linkButton__JN9f0Tw flex-items-center fgColor-default" data-loading="false" data-size="small" data-variant="invisible" aria-describedby="_R_4mlal9lab_"><span data-component="buttonContent" data-align="center" class="prc-Button-ButtonContent-Iohp5"><span data-component="leadingVisual" class="prc-Button-Visual-YNt2F prc-Button-VisualWrap-E4cnq"><svg aria-hidden="true" focusable="false" class="octicon octicon-history" viewBox="0 0 16 16" width="16" height="16" fill="currentColor" display="inline-block" overflow="visible" style="vertical-align:text-bottom"><path d="m.427 1.927 1.215 1.215a8.002 8.002 0 1 1-1.6 5.685.75.75 0 1 1 1.493-.154 6.5 6.5 0 1 0 1.18-4.458l1.358 1.358A.25.25 0 0 1 3.896 6H.25A.25.25 0 0 1 0 5.75V2.104a.25.25 0 0 1 .427-.177ZM7.75 4a.75.75 0 0 1 .75.75v2.992l2.028.812a.75.75 0 0 1-.557 1.392l-2.5-1A.751.751 0 0 1 7 8.25v-3.5A.75.75 0 0 1 7.75 4Z"></path></svg></span></span></a><span class="prc-TooltipV2-Tooltip-tLeuB" data-direction="s" role="tooltip" aria-hidden="true" id="_R_4mlal9lab_">History</span></div></div></div></div></div><div class="Box-sc-62in7e-0 hGzGyY"><div class="Box-sc-62in7e-0 cJXRZE container"><div class="Box-sc-62in7e-0 fpyUWF react-code-size-details-banner"><div class="react-code-size-details-banner CodeSizeDetails-module__Box__T1NTcbD"><div class="text-mono CodeSizeDetails-module__Box_1__DTD64Js"><div data-testid="blob-size" class="CodeSizeDetails-module__Truncate_1__uL95k0z prc-Truncate-Truncate-2G1eo" data-inline="true" title="26 Bytes" style="--truncate-max-width:100%"><span>1 lines (1 loc) · 26 Bytes</span></div></div></div></div><div class="Box-sc-62in7e-0 iafbuG react-blob-view-header-sticky" id="repos-sticky-header"><div class="BlobViewHeader-module__Box___zFtzH0"><div class="react-blob-sticky-header"><div class="Box-sc-62in7e-0 iNRqcN"><div class="FileNameStickyHeader-module__Box_1__PihNrpM"><div class="FileNameStickyHeader-module__Box_2__is_Wc9k"><div class="FileNameStickyHeader-module__Box_3__xyHkds8"><button type="button" aria-haspopup="true" aria-expanded="false" tabindex="0" aria-label="main branch" data-testid="anchor-button" class="prc-Button-ButtonBase-9n-Xk ref-selector-class RefSelectorAnchoredOverlay-module__RefSelectorOverlayBtn___JIX2hJ" data-loading="false" data-size="medium" data-variant="default" id="ref-picker-repos-header-ref-selector"><span data-component="buttonContent" data-align="center" class="prc-Button-ButtonContent-Iohp5"><span data-component="text" class="prc-Button-Label-FWkx3"><div class="RefSelectorAnchoredOverlay-module__RefSelectorOverlayContainer__yCloy3g"><div class="RefSelectorAnchoredOverlay-module__RefSelectorOverlayHeader__zA8XfwW"><svg aria-hidden="true" focusable="false" class="octicon octicon-git-branch" viewBox="0 0 16 16" width="16" height="16" fill="currentColor" display="inline-block" overflow="visible" style="vertical-align:text-bottom"><path d="M9.5 3.25a2.25 2.25 0 1 1 3 2.122V6A2.5 2.5 0 0 1 10 8.5H6a1 1 0 0 0-1 1v1.128a2.251 2.251 0 1 1-1.5 0V5.372a2.25 2.25 0 1 1 1.5 0v1.836A2.493 2.493 0 0 1 6 7h4a1 1 0 0 0 1-1v-.628A2.25 2.25 0 0 1 9.5 3.25Zm-6 0a.75.75 0 1 0 1.5 0 .75.75 0 0 0-1.5 0Zm8.25-.75a.75.75 0 1 0 0 1.5.75.75 0 0 0 0-1.5ZM4.25 12a.75.75 0 1 0 0 1.5.75.75 0 0 0 0-1.5Z"></path></svg></div><div style="max-width:125px" class="ref-selector-button-text-container RefSelectorAnchoredOverlay-module__RefSelectorBtnTextContainer__AUMBIdr"><span class="RefSelectorAnchoredOverlay-module__RefSelectorText__cr_6IZh"> <!-- -->main</span></div></div></span><span data-component="trailingVisual" class="prc-Button-Visual-YNt2F prc-Button-VisualWrap-E4cnq"><svg aria-hidden="true" focusable="false" class="octicon octicon-triangle-down" viewBox="0 0 16 16" width="16" height="16" fill="currentColor" display="inline-block" overflow="visible" style="vertical-align:text-bottom"><path d="m4.427 7.427 3.396 3.396a.25.25 0 0 0 .354 0l3.396-3.396A.25.25 0 0 0 11.396 7H4.604a.25.25 0 0 0-.177.427Z"></path></svg></span></span></button><button hidden="" data-testid="ref-selector-hotkey-button" data-hotkey-scope="read-only-cursor-text-area"></button></div><div class="FileNameStickyHeader-module__Box_4__YX0NJG5"><div class="Breadcrumb-module__container__aEAUiP7 Breadcrumb-module__md__xR00nBb"><nav data-testid="breadcrumbs" aria-labelledby="sticky-breadcrumb-heading" id="sticky-breadcrumb" class="Breadcrumb-module__nav__BRfbfdO"><h2 class="sr-only ScreenReaderHeading-module__userSelectNone__aUugMbG prc-Heading-Heading-MtWFE" data-testid="screen-reader-heading" id="sticky-breadcrumb-heading">Breadcrumbs</h2><ol class="Breadcrumb-module__list__qpqFQku"><li class="Breadcrumb-module__listItem__W3_tsXT"><a class="Breadcrumb-module__repoLink__B0mCbkn prc-Link-Link-9ZwDx" data-testid="breadcrumbs-repo-link" href="/labtroll/KiCad-DesignRules/tree/main" data-discover="true">KiCad-DesignRules</a></li><li class="Breadcrumb-module__listItem__W3_tsXT"><span class="Breadcrumb-module__separator__LxqUd1n Breadcrumb-module__md__xR00nBb" aria-hidden="true">/</span><a class="Breadcrumb-module__directoryLink__Rw4tjJ3 prc-Link-Link-9ZwDx" href="/labtroll/KiCad-DesignRules/tree/main/JLCPCB" data-discover="true">JLCPCB</a></li></ol></nav><div data-testid="breadcrumbs-filename" class="Breadcrumb-module__filename__YAu0vNQ"><span class="Breadcrumb-module__separator__LxqUd1n Breadcrumb-module__md__xR00nBb" aria-hidden="true">/</span><h1 class="Breadcrumb-module__filenameHeading__KgWIvqA Breadcrumb-module__md__xR00nBb prc-Heading-Heading-MtWFE" tabindex="-1" id="sticky-file-name-id">README.md</h1></div></div></div></div><button type="button" class="prc-Button-ButtonBase-9n-Xk Button__StyledButtonComponent-sc-vqy3e4-0 FileNameStickyHeader-module__Button__oFPUtut FileNameStickyHeader-module__GoToTopButton__aYhdOCU" data-loading="false" data-size="small" data-variant="invisible"><span data-component="buttonContent" data-align="center" class="prc-Button-ButtonContent-Iohp5"><span data-component="leadingVisual" class="prc-Button-Visual-YNt2F prc-Button-VisualWrap-E4cnq"><svg aria-hidden="true" focusable="false" class="octicon octicon-arrow-up" viewBox="0 0 16 16" width="16" height="16" fill="currentColor" display="inline-block" overflow="visible" style="vertical-align:text-bottom"><path d="M3.47 7.78a.75.75 0 0 1 0-1.06l4.25-4.25a.75.75 0 0 1 1.06 0l4.25 4.25a.751.751 0 0 1-.018 1.042.751.751 0 0 1-1.042.018L9 4.81v7.44a.75.75 0 0 1-1.5 0V4.81L4.53 7.78a.75.75 0 0 1-1.06 0Z"></path></svg></span><span data-component="text" class="prc-Button-Label-FWkx3">Top</span></span></button></div></div></div><div class="BlobViewHeader-module__Box_1__jQZ88Uz"><h2 class="sr-only ScreenReaderHeading-module__userSelectNone__aUugMbG prc-Heading-Heading-MtWFE" data-testid="screen-reader-heading">File metadata and controls</h2><div class="BlobViewHeader-module__Box_2__GaW70Bh"><ul aria-label="File view" class="prc-SegmentedControl-SegmentedControl-lqIXp BlobTabButtons-module__SegmentedControl__YDO7GlP" data-variant="default" data-size="small"><li class="prc-SegmentedControl-Item-tSCQh" data-selected=""><button aria-current="true" class="prc-SegmentedControl-Button-E48xz" type="button" style="--separator-color:transparent"><span class="prc-SegmentedControl-Content-1COlk segmentedControl-content"><div class="prc-SegmentedControl-Text-7S2y2 segmentedControl-text" data-text="Preview">Preview</div></span></button></li><li class="prc-SegmentedControl-Item-tSCQh"><button aria-current="false" class="prc-SegmentedControl-Button-E48xz" type="button" style="--separator-color:var(--borderColor-default)"><span class="prc-SegmentedControl-Content-1COlk segmentedControl-content"><div class="prc-SegmentedControl-Text-7S2y2 segmentedControl-text" data-text="Code">Code</div></span></button></li><li class="prc-SegmentedControl-Item-tSCQh"><button aria-current="false" class="prc-SegmentedControl-Button-E48xz" type="button" style="--separator-color:var(--borderColor-default)"><span class="prc-SegmentedControl-Content-1COlk segmentedControl-content"><div class="prc-SegmentedControl-Text-7S2y2 segmentedControl-text" data-text="Blame">Blame</div></span></button></li></ul><button hidden="" data-testid="" data-hotkey-scope="read-only-cursor-text-area"></button><button hidden="" data-testid="" data-hotkey-scope="read-only-cursor-text-area"></button><button hidden="" data-testid="" data-hotkey-scope="read-only-cursor-text-area"></button><div class="react-code-size-details-in-header CodeSizeDetails-module__Box__T1NTcbD"><div class="text-mono CodeSizeDetails-module__Box_1__DTD64Js"><div data-testid="blob-size" class="CodeSizeDetails-module__Truncate_1__uL95k0z prc-Truncate-Truncate-2G1eo" data-inline="true" title="26 Bytes" style="--truncate-max-width:100%"><span>1 lines (1 loc) · 26 Bytes</span></div></div></div></div><div class="BlobViewHeader-module__Box_3__c6abRLe"><div class="react-blob-header-edit-and-raw-actions BlobViewHeader-module__Box_4__v32VgJ7"><div class="prc-ButtonGroup-ButtonGroup-vFUrY"><div><a href="https://github.com/labtroll/KiCad-DesignRules/raw/refs/heads/main/JLCPCB/README.md" data-testid="raw-button" class="prc-Button-ButtonBase-9n-Xk LinkButton-module__linkButton__JN9f0Tw BlobViewHeader-module__LinkButton__J12MgkY" data-loading="false" data-no-visuals="true" data-size="small" data-variant="default"><span data-component="buttonContent" data-align="center" class="prc-Button-ButtonContent-Iohp5"><span data-component="text" class="prc-Button-Label-FWkx3">Raw</span></span></a></div><div><button data-component="IconButton" type="button" data-testid="copy-raw-button" class="prc-Button-ButtonBase-9n-Xk prc-Button-IconButton-fyge7" data-loading="false" data-no-visuals="true" data-size="small" data-variant="default" aria-labelledby="_R_pbecpal9lab_"><svg aria-hidden="true" focusable="false" class="octicon octicon-copy" viewBox="0 0 16 16" width="16" height="16" fill="currentColor" display="inline-block" overflow="visible" style="vertical-align:text-bottom"><path d="M0 6.75C0 5.784.784 5 1.75 5h1.5a.75.75 0 0 1 0 1.5h-1.5a.25.25 0 0 0-.25.25v7.5c0 .138.112.25.25.25h7.5a.25.25 0 0 0 .25-.25v-1.5a.75.75 0 0 1 1.5 0v1.5A1.75 1.75 0 0 1 9.25 16h-7.5A1.75 1.75 0 0 1 0 14.25Z"></path><path d="M5 1.75C5 .784 5.784 0 6.75 0h7.5C15.216 0 16 .784 16 1.75v7.5A1.75 1.75 0 0 1 14.25 11h-7.5A1.75 1.75 0 0 1 5 9.25Zm1.75-.25a.25.25 0 0 0-.25.25v7.5c0 .138.112.25.25.25h7.5a.25.25 0 0 0 .25-.25v-7.5a.25.25 0 0 0-.25-.25Z"></path></svg></button><span class="prc-TooltipV2-Tooltip-tLeuB" data-direction="n" aria-hidden="true" id="_R_pbecpal9lab_">Copy raw file</span></div><div><button data-component="IconButton" type="button" data-testid="download-raw-button" sx="[object Object]" class="prc-Button-ButtonBase-9n-Xk prc-Button-IconButton-fyge7" data-loading="false" data-no-visuals="true" data-size="small" data-variant="default" aria-labelledby="_R_dbecpal9lab_"><svg aria-hidden="true" focusable="false" class="octicon octicon-download" viewBox="0 0 16 16" width="16" height="16" fill="currentColor" display="inline-block" overflow="visible" style="vertical-align:text-bottom"><path d="M2.75 14A1.75 1.75 0 0 1 1 12.25v-2.5a.75.75 0 0 1 1.5 0v2.5c0 .138.112.25.25.25h10.5a.25.25 0 0 0 .25-.25v-2.5a.75.75 0 0 1 1.5 0v2.5A1.75 1.75 0 0 1 13.25 14Z"></path><path d="M7.25 7.689V2a.75.75 0 0 1 1.5 0v5.689l1.97-1.969a.749.749 0 1 1 1.06 1.06l-3.25 3.25a.749.749 0 0 1-1.06 0L4.22 6.78a.749.749 0 1 1 1.06-1.06l1.97 1.969Z"></path></svg></button><span class="prc-TooltipV2-Tooltip-tLeuB" data-direction="n" aria-hidden="true" id="_R_dbecpal9lab_">Download raw file</span></div></div><button hidden="" data-testid="raw-button-shortcut" data-hotkey-scope="read-only-cursor-text-area"></button><button hidden="" data-testid="copy-raw-button-shortcut" data-hotkey-scope="read-only-cursor-text-area"></button><button hidden="" data-testid="download-raw-button-shortcut" data-hotkey-scope="read-only-cursor-text-area"></button><button hidden="" data-testid="" data-hotkey-scope="read-only-cursor-text-area"></button><button hidden="" data-testid="" data-hotkey-scope="read-only-cursor-text-area"></button><div class="prc-ButtonGroup-ButtonGroup-vFUrY"><div><a data-component="IconButton" type="button" data-testid="edit-button" class="prc-Button-ButtonBase-9n-Xk LinkButton-module__linkButton__JN9f0Tw prc-Button-IconButton-fyge7" data-loading="false" data-no-visuals="true" data-size="small" data-variant="default" aria-labelledby="_R_6jecpal9lab_" href="/labtroll/KiCad-DesignRules/edit/main/JLCPCB/README.md" data-discover="true"><svg aria-hidden="true" focusable="false" class="octicon octicon-pencil" viewBox="0 0 16 16" width="16" height="16" fill="currentColor" display="inline-block" overflow="visible" style="vertical-align:text-bottom"><path d="M11.013 1.427a1.75 1.75 0 0 1 2.474 0l1.086 1.086a1.75 1.75 0 0 1 0 2.474l-8.61 8.61c-.21.21-.47.364-.756.445l-3.251.93a.75.75 0 0 1-.927-.928l.929-3.25c.081-.286.235-.547.445-.758l8.61-8.61Zm.176 4.823L9.75 4.81l-6.286 6.287a.253.253 0 0 0-.064.108l-.558 1.953 1.953-.558a.253.253 0 0 0 .108-.064Zm1.238-3.763a.25.25 0 0 0-.354 0L10.811 3.75l1.439 1.44 1.263-1.263a.25.25 0 0 0 0-.354Z"></path></svg></a><span class="prc-TooltipV2-Tooltip-tLeuB" data-direction="nw" aria-hidden="true" id="_R_6jecpal9lab_">Fork this repository and edit the file</span></div><div><button data-component="IconButton" type="button" data-testid="more-edit-button" aria-haspopup="true" aria-expanded="false" tabindex="0" class="prc-Button-ButtonBase-9n-Xk prc-Button-IconButton-fyge7" data-loading="false" data-no-visuals="true" data-size="small" data-variant="default" aria-labelledby="_R_7qjecpal9lab_" id="_R_ajecpal9lab_"><svg aria-hidden="true" focusable="false" class="octicon octicon-triangle-down" viewBox="0 0 16 16" width="16" height="16" fill="currentColor" display="inline-block" overflow="visible" style="vertical-align:text-bottom"><path d="m4.427 7.427 3.396 3.396a.25.25 0 0 0 .354 0l3.396-3.396A.25.25 0 0 0 11.396 7H4.604a.25.25 0 0 0-.177.427Z"></path></svg></button><span class="prc-TooltipV2-Tooltip-tLeuB" data-direction="nw" aria-hidden="true" id="_R_7qjecpal9lab_">More edit options</span></div></div><button hidden="" data-testid="" data-hotkey="e,Shift+E" data-hotkey-scope="read-only-cursor-text-area"></button></div><div class="react-blob-header-edit-and-raw-actions-combined"><button data-component="IconButton" type="button" title="More file actions" data-testid="more-file-actions-button" aria-haspopup="true" aria-expanded="false" tabindex="0" class="prc-Button-ButtonBase-9n-Xk js-blob-dropdown-click BlobViewHeader-module__IconButton__cpxwzb_ prc-Button-IconButton-fyge7" data-loading="false" data-no-visuals="true" data-size="small" data-variant="invisible" aria-labelledby="_R_fkucpal9lab_" id="_R_kucpal9lab_"><svg aria-hidden="true" focusable="false" class="octicon octicon-kebab-horizontal" viewBox="0 0 16 16" width="16" height="16" fill="currentColor" display="inline-block" overflow="visible" style="vertical-align:text-bottom"><path d="M8 9a1.5 1.5 0 1 0 0-3 1.5 1.5 0 0 0 0 3ZM1.5 9a1.5 1.5 0 1 0 0-3 1.5 1.5 0 0 0 0 3Zm13 0a1.5 1.5 0 1 0 0-3 1.5 1.5 0 0 0 0 3Z"></path></svg></button><span class="prc-TooltipV2-Tooltip-tLeuB" data-direction="nw" aria-hidden="true" id="_R_fkucpal9lab_">Edit and raw actions</span></div></div></div></div></div><div class="Box-sc-62in7e-0 dIDnLY"><section aria-labelledby="file-name-id-wide file-name-id-mobile" class="Box-sc-62in7e-0 iZiBDT"><div class="Box-sc-62in7e-0 lhfNqO js-snippet-clipboard-copy-unpositioned undefined" data-hpc="true"><article class="markdown-body entry-content container-lg" itemprop="text"><div class="markdown-heading" dir="auto"><h1 tabindex="-1" class="heading-element" dir="auto">Design Rules for JLCPCB</h1><a id="user-content-design-rules-for-jlcpcb" class="anchor" aria-label="Permalink: Design Rules for JLCPCB" href="#design-rules-for-jlcpcb"><svg class="octicon octicon-link" viewBox="0 0 16 16" version="1.1" width="16" height="16" aria-hidden="true"><path d="m7.775 3.275 1.25-1.25a3.5 3.5 0 1 1 4.95 4.95l-2.5 2.5a3.5 3.5 0 0 1-4.95 0 .751.751 0 0 1 .018-1.042.751.751 0 0 1 1.042-.018 1.998 1.998 0 0 0 2.83 0l2.5-2.5a2.002 2.002 0 0 0-2.83-2.83l-1.25 1.25a.751.751 0 0 1-1.042-.018.751.751 0 0 1-.018-1.042Zm-4.69 9.64a1.998 1.998 0 0 0 2.83 0l1.25-1.25a.751.751 0 0 1 1.042.018.751.751 0 0 1 .018 1.042l-1.25 1.25a3.5 3.5 0 1 1-4.95-4.95l2.5-2.5a3.5 3.5 0 0 1 4.95 0 .751.751 0 0 1-.018 1.042.751.751 0 0 1-1.042.018 1.998 1.998 0 0 0-2.83 0l-2.5 2.5a1.998 1.998 0 0 0 0 2.83Z"></path></svg></a></div>
</article></div><button hidden=""></button></section></div></div></div> <!-- --> <!-- --> </div></div></div></div></div></div></div><button hidden="" data-testid="" data-hotkey-scope="read-only-cursor-text-area"></button><button hidden=""></button></div> <!-- --> <!-- --> <script type="application/json" id="__PRIMER_DATA__R_0___">{"resolvedServerColorMode":"night"}</script></div>
</react-app>
</turbo-frame>

  </div>

</turbo-frame>

    </main>
  </div>

  </div>

          <footer class="footer pt-7 pb-6 f6 color-fg-muted color-border-subtle p-responsive" role="contentinfo" >
  <h2 class='sr-only'>Footer</h2>

  <div class="d-flex flex-justify-center flex-items-center flex-column-reverse flex-lg-row flex-wrap flex-lg-nowrap">
    <div class="d-flex flex-items-center flex-shrink-0 mx-2">
      <a aria-label="GitHub Homepage" class="footer-octicon mr-2" href="https://github.com">
        <svg aria-hidden="true" height="24" viewBox="0 0 24 24" version="1.1" width="24" data-view-component="true" class="octicon octicon-mark-github">
    <path d="M12 1C5.923 1 1 5.923 1 12c0 4.867 3.149 8.979 7.521 10.436.55.096.756-.233.756-.522 0-.262-.013-1.128-.013-2.049-2.764.509-3.479-.674-3.699-1.292-.124-.317-.66-1.293-1.127-1.554-.385-.207-.936-.715-.014-.729.866-.014 1.485.797 1.691 1.128.99 1.663 2.571 1.196 3.204.907.096-.715.385-1.196.701-1.471-2.448-.275-5.005-1.224-5.005-5.432 0-1.196.426-2.186 1.128-2.956-.111-.275-.496-1.402.11-2.915 0 0 .921-.288 3.024 1.128a10.193 10.193 0 0 1 2.75-.371c.936 0 1.871.123 2.75.371 2.104-1.43 3.025-1.128 3.025-1.128.605 1.513.221 2.64.111 2.915.701.77 1.127 1.747 1.127 2.956 0 4.222-2.571 5.157-5.019 5.432.399.344.743 1.004.743 2.035 0 1.471-.014 2.654-.014 3.025 0 .289.206.632.756.522C19.851 20.979 23 16.854 23 12c0-6.077-4.922-11-11-11Z"></path>
</svg>
</a>
      <span>
        &copy; 2026 GitHub,&nbsp;Inc.
      </span>
    </div>

    <nav aria-label="Footer">
      <h3 class="sr-only" id="sr-footer-heading">Footer navigation</h3>

      <ul class="list-style-none d-flex flex-justify-center flex-wrap mb-2 mb-lg-0" aria-labelledby="sr-footer-heading">

          <li class="mx-2">
            <a data-analytics-event="{&quot;category&quot;:&quot;Footer&quot;,&quot;action&quot;:&quot;go to Terms&quot;,&quot;label&quot;:&quot;text:terms&quot;}" href="https://docs.github.com/site-policy/github-terms/github-terms-of-service" data-view-component="true" class="Link--secondary Link">Terms</a>
          </li>

          <li class="mx-2">
            <a data-analytics-event="{&quot;category&quot;:&quot;Footer&quot;,&quot;action&quot;:&quot;go to privacy&quot;,&quot;label&quot;:&quot;text:privacy&quot;}" href="https://docs.github.com/site-policy/privacy-policies/github-privacy-statement" data-view-component="true" class="Link--secondary Link">Privacy</a>
          </li>

          <li class="mx-2">
            <a data-analytics-event="{&quot;category&quot;:&quot;Footer&quot;,&quot;action&quot;:&quot;go to security&quot;,&quot;label&quot;:&quot;text:security&quot;}" href="https://github.com/security" data-view-component="true" class="Link--secondary Link">Security</a>
          </li>

          <li class="mx-2">
            <a data-analytics-event="{&quot;category&quot;:&quot;Footer&quot;,&quot;action&quot;:&quot;go to status&quot;,&quot;label&quot;:&quot;text:status&quot;}" href="https://www.githubstatus.com/" data-view-component="true" class="Link--secondary Link">Status</a>
          </li>

          <li class="mx-2">
            <a data-analytics-event="{&quot;category&quot;:&quot;Footer&quot;,&quot;action&quot;:&quot;go to community&quot;,&quot;label&quot;:&quot;text:community&quot;}" href="https://github.community/" data-view-component="true" class="Link--secondary Link">Community</a>
          </li>

          <li class="mx-2">
            <a data-analytics-event="{&quot;category&quot;:&quot;Footer&quot;,&quot;action&quot;:&quot;go to docs&quot;,&quot;label&quot;:&quot;text:docs&quot;}" href="https://docs.github.com/" data-view-component="true" class="Link--secondary Link">Docs</a>
          </li>

          <li class="mx-2">
            <a data-analytics-event="{&quot;category&quot;:&quot;Footer&quot;,&quot;action&quot;:&quot;go to contact&quot;,&quot;label&quot;:&quot;text:contact&quot;}" href="https://support.github.com?tags=dotcom-footer" data-view-component="true" class="Link--secondary Link">Contact</a>
          </li>

          <li class="mx-2" >
  <cookie-consent-link>
    <button
      type="button"
      class="Link--secondary underline-on-hover border-0 p-0 color-bg-transparent"
      data-action="click:cookie-consent-link#showConsentManagement"
      data-analytics-event="{&quot;location&quot;:&quot;footer&quot;,&quot;action&quot;:&quot;cookies&quot;,&quot;context&quot;:&quot;subfooter&quot;,&quot;tag&quot;:&quot;link&quot;,&quot;label&quot;:&quot;cookies_link_subfooter_footer&quot;}"
    >
       Manage cookies
    </button>
  </cookie-consent-link>
</li>

<li class="mx-2">
  <cookie-consent-link>
    <button
      type="button"
      class="Link--secondary underline-on-hover border-0 p-0 color-bg-transparent text-left"
      data-action="click:cookie-consent-link#showConsentManagement"
      data-analytics-event="{&quot;location&quot;:&quot;footer&quot;,&quot;action&quot;:&quot;dont_share_info&quot;,&quot;context&quot;:&quot;subfooter&quot;,&quot;tag&quot;:&quot;link&quot;,&quot;label&quot;:&quot;dont_share_info_link_subfooter_footer&quot;}"
    >
      Do not share my personal information
    </button>
  </cookie-consent-link>
</li>

      </ul>
    </nav>
  </div>
</footer>

    <ghcc-consent id="ghcc" class="position-fixed bottom-0 left-0" style="z-index: 999999"
      data-locale="en"
      data-initial-cookie-consent-allowed=""
      data-cookie-consent-required="true"
    ></ghcc-consent>

  <div id="ajax-error-message" class="ajax-error-message flash flash-error" hidden>
    <svg aria-hidden="true" height="16" viewBox="0 0 16 16" version="1.1" width="16" data-view-component="true" class="octicon octicon-alert">
    <path d="M6.457 1.047c.659-1.234 2.427-1.234 3.086 0l6.082 11.378A1.75 1.75 0 0 1 14.082 15H1.918a1.75 1.75 0 0 1-1.543-2.575Zm1.763.707a.25.25 0 0 0-.44 0L1.698 13.132a.25.25 0 0 0 .22.368h12.164a.25.25 0 0 0 .22-.368Zm.53 3.996v2.5a.75.75 0 0 1-1.5 0v-2.5a.75.75 0 0 1 1.5 0ZM9 11a1 1 0 1 1-2 0 1 1 0 0 1 2 0Z"></path>
</svg>
    <button type="button" class="flash-close js-ajax-error-dismiss" aria-label="Dismiss error">
      <svg aria-hidden="true" height="16" viewBox="0 0 16 16" version="1.1" width="16" data-view-component="true" class="octicon octicon-x">
    <path d="M3.72 3.72a.75.75 0 0 1 1.06 0L8 6.94l3.22-3.22a.749.749 0 0 1 1.275.326.749.749 0 0 1-.215.734L9.06 8l3.22 3.22a.749.749 0 0 1-.326 1.275.749.749 0 0 1-.734-.215L8 9.06l-3.22 3.22a.751.751 0 0 1-1.042-.018.751.751 0 0 1-.018-1.042L6.94 8 3.72 4.78a.75.75 0 0 1 0-1.06Z"></path>
</svg>
    </button>
    You can’t perform that action at this time.
  </div>

    <template id="site-details-dialog">
  <details class="details-reset details-overlay details-overlay-dark lh-default color-fg-default hx_rsm" open>
    <summary role="button" aria-label="Close dialog"></summary>
    <details-dialog class="Box Box--overlay d-flex flex-column anim-fade-in fast hx_rsm-dialog hx_rsm-modal">
      <button class="Box-btn-octicon m-0 btn-octicon position-absolute right-0 top-0" type="button" aria-label="Close dialog" data-close-dialog>
        <svg aria-hidden="true" height="16" viewBox="0 0 16 16" version="1.1" width="16" data-view-component="true" class="octicon octicon-x">
    <path d="M3.72 3.72a.75.75 0 0 1 1.06 0L8 6.94l3.22-3.22a.749.749 0 0 1 1.275.326.749.749 0 0 1-.215.734L9.06 8l3.22 3.22a.749.749 0 0 1-.326 1.275.749.749 0 0 1-.734-.215L8 9.06l-3.22 3.22a.751.751 0 0 1-1.042-.018.751.751 0 0 1-.018-1.042L6.94 8 3.72 4.78a.75.75 0 0 1 0-1.06Z"></path>
</svg>
      </button>
      
    </details-dialog>
  </details>
</template>

    <div class="Popover js-hovercard-content position-absolute" style="display: none; outline: none;">
  
</div>

    <template id="snippet-clipboard-copy-button">
  <div class="zeroclipboard-container position-absolute right-0 top-0">
    <clipboard-copy aria-label="Copy" class="ClipboardButton btn js-clipboard-copy m-2 p-0" data-copy-feedback="Copied!" data-tooltip-direction="w">
      <svg aria-hidden="true" height="16" viewBox="0 0 16 16" version="1.1" width="16" data-view-component="true" class="octicon octicon-copy js-clipboard-copy-icon m-2">
    <path d="M0 6.75C0 5.784.784 5 1.75 5h1.5a.75.75 0 0 1 0 1.5h-1.5a.25.25 0 0 0-.25.25v7.5c0 .138.112.25.25.25h7.5a.25.25 0 0 0 .25-.25v-1.5a.75.75 0 0 1 1.5 0v1.5A1.75 1.75 0 0 1 9.25 16h-7.5A1.75 1.75 0 0 1 0 14.25Z"></path><path d="M5 1.75C5 .784 5.784 0 6.75 0h7.5C15.216 0 16 .784 16 1.75v7.5A1.75 1.75 0 0 1 14.25 11h-7.5A1.75 1.75 0 0 1 5 9.25Zm1.75-.25a.25.25 0 0 0-.25.25v7.5c0 .138.112.25.25.25h7.5a.25.25 0 0 0 .25-.25v-7.5a.25.25 0 0 0-.25-.25Z"></path>
</svg>
      <svg aria-hidden="true" height="16" viewBox="0 0 16 16" version="1.1" width="16" data-view-component="true" class="octicon octicon-check js-clipboard-check-icon color-fg-success d-none m-2">
    <path d="M13.78 4.22a.75.75 0 0 1 0 1.06l-7.25 7.25a.75.75 0 0 1-1.06 0L2.22 9.28a.751.751 0 0 1 .018-1.042.751.751 0 0 1 1.042-.018L6 10.94l6.72-6.72a.75.75 0 0 1 1.06 0Z"></path>
</svg>
    </clipboard-copy>
  </div>
</template>
<template id="snippet-clipboard-copy-button-unpositioned">
  <div class="zeroclipboard-container">
    <clipboard-copy aria-label="Copy" class="ClipboardButton btn btn-invisible js-clipboard-copy m-2 p-0 d-flex flex-justify-center flex-items-center" data-copy-feedback="Copied!" data-tooltip-direction="w">
      <svg aria-hidden="true" height="16" viewBox="0 0 16 16" version="1.1" width="16" data-view-component="true" class="octicon octicon-copy js-clipboard-copy-icon">
    <path d="M0 6.75C0 5.784.784 5 1.75 5h1.5a.75.75 0 0 1 0 1.5h-1.5a.25.25 0 0 0-.25.25v7.5c0 .138.112.25.25.25h7.5a.25.25 0 0 0 .25-.25v-1.5a.75.75 0 0 1 1.5 0v1.5A1.75 1.75 0 0 1 9.25 16h-7.5A1.75 1.75 0 0 1 0 14.25Z"></path><path d="M5 1.75C5 .784 5.784 0 6.75 0h7.5C15.216 0 16 .784 16 1.75v7.5A1.75 1.75 0 0 1 14.25 11h-7.5A1.75 1.75 0 0 1 5 9.25Zm1.75-.25a.25.25 0 0 0-.25.25v7.5c0 .138.112.25.25.25h7.5a.25.25 0 0 0 .25-.25v-7.5a.25.25 0 0 0-.25-.25Z"></path>
</svg>
      <svg aria-hidden="true" height="16" viewBox="0 0 16 16" version="1.1" width="16" data-view-component="true" class="octicon octicon-check js-clipboard-check-icon color-fg-success d-none">
    <path d="M13.78 4.22a.75.75 0 0 1 0 1.06l-7.25 7.25a.75.75 0 0 1-1.06 0L2.22 9.28a.751.751 0 0 1 .018-1.042.751.751 0 0 1 1.042-.018L6 10.94l6.72-6.72a.75.75 0 0 1 1.06 0Z"></path>
</svg>
    </clipboard-copy>
  </div>
</template>

    <style>
      .user-mention[href$="/stefan-R75"] {
        color: var(--color-user-mention-fg);
        background-color: var(--bgColor-attention-muted, var(--color-attention-subtle));
        border-radius: 2px;
        margin-left: -2px;
        margin-right: -2px;
      }
      .user-mention[href$="/stefan-R75"]:before,
      .user-mention[href$="/stefan-R75"]:after {
        content: '';
        display: inline-block;
        width: 2px;
      }
    </style>

    </div>

  </body>
</html>
