stefan-R75/STM32-Nucleo-RS232-RS485-Expansion-Board-ST-Zio-and-Arduino-Compatible/05-Documents/Hoofddocument – Rs232 & Rs485 Expansion Board Voor Nucleo-h753zi.docx

# RS232 & RS485 Expansion Board (STM32 Nucleo-144 – H753ZI)

Documentstatus: Concept (levend document)
Projectnaam: STM32 Nucleo RS232 & RS485 Expansion Board V2
Doelplatform: Nucleo H753ZI (NUCLEO-144)

## 0. Versiebeheer

Versie | Datum | Auteur | Wijziging
0.1 | 2026-02-04 | Stefan | Eerste opzet hoofddocument

## 1. Doel en scope

Dit board is een experimenteer en development uitbreidingskaart voor de STM32 Nucleo H753ZI, bedoeld om snel en betrouwbaar te kunnen schakelen tussen: - RS232 met volledige hardware handshaking - RS485 half-duplex (2-wire) - RS485 full-duplex (4-wire) - RS422 (4-wire)

Het board is ontworpen om: - Een universele interface te bieden die naadloos aansluit op zowel de standaard Arduino Uno R3/V3 headers als de uitgebreide STMicroelectronics Zio connector van het NUCLEO-ecosysteem. - Met zo weinig mogelijk extra componenten een robuust en reproduceerbaar ontwerp te realiseren (minder parts, minder faalpunten, sneller te assembleren). - Veel configuraties via fysieke 3-pin jumper headers mogelijk te maken. - Meet- en testpunten te bieden zodat zowel MCU-signalen als de protocol-/datasignalen richting de connectoren eenvoudig te meten en te debuggen zijn. - Zowel “lab-prototyping” als robuuste praktijktesten te ondersteunen.

### 1.1 Niet in scope (voor nu)

- Galvanische isolatie (kan later als variant of add-on)
- Surge/EMC “industrieel eindniveau” (mag later als Rev/variant)
- Automatische protocoldetectie
- Logic-analyzer header voor snelle verificatie van signalen zoals TXD/RXD (TTL), DE/RE, MODE-pinnen, TERM en SLR (bij voorkeur pinout-compatibel met gangbare scope/LA leads, o.a. Rigol MSO5000).
- Bus-fout indicatie (LED of diagnostisch signaal) voor situaties zoals short, open line of contention.
- Loopback/selftest via jumper-selectie voor snelle functionele checks zonder externe apparatuur/kabels.
- Bus-bias en split-terminatie footprints (optioneel te populaten) voor geavanceerde RS485/RS422 busconditionering.

## 2. Kerncomponent: TI THVD4431 multiprotocol transceiver

De basis van het board is de THVD4431 (TI), een multiprotocol transceiver die RS-232 en RS-485/RS-422 combineert.

### 2.1 Waarom deze chip bij uitstek geschikt is

Waarom THVD4431 hier zo lekker in past: - Multiprotocol in 1 IC: één footprint voor RS232 én RS485/RS422. - RS-232 3T5R: ondersteunt een complete RS232-poort met data + handshaking (3 transmitters, 5 receivers). - RS-485 half én full duplex: één transmitter/receiver-pad voor 2-wire of 4-wire topologie. - Mode-pinnen (MODE0/1/2): protocolkeuze via logica, ideaal voor jumpers of MCU-control. - Switchable terminatie (TERM): geïntegreerde 120 Ω terminatie voor RS-485, handig voor experimenten. - Slew rate control (SLR): keuze tussen lagere EMI of hogere snelheid. - Gescheiden logica-voeding (VIO): eenvoudiger compatibel maken met 3V3 of 5V logica (afhankelijk van shield/IOREF keuzes).

## 3. Functies en instelopties (hoog niveau)

Onderstaande opties willen we op het board kunnen instellen via fysieke 3-pin jumper headers (met shunt) en duidelijke silkscreen-labels.

Ontwerpregel: we gebruiken geen soldeeropties (geen solder jumpers/bridges). Alles moet snel, herhaalbaar en zonder soldeerbout te wisselen zijn. Dit is de “menukaart”.

### 3.1 Protocol- en mode-selectie (THVD4431)

De THVD4431 biedt meerdere device modes die via de MODE-pinnen geselecteerd worden. Functioneel willen we op dit board de volgende modes kunnen kiezen: - RS-232 3T5R mode (volledige RS232 poort met data + handshaking) - RS-232 diagnostische loopback mode (interne terugkoppeling voor pad- en kabel/connector-check) - RS-485 half-duplex mode (2-wire) - RS-485 full-duplex mode (4-wire) - RS-485 diagnostische loopback mode (interne terugkoppeling voor bus-side integriteitscheck)

RS-422: functioneel wordt RS-422 op dit board behandeld als 4-wire differentiële point-to-point communicatie en valt daarmee onder dezelfde basis-instellingen als RS-485 full-duplex. Waar relevant noemen we dit expliciet (zie 3.2.3).

### 3.2 Instelopties per protocol (THVD4431)

Onderstaande opties zijn de ‘knoppen’ die de THVD4431 zelf aanbiedt (control pins). In dit hoofdstuk benoemen we alleen wat instelbaar is; hoe we dat exact doen (jumper-standen, defaults, pin-mapping) leggen we later vast.

#### 3.2.1 Gemeenschappelijke opties (geldt voor alle protocollen)

- SHDN (shutdown / enable): device aan/uit (ultra-low power in shutdown; bus/logic outputs in high-Z)
- SLR (slew rate / max data rate keuze): selecteert een ‘langzame’ modus met lagere EMI versus een ‘snelle’ modus met hogere snelheid

#### 3.2.2 RS-232 instelopties

- RS-232 mode selectie: keuze tussen 3T5R en RS-232 loopback
- Data rate klasse via SLR: ‘slow’ versus ‘fast’ RS-232 snelheid
- (De)activeren via SHDN: enige manier om RS-232 drivers/receivers uit te schakelen is via shutdown

#### 3.2.3 RS-485 instelopties (incl. RS-422)

- Half- versus full-duplex selectie: keuze tussen 2-wire (half duplex) en 4-wire (full duplex)
- Driver enable/disable via DIR: differentiële driver actief of in high-impedance (bus vrijgeven)
- Receiver enable gedrag (half duplex): in half-duplex mode wordt de receiver functionaliteit door DIR beïnvloed (RX aan/uit afhankelijk van TX enable)
- Interne terminatie (120 Ω) via TERM_TX / TERM_RX:
  - TERM_TX: schakelbare 120 Ω terminatie over het driver-paar
  - TERM_RX: schakelbare 120 Ω terminatie over het receiver-paar (alleen relevant in full-duplex)
- Data rate klasse via SLR: ‘slow’ versus ‘fast’ RS-485 snelheid (slow mode biedt extra filtering in de receiver path)
- RS-485 loopback mode: diagnostische interne terugkoppeling; hierbij gelden specifieke beperkingen op bepaalde control-functies (leggen we later vast)

### 3.2.4 Exacte configuratie (THVD4431 control pins)

In dit hoofdstuk leggen we per functie vast welke control pin(s) je moet instellen en welke logische toestand daarbij hoort.

Logicaniveaus: - H (HIGH) = VIO - L (LOW) = GND

Op dit board worden deze signalen in de praktijk via 3‑pin jumper headers aangeboden zodat iedere control pin deterministisch naar VIO of GND wordt getrokken (in plaats van “zwevend”).

#### 3.2.4.1 Overzicht instelbare control pins

Pin | Functie | H = VIO | L = GND | Interne default (als pin open is)
SHDN | Enable/Shutdown | Device actief | Shutdown (alles Hi‑Z) | Pull‑down → shutdown
SLR | Slew rate / speed select | Slow/low‑EMI | Fast/high‑speed | Pull‑down → fast
DIR | RS485 driver enable (en HD receiver gating) | Driver enabled | Driver Hi‑Z | Pull‑down → driver uit
TERM_TX | 120Ω terminatie op R1/R2 | Aan (waar toegestaan) | Uit | Pull‑down → uit
TERM_RX | 120Ω terminatie op R3/R4 | Aan (FD) | Uit | Pull‑down → uit
MODE0/1/2 | Protocol/mode selectie | Zie tabel 3.2.4.2 | Zie tabel 3.2.4.2 | Pull‑down → ‘0’

#### 3.2.4.2 Mode-selectie via MODE2/MODE1/MODE0

MODE2 | MODE1 | MODE0 | Operating mode
X | L | L | RS‑232 loopback
X | L | H | RS‑232 3T5R
X | H | L | RS‑485 half‑duplex (2‑wire)
L of open | H | H | RS‑485 full‑duplex (4‑wire) (incl. RS‑422)
H | H | H | RS‑485 loopback

Belangrijke mode‑transitie regel: - RS‑232 3T5R ↔ RS‑232 loopback mag niet direct. Deze overgang moet via shutdown (SHDN = L) tussendoor.

#### 3.2.4.3 RS‑485 / RS‑422 configuratie

RS‑422 wordt op dit board behandeld als RS‑485 full‑duplex (4‑wire): dezelfde mode‑selectie en dezelfde basisinstellingen.

A) Half‑duplex (2‑wire) - MODE: X, H, L - DIR bepaalt zenden/luisteren: - DIR = H → driver actief (R1/R2 gedreven), receiver disabled (L2 Hi‑Z) - DIR = L (of open) → driver Hi‑Z, receiver enabled - Terminatie: - TERM_TX = H → 120Ω aan over R1/R2 - TERM_TX = L (of open) → 120Ω uit - TERM_RX = don’t care

B) Full‑duplex (4‑wire) / RS‑422 - MODE: L/open, H, H - DIR schakelt alleen de driver (TX‑paar); receiver blijft altijd enabled zolang SHDN = H: - DIR = H → TX driver actief - DIR = L (of open) → TX driver Hi‑Z - Terminatie (individueel): - TERM_TX = H → 120Ω aan over R1/R2 (TX‑paar) - TERM_RX = H → 120Ω aan over R3/R4 (RX‑paar) - L/open → uit

C) Snelheid / EMI (SLR) - SLR = H → RS‑485 max 500 kbps (extra receiver filtering actief) - SLR = L/open → RS‑485 max 20 Mbps

#### 3.2.4.4 RS‑485 loopback configuratie

- MODE: H, H, H
- DIR: don’t care
- TERM_RX: niet ondersteund in deze mode
- Externe terminatie op R3/R4: niet ondersteund
- R1/R2 terminatie: intern of extern toegestaan (TERM_TX werkt)
- Aanbevolen: SLR = H en data rate ≤ 0,5 Mbps voor betrouwbare ‘short detection’.

#### 3.2.4.5 RS‑232 configuratie

A) RS‑232 3T5R - MODE: X, L, H - SHDN = H → actief (charge pump aan) - SLR: - SLR = H → max 250 kbps - SLR = L/open → max 1 Mbps

B) RS‑232 loopback - MODE: X, L, L - SHDN = H → actief (charge pump aan) - SLR: zoals hierboven

Belangrijk (RS‑232): - In RS‑232 mode is SHDN de enige manier om TX/RX volledig uit te zetten.

### 3.3 Statusindicatie (TX/RX)

We voorzien twee status-LED’s met vaste silkscreen-aanduiding TX en RX (dit blijft de hoofdbetekenis op het board), maar de aansturing is selecteerbaar via een 3-pin jumper header per LED.

Belangrijk (platformbeperking): de softwarematige LED-aansturing (SW-GPIO modus) is niet beschikbaar via de Arduino V3 footprint door pin-budget/compatibiliteitskeuzes. Op het STM32 Nucleo-144/Zio platform is SW-GPIO wél beschikbaar.
→ Zie hoofdstuk 6.5 Uitzonderingen (alleen Zio, niet Arduino V3).

Doel: je kunt kiezen tussen “altijd een zichtbare data-activiteit” (hardware) of “volledige vrijheid” (software, desnoods andere functie).

We voorzien twee status-LED’s met vaste silkscreen-aanduiding TX en RX (dit blijft de hoofdbetekenis op het board), maar de aansturing is selecteerbaar via een 3-pin jumper header per LED.

Doel: je kunt kiezen tussen “altijd een zichtbare data-activiteit” (hardware) of “volledige vrijheid” (software, desnoods andere functie).

#### 3.3.1 Modus A – Hardware activiteit (default/optioneel)

In deze modus wordt de LED automatisch getriggerd door de bijbehorende TTL-lijn (TXD of RXD) zodat activiteit altijd zichtbaar is zonder MCU-logica. - TTL signaal → SN74LVC2G14DBV (dual Schmitt-trigger inverter) → RC pulse-stretcher → LED driver (met serieweerstand) - De RC pulse-stretcher zorgt voor een visueel waarneembare blink, ook bij korte pulses of hoge baudrates.

Blink-lengte (zoals in het schema): - R = 453 kΩ (R13/R18) - C ≈ 470 nF + 100 nF = 570 nF (C23/C26 naar GND en C24/C27 naar de 3V3-rail (VCC), aangenomen dat 3V3_SYS/3V3_BOARD door ontkoppeling een lage-impedantie ‘AC ground’ is) - Tijdconstante: τ = R·C ≈ 0,453 MΩ · 0,57 µF ≈ 0,258 s - De Schmitt-trigger schakelt terug zodra de RC-node weer boven de positieve drempel komt. Met een typische drempel rond ~0,5·VCC resulteert dit grofweg in: - t_blink ≈ 0,69·τ ≈ 0,18 s (≈ 180 ms)

Let op: de exacte blinkduur varieert met de daadwerkelijke Schmitt-drempel (process/temperatuur/VCC), maar ligt met deze waarden typisch in de orde van ~150–250 ms.

#### 3.3.2 Modus B – Software / vrij programmeerbaar

In deze modus wordt de LED losgekoppeld van de hardware-activiteit en aangesloten op een MCU GPIO. - Software kan TX/RX-activiteit weergeven, maar kan ook een andere functie krijgen (status, error, mode-indicatie, heartbeat, enz.).

#### 3.3.3 Jumper-selectie

Per LED komt een 3-pin jumper header (midden = LED input) met twee standen: - Stand 1: jumper 1–2 = HW-Activity (via SN74LVC2G14DBV + RC) - Stand 2: jumper 2–3 = SW-GPIO (directe MCU-aansturing)

Opmerking: de exacte polariteit (inverteren) en RC-waarden liggen hiermee vast in het schema; de uiteindelijke blinkduur volgt uit de R·C en de Schmitt-drempels (zie 3.3.1). (inverteren) en RC-waarden leggen we vast zodra we de gewenste ‘blink-lengte’ (bijv. 20–100 ms) kiezen.

$1

### 3.5 Meet- en testpunten (TP) – kleurcodering en signaalgroepen

Om het board écht als ontwikkel- en experimenteerplatform te laten werken, zijn langs de boardrand toegankelijke testpunten opgenomen. Hiermee kun je snel met een multimeter, oscilloscoop of logic probe meten zonder op fine‑pitch IC-pinnen of connectorpads te hoeven prikken.

Ontwerpdoelen van de testpunten: - Snelle bring-up en foutzoeken (zonder ‘meet-naald-acrobatiek’). - Duidelijke scheiding tussen MCU/logic-side en bus/connector-side signalen. - Kleurcodering zodat je in één oogopslag de signaalgroep herkent.

#### 3.5.1 Kleurcodering

- Rood: voedingsspanningen (power rails)
- Zwart: GND referentiepunten
- Groen: logische signalen afkomstig vanaf de MCU (logic-side)
- Blauw: RS232 5T3R signalen (RS232-side / richting DE‑9)
- Oranje: RS485 receiver-paar A/B
- Geel: RS485 driver-paar Y/Z

#### 3.5.2 Power en referentiepunten

TP | Kleur | Net / functie | Opmerking
TP1 | Zwart | GND | Ground referentie (bij 5V/LDO sectie)
TP2 | Rood | 5V_IN | Inkomende 5V (voor LDO) – debug/validatie
TP3 | Rood | 3V3_LDO | 3,3V uit TLV77518 (VIN2 naar TPS2117)
TP4 | Zwart | GND | Ground referentie (bij TPS2117 sectie)
TP5 | Rood | NUCLEO_3V3 | 3,3V inkomend via Zio (VIN1 naar TPS2117)
TP6 | Rood | 3V3_SYS | Board-rail na power‑mux (voedt het hele shield)

#### 3.5.3 Logic-side (MCU) testpunten

Deze testpunten tonen de signalen aan de MCU/logic-kant (handig om firmware, buffering en jumperstanden te verifiëren).

TP | Kleur | Signaal | Opmerking
TP9 | Groen | DCD | Logic-side
TP12 | Groen | RXD | Logic-side
TP15 | Groen | TXD | Logic-side
TP18 | Groen | DTR | Logic-side
TP21 | Groen | RI | Logic-side
TP23 | Groen | RTS | Logic-side
TP25 | Groen | CTS | Logic-side
TP27 | Groen | DSR | Logic-side
TP29 | Zwart | GND | Logic-side referentie

#### 3.5.4 RS232-side (5T3R) testpunten

Deze testpunten geven toegang tot de volledige RS232 5T3R signalenset richting de DE‑9 connector.

TP | Kleur | Signaal | Opmerking
TP10 | Blauw | DCD | RS232-side
TP13 | Blauw | RXD | RS232-side
TP16 | Blauw | TXD | RS232-side
TP19 | Blauw | DTR | RS232-side
TP22 | Zwart | GND | RS232-side referentie
TP24 | Blauw | DSR | RS232-side
TP26 | Blauw | RTS | RS232-side
TP28 | Blauw | CTS | RS232-side
TP30 | Blauw | RI | RS232-side

#### 3.5.5 RS485/RS422 differentiële paren (bus-side)

Voor differentiële metingen is het handig om steeds als paar te meten (bij voorkeur met differentiële probe of twee scope-kanalen + math).

TP | Kleur | Paar | Signaal
TP17 | Oranje | A/B | RX+ (A)
TP20 | Oranje | A/B | RX− (B)
TP14 | Geel | Y/Z | TX+ (Y)
TP11 | Geel | Y/Z | TX− (Z)

Tip: houd meetdraden kort en bij voorkeur getwist per paar om extra common-mode ruis en ‘antenne-effect’ te beperken.

## 4. Mogelijke configuraties met THVD4431

Hier beschrijven we wat er functioneel mogelijk is. De exacte MODE-pin waarheidstabellen nemen we later expliciet over uit de datasheet en vertalen we naar jumpers.

### 4.1 RS232 configuratie

- Volledige RS232-poort met:
  - TxD, RxD
  - Handshaking: RTS, CTS, DTR, DSR, DCD, RI
- Data rates afhankelijk van SLR (low-speed/low-EMI versus high-speed)

### 4.2 RS485 half-duplex (2-wire)

- Eén differentieel paar: A/B (of D+/D- afhankelijk van naming)
- Richting schakelen via driver enable (DE) en receiver enable (RE) gedrag
- Terminatie optioneel inschakelbaar (alleen toepassen aan bus-eindpunten)

### 4.3 RS485 full-duplex (4-wire)

- Twee differentiële paren:
  - TX+ / TX- (board zendt)
  - RX+ / RX- (board ontvangt)
- Terminatie: typisch 120 Ω op het ontvangende uiteinde per paar (afhankelijk van topologie)

## 5. Terminatie richtlijnen (RS485)

Kernregel: RS485 terminatie hoort normaal alleen aan de uiteinden van de bus.

Wat we op het board willen: - Terminatie ON/OFF eenvoudig kunnen togglen. - Duidelijke labeling op silkscreen: “TERM = endpoint only”.

Aanvullend (optioneel, later concretiseren): - Plaats voor externe terminatie of split-terminatie - Plaats voor bias-netwerk (pull-up/pull-down) als de bus dat nodig heeft

## 6. Compatibiliteit

Dit RS232 & RS485 board is ontworpen als ‘drop-in’ uitbreiding voor zowel het STM32 Nucleo-144 ecosysteem als de (mechanische) Arduino Uno R3 / Arduino V3 shield footprint.

### 6.1 ST Zio (NUCLEO-144)

- Volledige mechanische en elektrische aansluiting via de ST Zio connectoren van de Nucleo H753ZI.
- Doel: maximale functionaliteit beschikbaar maken wanneer het board op een Nucleo-144 platform gebruikt wordt.

### 6.2 Arduino Uno R3 / Arduino V3 footprint

- Mechanische compatibiliteit met de Arduino V3 shield headerposities.
- Waar mogelijk worden functies ook op de Arduino-footprint aangeboden, maar het Arduino-pinbudget is beperkter (zie 6.3).

### 6.3 Automatische selectie van logica-niveau (3V3/5V)

Het Nucleo-platform werkt primair op 3,3 V logica, terwijl het Arduino-ecosysteem historisch vaak 5 V gebruikt. Het ontwerp houdt hier rekening mee door het juiste I/O-niveau automatisch te selecteren, zonder dat de gebruiker jumpers hoeft om te zetten of soldeerkeuzes hoeft te maken.

Zie hoofdstuk “Voedingsarchitectuur: 3,3V-only met automatische bronselectie” voor de concrete implementatie en randvoorwaarden.

### 6.4 Pin-allocatie en LCD-shield compatibiliteit

Omdat dit RS232 & RS485 board ook samen gebruikt moet kunnen worden met het X-NUCLEO-GFX02Z1 display expansion board (NUCLEO-144), wordt de pin-keuze zodanig gemaakt dat er geen conflicterende pin-overlapping ontstaat.

Consequence: de set beschikbare/bruikbare signalen op de Arduino V3 footprint kan hierdoor beperkter zijn dan wat via de Zio connector mogelijk is.

### 6.5 Uitzonderingen (alleen Zio, niet Arduino V3)

Functies die wél via Zio beschikbaar zijn, maar door pinconflicten of footprint-beperkingen niet (of niet volledig) via de Arduino V3 headers aangeboden kunnen worden, worden hier expliciet opgesomd.

- TX/RX LED softwaremodus (SW-GPIO): op Arduino V3 niet beschikbaar; op Zio wel (hardwaremodus blijft op beide beschikbaar).
- THVD4431 volledige shutdown via SHDN: SHDN is niet naar een Arduino V3 pin uitgevoerd, waardoor volledige (softwarematige) uitschakeling van de transceiver via Arduino V3 niet mogelijk is. Op Zio is SHDN wél beschikbaar.

Alle overige functies zijn ontworpen om zowel via Zio als via de Arduino V3 footprint beschikbaar te zijn.

## 6.6 Pinbezetting (Zio headers CN7/CN8/CN9/CN10)

Onderstaande tabellen geven de pinbezetting van de gebruikte Zio headers weer zoals toegepast op dit board.

Legenda: - Arduino V3: pin valt binnen de Arduino Uno R3/V3 footprint-compatibele subset. - LCD-bezet: pin is gemarkeerd als bezet door het X-NUCLEO-GFX02Z1 display board (dus niet beschikbaar bij stacking).

Dit is een opzet op basis van de huidige schematische toewijzing. Als je later een complete “alle pins (incl. NC)” tabel wilt, dan kunnen we die genereren vanuit de definitieve KiCad netlist/pinmap.

### 6.6.1 CN8 (SSW-108-23-G-D)

CN8 pin | Signaal / net | Functie | Arduino V3 | LCD-bezet | Opmerking
7 | NUCLEO_3V3 | 3,3V ingang (VIN1 naar TPS2117) | Ja | Nee | Voorkeursbron op Nucleo
9 | ARDUINO_5V (5V_IN) | 5V ingang (naar TLV77518) | Ja | Nee | Wordt lokaal naar 3V3_LDO omgezet
13 | GND | Referentie | Ja | Nee | Power/logic referentie
14 | MCU_RXLED_GPIO | RX LED software-aansturing | Nee | Nee | Zio-only (niet Arduino)
16 | MCU_TXLED_GPIO | TX LED software-aansturing | Nee | Nee | Zio-only (niet Arduino)

### 6.6.2 CN9 (SSW-115-23-G-D)

CN9 pin | Signaal / net | Functie | Arduino V3 | LCD-bezet | Opmerking
1 | MCU_MODE1 | THVD4431 MODE1 (via 330Ω) | Ja | Nee | Serieweerstand voor robuuste IO
5 | MCU_TERM_RX | THVD4431 TERM_RX (via 330Ω) | Ja | Nee | Terminatie RX-paar (full duplex)
7 | MCU_TERM_TX | THVD4431 TERM_TX (via 330Ω) | Ja | Nee | Terminatie TX-paar
9 | MCU_MODE2 | THVD4431 MODE2 (via 330Ω) | Ja | Nee | Serieweerstand voor robuuste IO
30 | MCU_SHDN | THVD4431 SHDN (enable/shutdown) | Nee | Nee | Zio-only (niet Arduino)

### 6.6.3 CN10 (SSW-117-23-G-D)

CN10 pin | Signaal / net | Functie | Arduino V3 | LCD-bezet | Opmerking
2 | MCU_DIR | THVD4431 DIR (via 330Ω) | Ja | Nee | Driver enable / richting control
10 | L7-CTS | RS232 CTS lijn | Nee | Ja | Niet beschikbaar bij LCD stacking
12 | L6-RTS | RS232 RTS lijn | Nee | Nee | Zio-only in deze mapping
14 | L3-TXD | RS232 TXD lijn | Nee | Nee | Zio-only in deze mapping
16 | L2-RXD | RS232 RXD lijn | Ja | Nee | Arduino-compatibel in deze mapping

### 6.6.4 CN7 (SSW-110-23-G-D)

CN7 pin | Signaal / net | Functie | Arduino V3 | LCD-bezet | Opmerking
2 | L8-RI | RS232 RI lijn | Nee | Nee | Zio-only
6 | L5-DSR | RS232 DSR lijn | Nee | Nee | Zio-only
12 | L4-DTR → MCU_SLR | RS232 DTR lijn gekoppeld aan SLR control (via 330Ω) | Nee | Nee | DTR gebruikt als stuurbron voor SLR
16 | L1-DCD | RS232 DCD lijn | Nee | Ja | Niet beschikbaar bij LCD stacking
20 | MCU_MODE0 | THVD4431 MODE0 (via 330Ω) | Ja | Ja | Arduino-compatibel, maar conflicteert met LCD stacking

## 7. Voedingsarchitectuur: 3,3V-only met automatische bronselectie

Het board is intern volledig 3,3 V-gebaseerd. Daarmee blijft de logica rond de THVD4431, buffers en statuslogica consistent en wordt vermeden dat er per platform ‘spanningsvarianten’ ontstaan.

De uitdaging: het STM32 Nucleo-ecosysteem levert standaard 3,3 V, terwijl een Arduino Uno R3/V3 omgeving vaak 5 V aanbiedt. De voeding moet daarom automatisch en foutbestendig gekozen worden, zonder dat de gebruiker jumpers hoeft te verzetten.

### 7.1 Overzicht (blokdiagram)

- Ingang A (VIN1): 3V3 vanaf NUCLEO_3V3 (via ST Zio CN8 pin 7)
- Ingang B (VIN2): 5V ingang (5V_IN, via ST Zio CN8 pin 9 en/of Arduino 5V) → LDO → 3V3
- Uitgang: één centrale rail 3V3_SYS (board-rail) voor het volledige RS232/RS485 board

### 7.2 5 V naar 3,3 V conversie met TLV77518 (TI)

Wanneer het board gevoed wordt vanuit een 5V-bron (typisch Arduino V3/Uno, maar ook beschikbaar op het Nucleo-ecosysteem), wordt die spanning eerst lokaal omgezet naar 3,3 V met een LDO: TI TLV77518PDBVR (3,3 V uitgang).

Waarom TLV77518 hier goed past (praktisch/technisch): - Compacte, moderne LDO die bedoeld is voor 5V→3V3 conversie in mixed-platform designs. - Voldoende stroommarge voor een communicatie-shield met transceiver, logica en LED-indicatie. - EN (enable) pin maakt het eenvoudig om de LDO automatisch actief te laten zijn zodra 5V aanwezig is. - Ingebouwde overstroom- en thermische beveiliging, nuttig bij experimenten en ‘verkeerd prikken’.

De LDO-uitgang noemen we in dit ontwerp 3V3_LDO en die gaat naar VIN2 van de power-mux.

### 7.3 Automatische bronselectie en backfeed-preventie met TPS2117 (TI)

Na conversie hebben we twee potentiële 3,3 V bronnen (Nucleo 3V3 en LDO 3V3). We willen: 1) automatisch de ‘juiste’ bron gebruiken, 2) geen terugvoeding van de ene bron naar de andere, 3) geen terugvoeding richting het host-board.

Een simpele diode-OR is hier ongunstig door spanningsval. Daarom gebruiken we een power-mux: TI TPS2117DRLR.

Waarom TPS2117 hier zo goed past: - Power-mux met geïntegreerde MOSFETs en lage RDS(on) (typ. 20 mΩ), dus minimale spanningsdrop. - Reverse current blocking wanneer VOUT > VINx, waardoor ‘backfeeding’ actief wordt tegengehouden. - Meerdere schakelmodi (priority/manual/diode), zodat we het gedrag deterministisch kunnen maken. - Controlled slew rate / soft-start bij power-up, wat piekstromen en rare reset-glitches helpt beperken. - Ruime stroomcapability (tot 4 A) geeft veel marge, ook al ligt het echte verbruik van dit board daar ver onder.

### 7.4 Beoogde werking in dit project

We configureren de TPS2117 zó dat de voedingkeuze vanzelf ‘meeloopt’ met het platform: - Gebruik op ST Nucleo: VIN1 (Nucleo 3V3) is aanwezig en wordt de primaire/voorkeursbron. - Gebruik op Arduino V3: VIN1 is afwezig (of onder de geldige drempel) en VIN2 (TLV77518PDBVR 3V3 uit Arduino 5V) voedt automatisch de rail.

In priority mode kan een weerstandsdivider naar PR1 gebruikt worden om de switchover-drempel te definiëren (PR1 wordt vergeleken met een interne referentie VREF). Daarmee voorkomen we ‘chatter’ bij grensgevallen en borgen we voorspelbaar gedrag.

### 7.5 Praktische implementatie (componenten rond de rails)

- Lokale ontkoppeling bij TLV77518PDBVR: input- en outputcondensatoren (en eventueel een extra uitgangs-/bulkcondensator afhankelijk van load steps en de aanbevelingen uit de datasheet).
- Lokale ontkoppeling bij TPS2117: inputcaps op VIN1/VIN2 en een bulkcap op VOUT (3V3_BOARD) voor load-steps en switch-over dip.
- Silkscreen/labels: duidelijke benamingen NUCLEO_3V3, 5V_IN, 3V3_LDO en 3V3_SYS om meetpunten en debug te versnellen om meetpunten en debug te versnellen.

## 8. Connectoraansluitingen

Dit board gebruikt twee ‘klassieke’ connectorstijlen die zich in de praktijk bewezen hebben voor labwerk: één voor RS-232 (DE-9) en één voor RS-485/RS-422 (tool-less klem).

### 8.1 RS232 (SUB-D / DE-9, male)

De DE-9 is voor RS-232 bijna het Zwitserland onder de connectoren: overal aanwezig, voorspelbaar, en je kunt er in een lab heel snel mee schakelen.

Waarom dit prettig werkt op een ontwikkel-/experimenteerboard: - Universele kabels: standaard seriële kabels en verloopjes zijn goedkoop en overal te krijgen. - Robuust en ‘keyed’: mechanisch stevig, niet per ongeluk om te draaien, en prettig bij veel in/uit-pluggen. - Handshaking-ready: voldoende pinnen om het volledige RS-232 handshaking-set (5T3R) te testen zonder kunstgrepen. - Meetvriendelijk: veel meetadapters, breakout-kabels en analyser-tools spreken DE-9 direct.

#### 8.1.1 RS232 DE-9 pinout (male) – industrieel (5T3R)

Onderstaande pinout is de klassieke DE-9 RS-232 mapping. We noteren ook de richting zoals die vaak in industriële apparatuur wordt gebruikt als DCE (5T3R).

DE-9 pin | Signaal | Richting bij DCE (5T3R) | Omschrijving
1 | DCD | OUT | Data Carrier Detect
2 | RXD | IN | Receive Data (naar transceiver)
3 | TXD | OUT | Transmit Data (van transceiver)
4 | DTR | IN | Data Terminal Ready
5 | GND | n.v.t. | Signaal ground
6 | DSR | OUT | Data Set Ready
7 | RTS | IN | Request To Send
8 | CTS | OUT | Clear To Send
9 | RI | OUT | Ring Indicator

Opmerking: - Als we het board als DTE willen laten gedragen (PC-achtig), dan draaien de richtingen om (TXD/RTS/DTR worden OUT vanuit board, RXD/CTS/DSR/DCD/RI worden IN). - We beslissen later of we DCE of DTE als default nemen en of we daar een jumper- of kabelconventie voor willen. - Ontwerpregel: alle configureerbare opties op dit board gebeuren via fysieke 3-pin jumper headers (geen soldeeropties), zodat instellingen snel en herhaalbaar te wisselen zijn.

### 8.2 RS485/RS422 (Phoenix Contact 1190299 – Lever Push-in)

Voor RS-485/RS-422 is een tool-less lever push-in klem ideaal: je wilt snel kunnen wisselen van kabels, twisted-pair proefopstellingen maken, en toch een betrouwbare verbinding houden.

Waarom dit prettig werkt op een ontwikkel-/experimenteerboard: - Snel en foutarm aansluiten: hendel open, draad erin, hendel dicht. Geen schroevendraaier, geen getrek aan slecht geknepen aders. - Betrouwbare verbinding: trilling- en trekbestendiger dan ‘losse dupont’ en stabieler dan tijdelijk gepruts met krokodillen. - Twisted pair friendly: RS-485/422 draait op differentiële paren; een klemverbinding werkt hier in de praktijk erg netjes. - Herhaalbaarheid: ideaal voor testopstellingen waarbij je vaak wisselt tussen 2-wire (half duplex) en 4-wire (full duplex/RS-422).

#### 8.2.1 Aanbevolen signaaltoewijzing (4-polig)

We houden de labeling op de PCB leidend (Y/Z voor TX-paar en A/B voor RX-paar), zodat het ook zonder schema direct logisch blijft.

Full-duplex / RS-422 (4-wire): | Klem | Signaal | Functie | |—:|—|—| | 1 | B (RX−) | Receiver − | | 2 | A (RX+) | Receiver + | | 3 | Y (TX+) | Driver + | | 4 | Z (TX−) | Driver − |

Half-duplex RS-485 (2-wire): - Gebruik primair A/B als buspaar. - Klem 1–2 kunnen dan als A/B gebruikt worden en klem 3–4 als optioneel (bijv. doorlus, shield/REF of ‘NC’), afhankelijk van de definitieve layout-keuze.

Exacte klemvolgorde en silklabels leggen we definitief vast zodra we de mechanische oriëntatie van de connector in het PCB-layout hebben bevroren.

## 9. Open punten en TODO

- Exacte MODE0/MODE1/MODE2/TERM/SLR/DIR waarheidstabellen opnemen en vertalen naar jumper-schema
- Keuze: default rol RS232 (DCE of DTE) en gewenste connector-gender (male is gegeven, maar kabelconventie bepalen)
- Definitieve header-pin mapping naar Arduino-compatible pins (zonder conflict met LCD shield) en expliciete lijst ‘Zio-only’ uitzonderingen
- Definitieve aanpak TX/RX LED activiteit detectie (RS232 én RS485) incl. jumper-keuze HW/SW en RC-dimensionering
- Keuze OE-aanpak voor SN74HCS245 (vast, 3-pin jumper header, of externe logica)
- TPS2117 priority threshold (PR1-divider) dimensioneren voor voorspelbare switchover

Volgende stap (suggestie): pinbudget en signaallijst maken: welke MCU-pinnen reserveren we voor (a) UART data (b) flow control (c) RS485 direction/control (d) mode/term/slr configuratie, rekening houdend met Arduino-compatible pins en jouw LCD-shield constraints.
