stefan-R75/STM32-Nucleo-RS232-RS485-Expansion-Board-ST-Zio-and-Arduino-Compatible/05-Documents/Jumper Configuration.docx

# 1. TCVR PWR

  1.1. Low-Power Shutdown Mode
  1.2. Functie van de jumper
  1.3. Hoe in te stellen
2. SW ENA
  2.1. Naam van de jumper / functie
  2.2. Functie van de jumper
  2.3. Hoe in te stellen

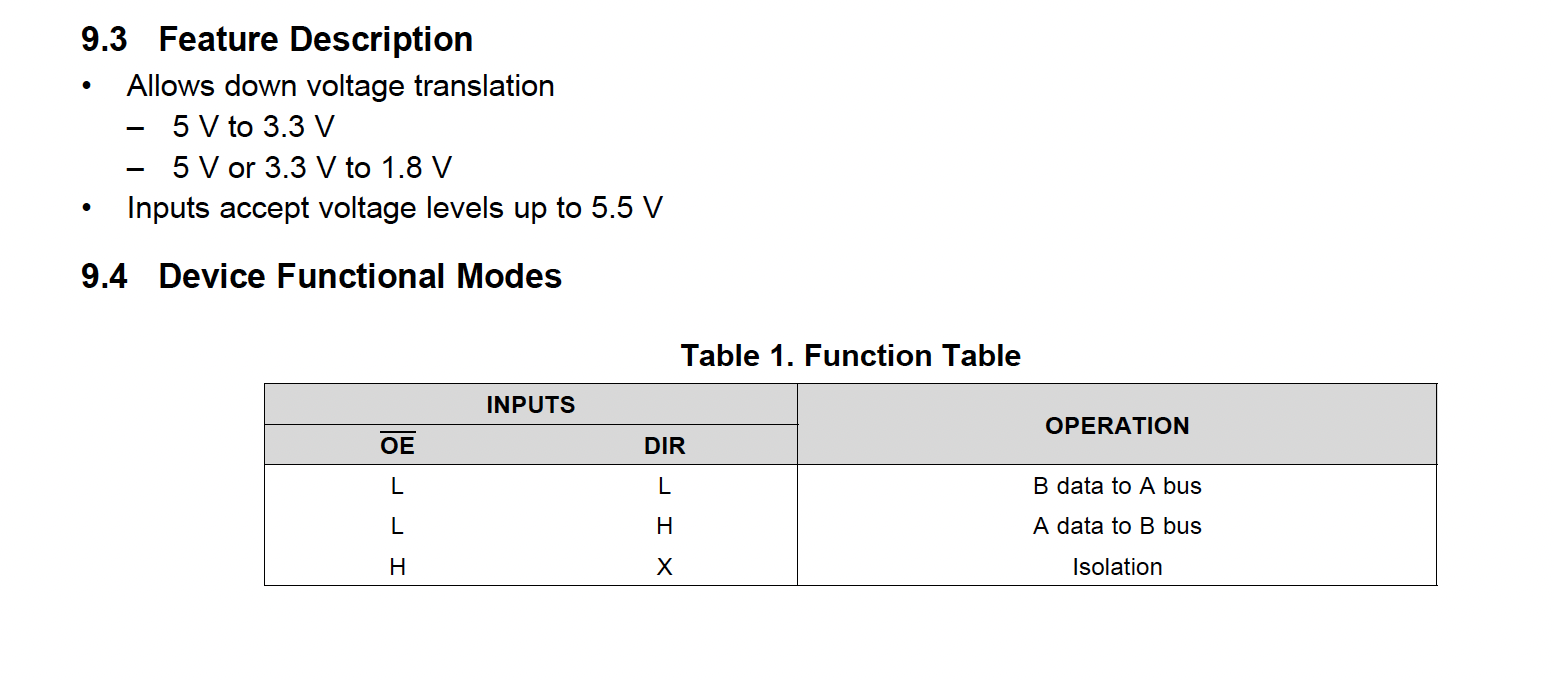
[picture p3: figure]
Afbeelding met tekst, schermopname, Lettertype, lijn Door AI gegenereerde inhoud is mogelijk onjuist.

3. MODE0 t/m MODE2
  3.1. Naam van de jumper / functie
  3.2. Functie van de jumper
  3.3. Hoe in te stellen

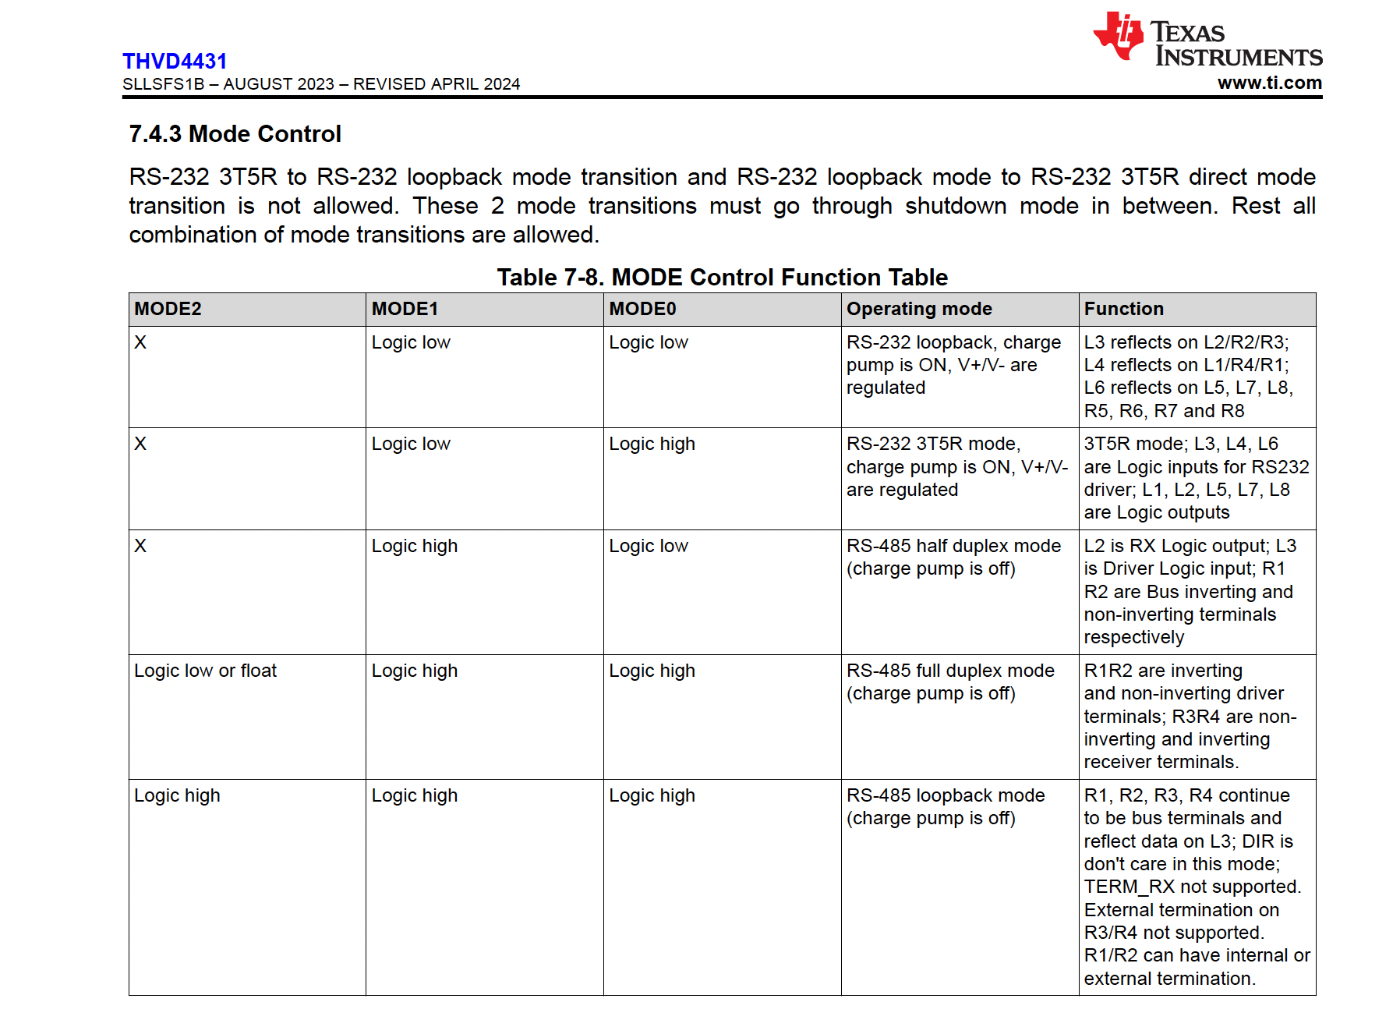
[picture p4: figure]
Afbeelding met tekst, schermopname, nummer, Lettertype Door AI gegenereerde inhoud is mogelijk onjuist.

4. DIR
  4.1. Naam van de jumper / functie
  4.2. Functie van de jumper
  4.3. Hoe in te stellen
5. TERM RX & TERM RX
  5.1. Naam van de jumper / functie
  5.2. Functie van de jumper
  5.3. Hoe in te stellen
6. SLR
  6.1. Naam van de jumper / functie
  6.2. Functie van de jumper
  6.3. Hoe in te stellen
7. TERM (A/B) & TERM (Y/Z)
  7.1. Naam van de jumper / functie
  7.2. Functie van de jumper
  7.3. Hoe in te stellen
8. HD-A(Y) & HD-B(Z)
  8.1. Naam van de jumper / functie
  8.2. Functie van de jumper
  8.3. Hoe in te stellen
9. RX LED & TX LED
  9.1. Naam van de jumper / functie
  9.2. Functie van de jumper
  9.3. Hoe in te stellen
