stefan-R75/STM32-Nucleo-RS232-RS485-Expansion-Board-ST-Zio-and-Arduino-Compatible/01_KiCAD/04_output/Dual Voltage Input.jpg

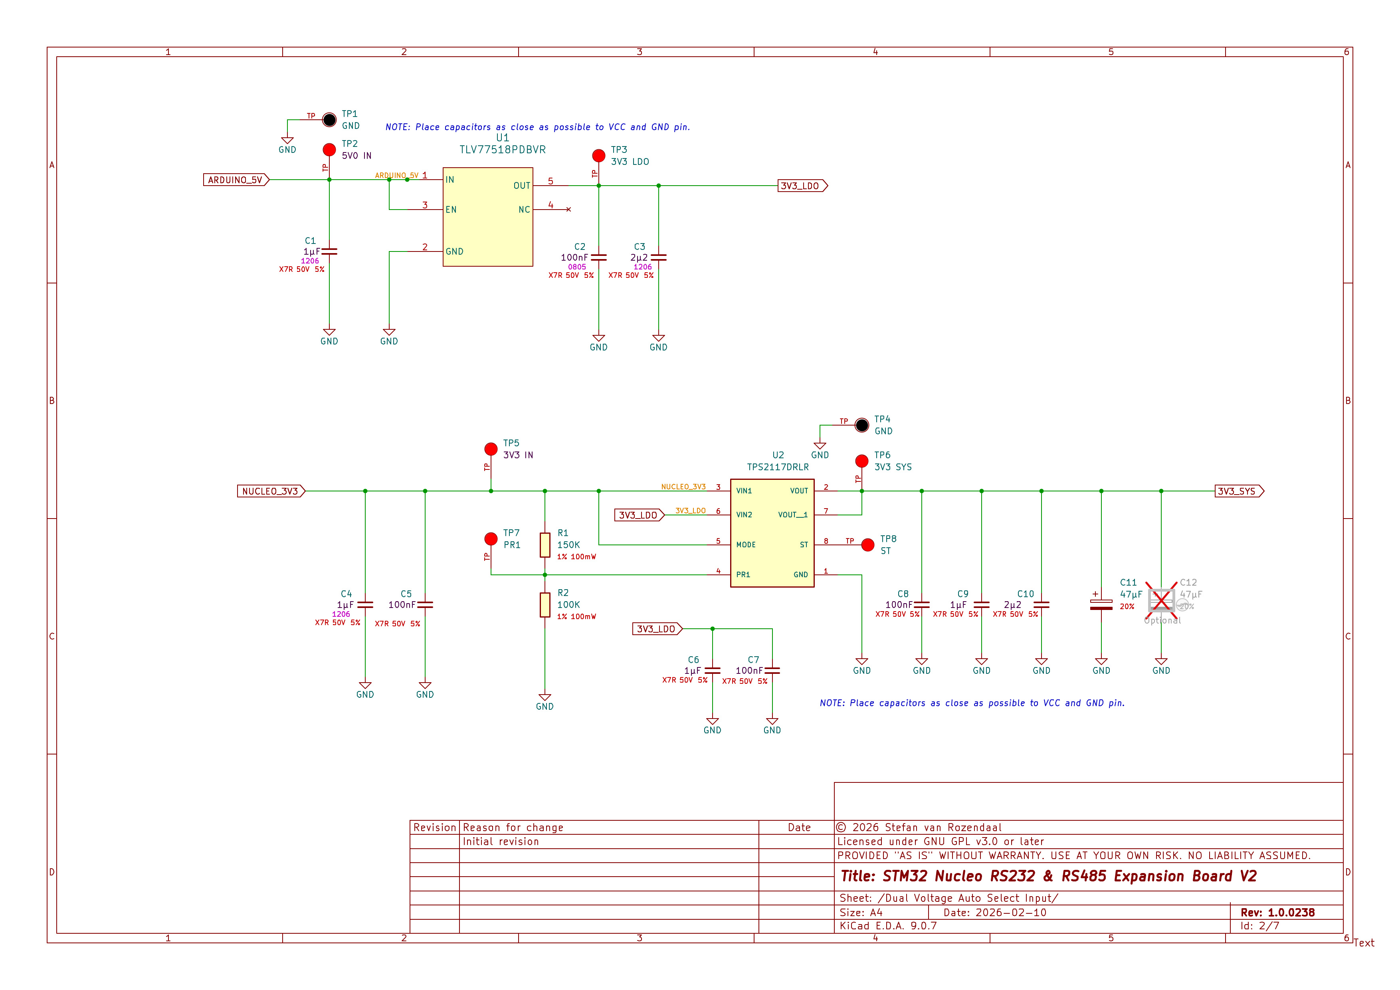
01_KiCAD/04_output/Dual Voltage Input.jpg
