stefan-R75/STM32-Nucleo-RS232-RS485-Expansion-Board-ST-Zio-and-Arduino-Compatible/01_KiCAD/04_output/Jumper Configuration.jpg

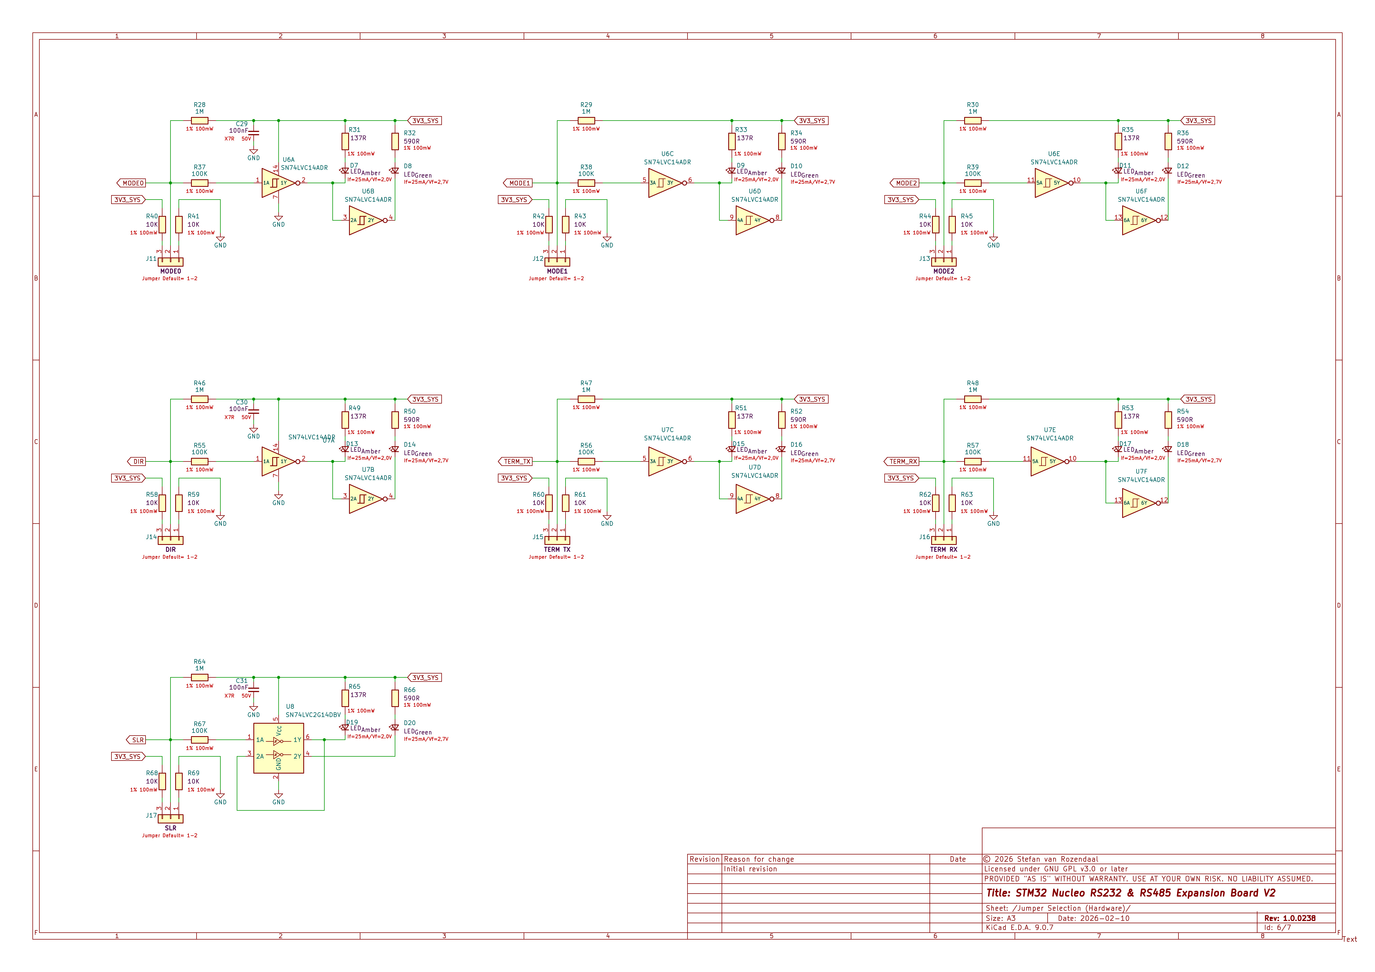
01_KiCAD/04_output/Jumper Configuration.jpg
