stefan-R75/STM32-Nucleo-RS232-RS485-Expansion-Board-ST-Zio-and-Arduino-Compatible/01_KiCAD/04_output/THVD4431 Multi Protocol.jpg

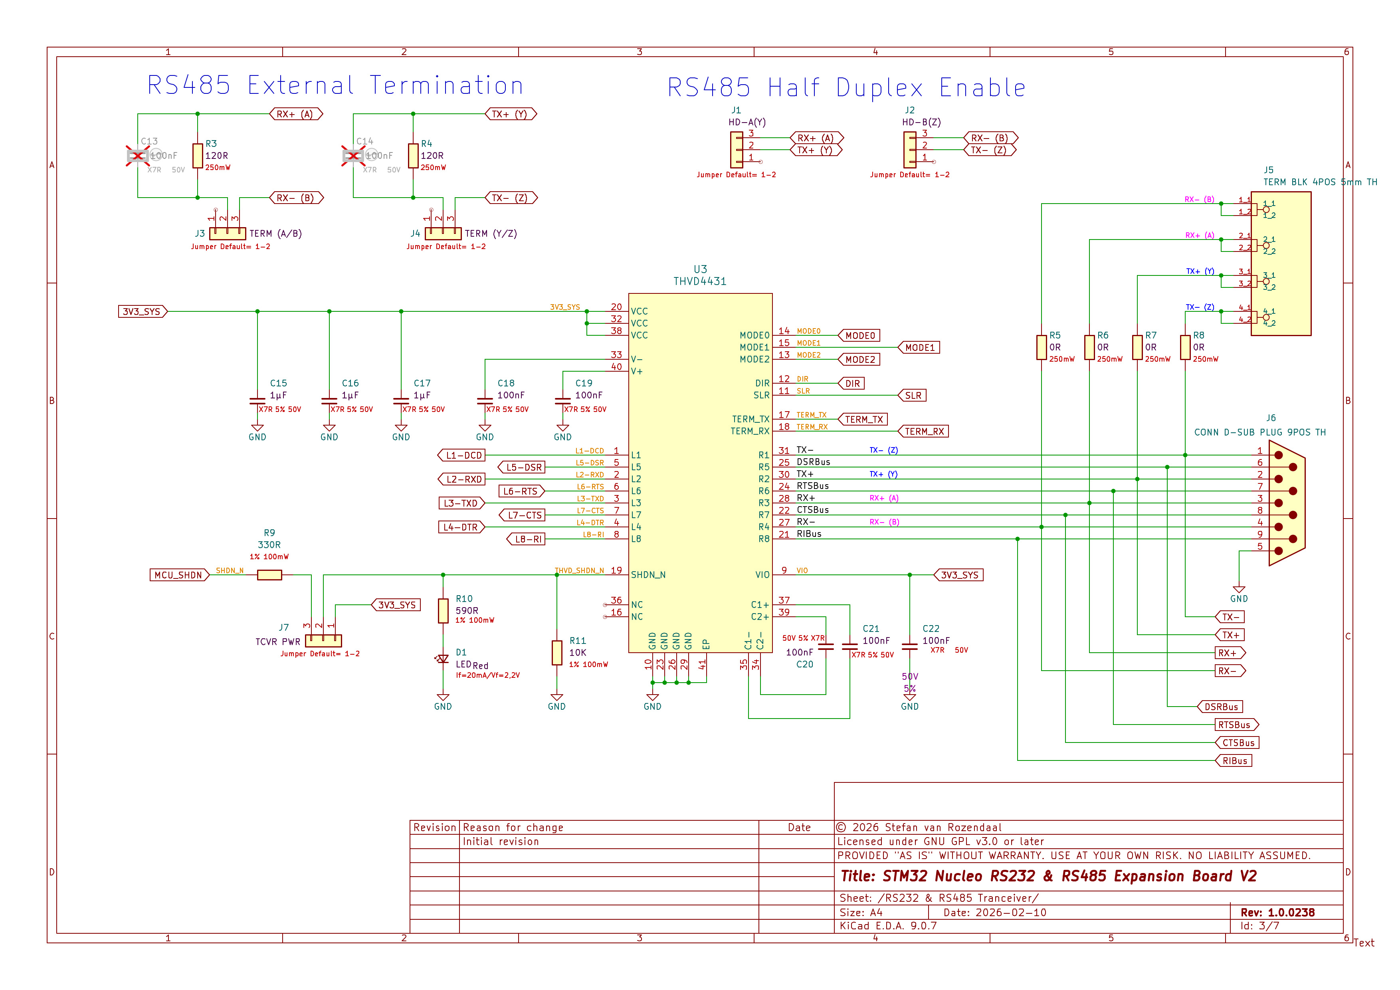
01_KiCAD/04_output/THVD4431 Multi Protocol.jpg
