stefan-R75/STM32-Nucleo-RS232-RS485-Expansion-Board-ST-Zio-and-Arduino-Compatible/04-Pictures/84CB5114-2663-4459-926A-EDC0C91B2D7F.PNG

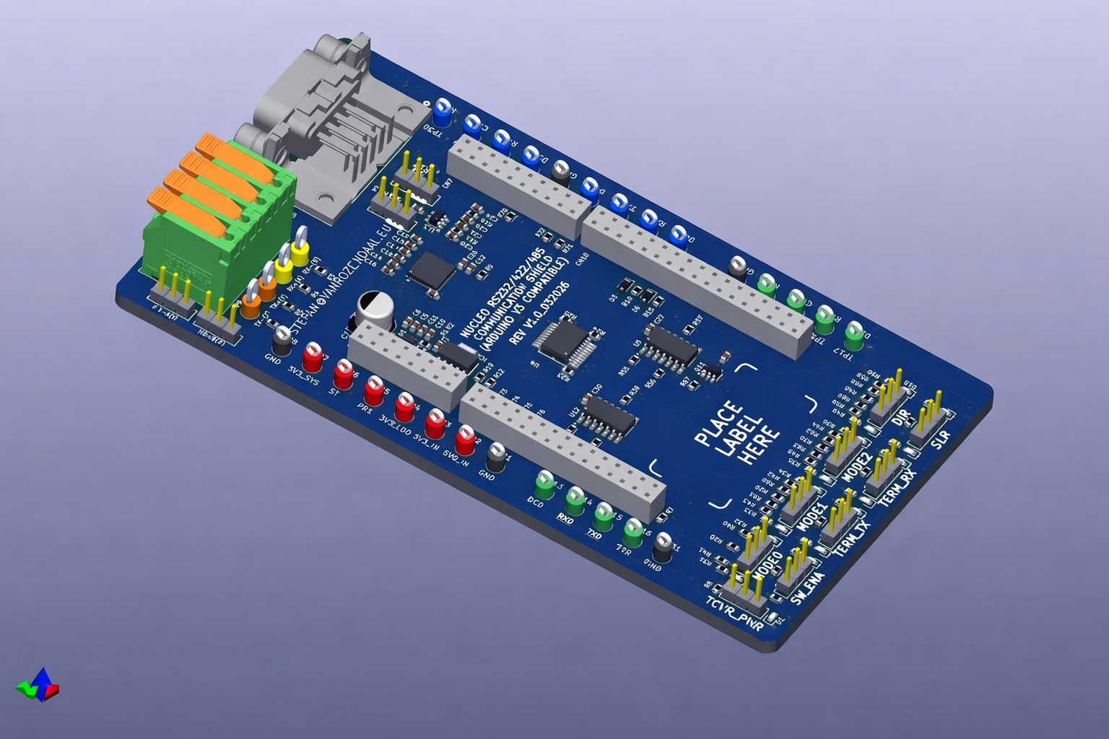
04-Pictures/84CB5114-2663-4459-926A-EDC0C91B2D7F.PNG
