stefan-R75/STM32-Nucleo-RS232-RS485-Expansion-Board-ST-Zio-and-Arduino-Compatible/01_KiCAD/02_custom_libraries/03_3D_models/EEEHD1H101P/EEEHD1H101P.step

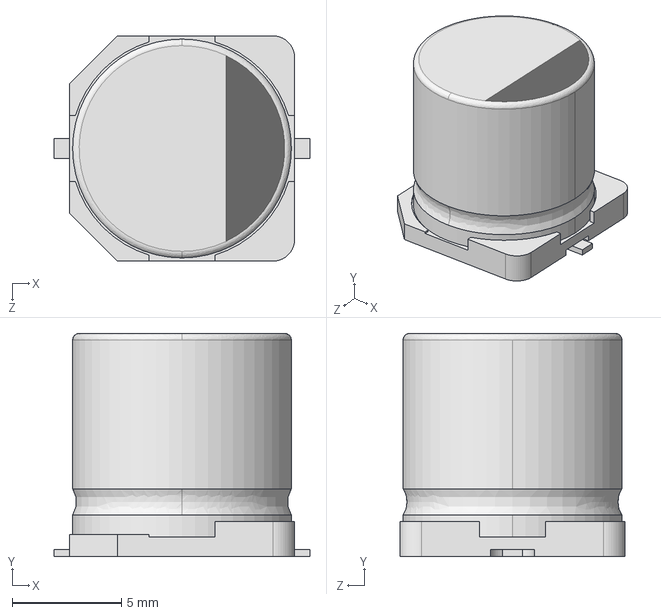
[picture p13: CAD file, 2026-02-08]
01_KiCAD/02_custom_libraries/03_3D_models/EEEHD1H101P/EEEHD1H101P.step
11.7 x 10.2 x 10.3 mm
