stefan-R75/STM32-Nucleo-RS232-RS485-Expansion-Board-ST-Zio-and-Arduino-Compatible/01_KiCAD/02_custom_libraries/03_3D_models/TE_2301843-2/c-2301843-2-b-3d.stp

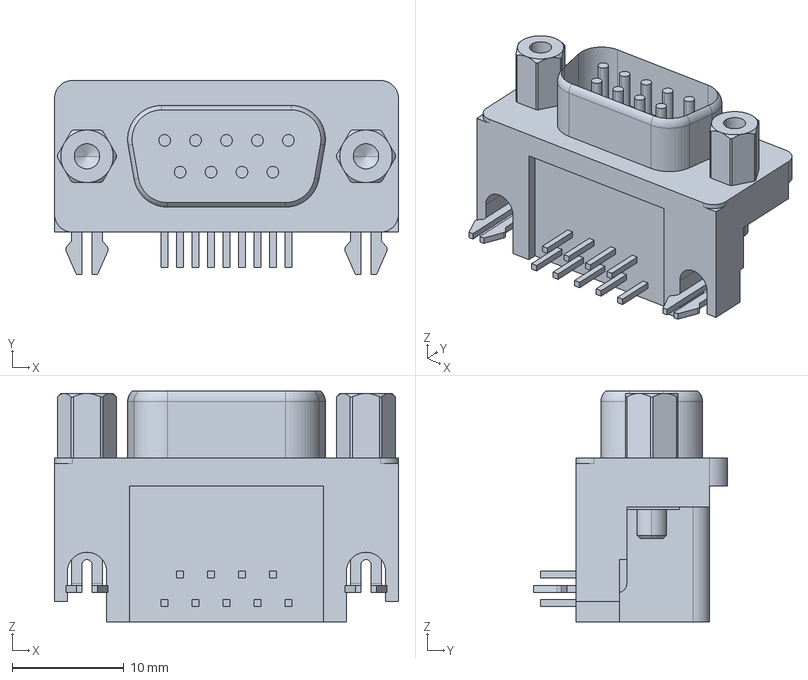
[picture p14: CAD file, 2026-02-04]
01_KiCAD/02_custom_libraries/03_3D_models/TE_2301843-2/c-2301843-2-b-3d.stp
30.8 x 17.4 x 20.6 mm
