stefan-R75/STM32-Nucleo-RS232-RS485-Expansion-Board-ST-Zio-and-Arduino-Compatible/(list of files, cad)

Other CAD files:
01_KiCAD/02_custom_libraries/03_3D_models/TE_2301843-2/c-2301843-2-b-3d.iges
01_KiCAD/02_custom_libraries/03_3D_models/TE_2301843-2/c-2301843-2-b-3d.stl
