stefan-R75/STM32-Nucleo-RS232-RS485-Expansion-Board-ST-Zio-and-Arduino-Compatible/01_KiCAD/00_schematics/STM32 Nucleo RS232 & RS485 Expansion Board (ST Zio Compatible) V2/STM32 Nucleo RS232 & RS485 Expansion Board (ST Zio Compatible) V2.kicad_pcb

## KiCad design 01_KiCAD/00_schematics/STM32 Nucleo RS232 & RS485 Expansion Board (ST Zio Compatible) V2/STM32 Nucleo RS232 & RS485 Expansion Board (ST Zio Compatible) V2.kicad_pcb (2026-02-25)

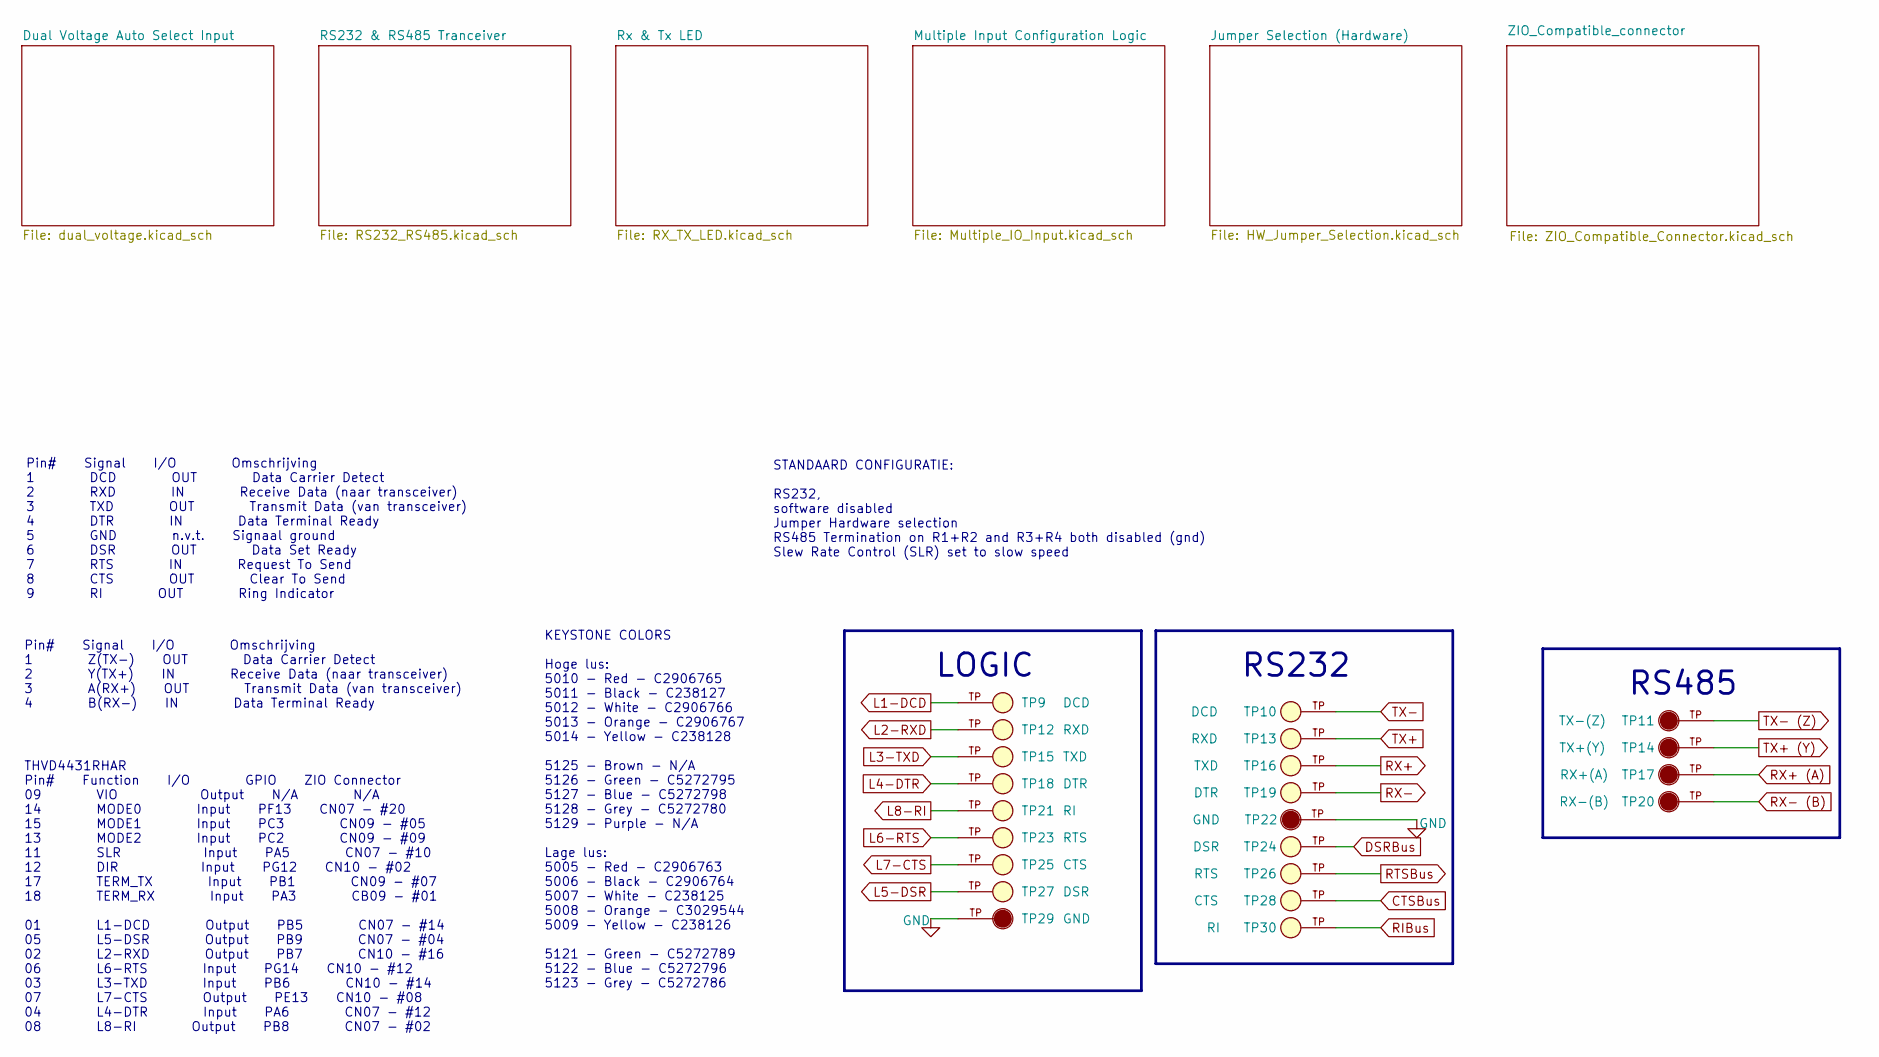
[picture p21: schematic STM32 Nucleo RS232 & RS485 Expansion Board (ST Zio Compatible) V2.kicad_sch, STM32 Nucleo RS232 & RS485 Expansion Board V2]

Parts:
TP9, TP10: DCD; KEYSTONE_5121; PARTREV F; LCSC C5272789
TP11: TX-(Z); KEYSTONE_5009; PARTREV F; LCSC C238128
TP12, TP13: RXD; KEYSTONE_5122; PARTREV F; LCSC C5272796
TP14: TX+(Y); KEYSTONE_5009; PARTREV F; LCSC C238128
TP15, TP16: TXD; KEYSTONE_5122; PARTREV F; LCSC C5272796
TP17: RX+(A); KEYSTONE_5008; PARTREV F; LCSC C2906767
TP18, TP19: DTR; KEYSTONE_5121; PARTREV F; LCSC C5272789
TP20: RX-(B); KEYSTONE_5008; PARTREV F; LCSC C2906767
TP21, TP30: RI; KEYSTONE_5121; PARTREV F; LCSC C5272789
TP22, TP29: GND; KEYSTONE_5006; PARTREV F; LCSC C2906764
TP23, TP26: RTS; KEYSTONE_5122; PARTREV F; LCSC C5272796
TP24, TP27: DSR; KEYSTONE_5122; PARTREV F; LCSC C5272796
TP25, TP28: CTS; KEYSTONE_5122; PARTREV F; LCSC C5272796

Connections:
CTSBus: TP28.TP; also elsewhere on the board
DSRBus: TP24.TP; also elsewhere on the board
GND: TP22.TP, TP29.TP; also elsewhere on the board
L1-DCD: TP9.TP; also elsewhere on the board
L2-RXD: TP12.TP; also elsewhere on the board
L3-TXD: TP15.TP; also elsewhere on the board
L4-DTR: TP18.TP; also elsewhere on the board
L5-DSR: TP27.TP; also elsewhere on the board
L6-RTS: TP23.TP; also elsewhere on the board
L7-CTS: TP25.TP; also elsewhere on the board
L8-RI: TP21.TP; also elsewhere on the board
RIBus: TP30.TP; also elsewhere on the board
RTSBus: TP26.TP; also elsewhere on the board
RX+: TP16.TP; also elsewhere on the board
RX+ (A): TP17.TP; also elsewhere on the board
RX-: TP19.TP; also elsewhere on the board
RX- (B): TP20.TP; also elsewhere on the board
TX+: TP13.TP; also elsewhere on the board
TX+ (Y): TP14.TP; also elsewhere on the board
TX-: TP10.TP; also elsewhere on the board
TX- (Z): TP11.TP; also elsewhere on the board

Notes on the sheet:
LOGIC
Pin# Signal I/O Omschrijving 1 DCD OUT Data Carrier Detect 2 RXD IN Receive Data (naar transceiver) 3 TXD OUT Transmit Data (van transceiver) 4 DTR IN Data Terminal Ready 5 GND n.v.t. Signaal ground 6 DSR OUT Data Set Ready 7 RTS IN Request To Send 8 CTS OUT Clear To Send 9 RI OUT Ring Indicator
KEYSTONE COLORS Hoge lus: 5010 - Red - C2906765 5011 - Black - C238127 5012 - White - C2906766 5013 - Orange - C2906767 5014 - Yellow - C238128 5125 - Brown - N/A 5126 - Green - C5272795 5127 - Blue - C5272798 5128 - Grey - C5272780 5129 - Purple - N/A Lage lus: 5005 - Red - C2906763 5006 - Black -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
Pin# Signal I/O Omschrijving 1 Z(TX-) OUT Data Carrier Detect 2 Y(TX+) IN Receive Data (naar transceiver) 3 A(RX+) OUT Transmit Data (van transceiver) 4 B(RX-) IN Data Terminal Ready
THVD4431RHAR Pin# Function I/O GPIO ZIO Connector 09 VIO Output N/A N/A 14 MODE0 Input PF13 CN07 - #20 15 MODE1 Input PC3 CN09 - #05 13 MODE2 Input PC2 CN09 - #09 11 SLR Input PA5 CN07 - #10 12 DIR Input PG12 CN10 - #02 17 TERM_TX Input PB1 CN09 - #07 18 TERM_RX Input PA3 CB09 - #01 01 L1-DCD Outpu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
STANDAARD CONFIGURATIE: RS232, software disabled Jumper Hardware selection RS485 Termination on R1+R2 and R3+R4 both disabled (gnd) Slew Rate Control (SLR) set to slow speed
RS232
RS485

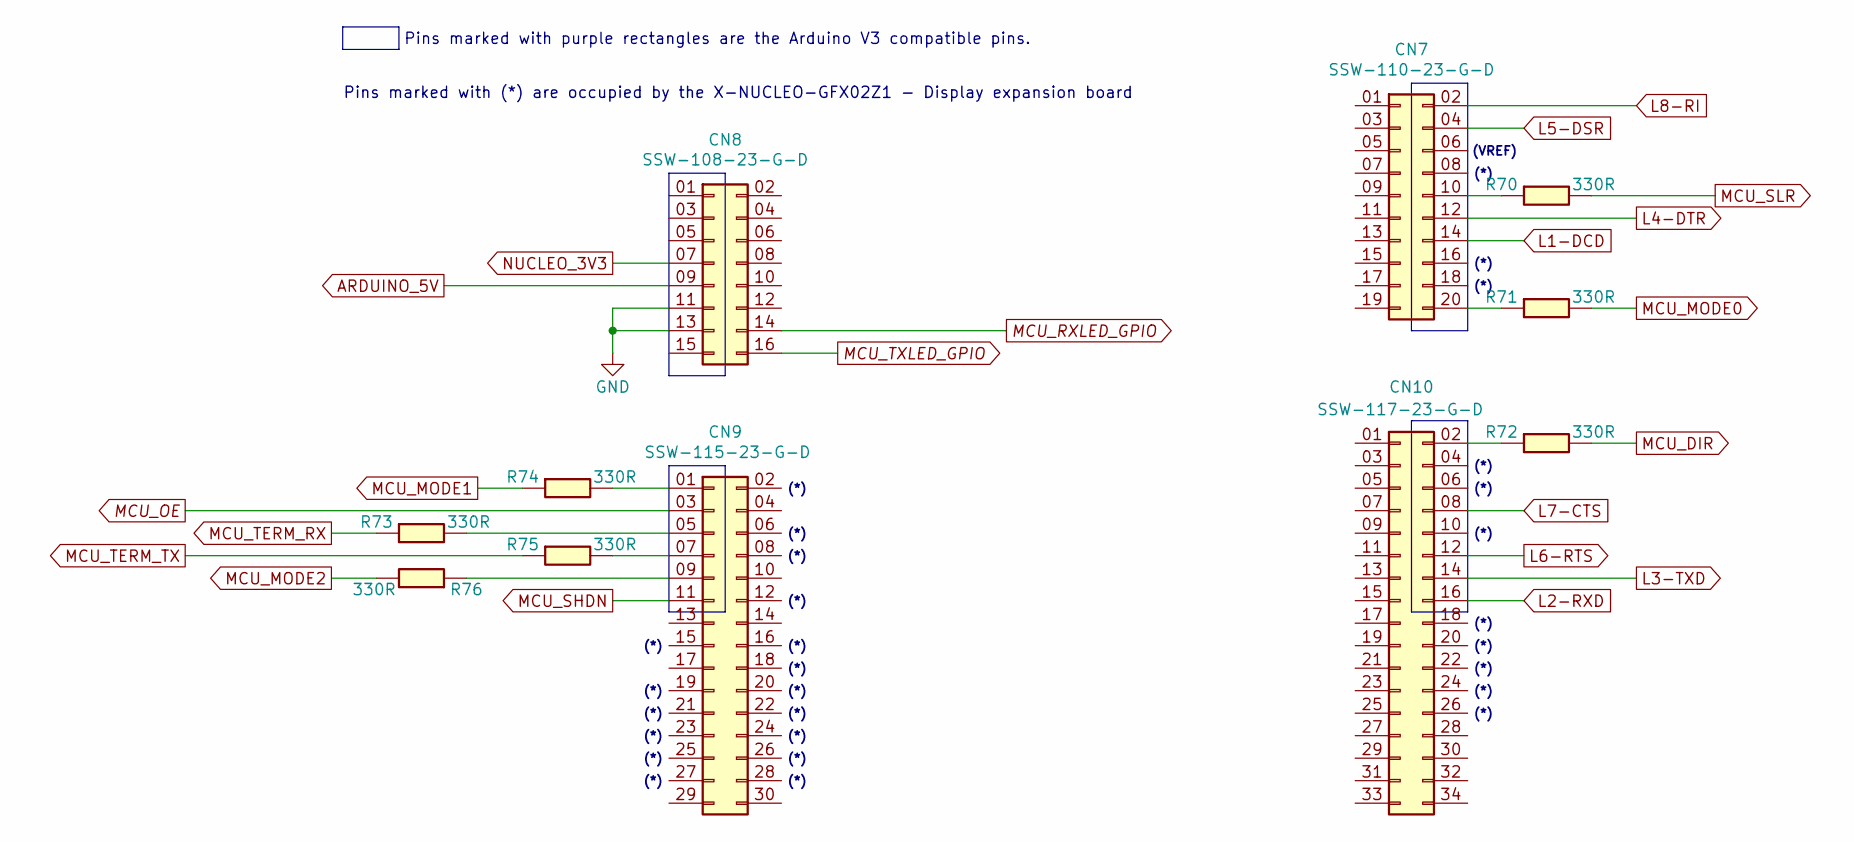
[picture p22: schematic ZIO_Compatible_Connector.kicad_sch, STM32 Nucleo RS232 & RS485 Expansion Board V2]

Parts:
CN7: SSW-110-23-G-D; SAMTEC_SSW-110-23-X-D; MPN SSW-110-23-G-D; LCSC C6236460
CN8: SSW-108-23-G-D; SAMTEC_SSW-108-23-F-D; MPN SSW-108-23-G-D; LCSC C7019040
CN9: SSW-115-23-G-D; SAMTEC_SSW-115-23-F-D; MPN SSW-115-23-G-D; LCSC C7089189
CN10: SSW-117-23-G-D; SAMTEC_SSW-117-23-F-D; MPN SSW-117-23-G-D; LCSC C6501751
R70, R71, R72, R73, R74, R75, R76: 330R; R_0603; Voltage Rating 1% 100mW; MPN AC0603FR-7W330RL; LCSC C513549

Connections:
ARDUINO_5V: CN8.09 (Pin_9); also elsewhere on the board
GND: CN8.11, CN8.13; also elsewhere on the board
L1-DCD: CN7.14; also elsewhere on the board
L2-RXD: CN10.16; also elsewhere on the board
L3-TXD: CN10.14; also elsewhere on the board
L4-DTR: CN7.12; also elsewhere on the board
L5-DSR: CN7.04 (Pin_4); also elsewhere on the board
L6-RTS: CN10.12; also elsewhere on the board
L7-CTS: CN10.08 (Pin_8); also elsewhere on the board
L8-RI: CN7.02 (Pin_2); also elsewhere on the board
MCU_DIR: R72.1; also elsewhere on the board
MCU_MODE0: R71.1; also elsewhere on the board
MCU_MODE1: R74.2; also elsewhere on the board
MCU_MODE2: R76.1; also elsewhere on the board
MCU_OE: CN9.03 (Pin_3); also elsewhere on the board
MCU_RXLED_GPIO: CN8.14; also elsewhere on the board
MCU_SHDN: CN9.11; also elsewhere on the board
MCU_SLR: R70.1; also elsewhere on the board
MCU_TERM_RX: R73.2; also elsewhere on the board
MCU_TERM_TX: R75.2; also elsewhere on the board
MCU_TXLED_GPIO: CN8.16; also elsewhere on the board
NUCLEO_3V3: CN8.07 (Pin_7); also elsewhere on the board
unnamed: CN7.10, R70.2
unnamed: CN7.20, R71.2
unnamed: CN9.01 (Pin_1), R74.1
unnamed: CN9.05 (Pin_5), R73.1
unnamed: CN9.07 (Pin_7), R75.1
unnamed: CN9.09 (Pin_9), R76.2
unnamed: CN10.02 (Pin_2), R72.2

Notes on the sheet:
(*)
(VREF)
Pins marked with purple rectangles are the Arduino V3 compatible pins.
Pins marked with (*) are occupied by the X-NUCLEO-GFX02Z1 - Display expansion board

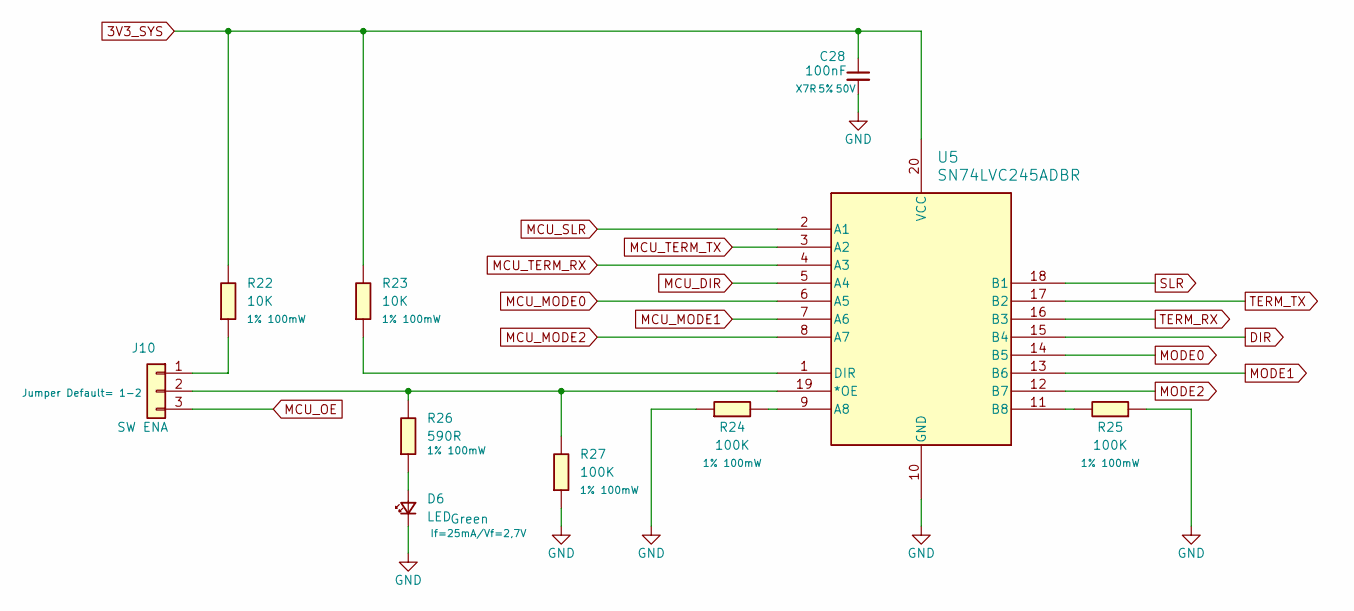
[picture p23: schematic Multiple_IO_Input.kicad_sch, STM32 Nucleo RS232 & RS485 Expansion Board V2]

Parts:
C28: 100nF; C_0805_2012Metric; Voltage Rating 50V; Voltage 50V; MPN C0805C104J5RACTU; LCSC C2167095
D6: LED; LED_0603_WRE; Voltage Rating If=25mA/Vf=2,7V; Voltage 2,7V; MPN IN-S63AT5G; LCSC C5656662
J10: SW ENA; Samtec HTSW-103-07-F-S; Voltage Rating Jumper Default= 1-2; MPN HTSW-103-07-F-S; LCSC C5714562
R22, R23: 10K; R_0603; Voltage Rating 1% 100mW; MPN AC0603FR-7W10KL; LCSC C20142011
R24, R25, R27: 100K; R_0603; Voltage Rating 1% 100mW; MPN AC0603FR-7W100KL; LCSC C5552302
R26: 590R; R_0603; Voltage Rating 1% 100mW; MPN AC0603FR-07590RL; LCSC C227973
U5: SN74LVC245ADBR; SOP65P780X200-20N; MPN SN74LVC245ADBR; LCSC C393617

Connections:
3V3_SYS: C28.1, R22.1, R23.1, U5.20 (VCC); also elsewhere on the board
DIR: U5.15 (B4); also elsewhere on the board
GND: C28.2, D6.1 (K), R24.2, R25.2, R27.2, U5.10 (GND); also elsewhere on the board
MCU_DIR: U5.5 (A4); also elsewhere on the board
MCU_MODE0: U5.6 (A5); also elsewhere on the board
MCU_MODE1: U5.7 (A6); also elsewhere on the board
MCU_MODE2: U5.8 (A7); also elsewhere on the board
MCU_OE: J10.3; also elsewhere on the board
MCU_SLR: U5.2 (A1); also elsewhere on the board
MCU_TERM_RX: U5.4 (A3); also elsewhere on the board
MCU_TERM_TX: U5.3 (A2); also elsewhere on the board
MODE0: U5.14 (B5); also elsewhere on the board
MODE1: U5.13 (B6); also elsewhere on the board
MODE2: U5.12 (B7); also elsewhere on the board
unnamed: D6.2 (A), R26.2
unnamed: J10.1, R22.2
unnamed: J10.2, R26.1, R27.1, U5.19 (*OE)
unnamed: R24.1, U5.9 (A8)
unnamed: R25.1, U5.11 (B8)
unnamed: R23.2, U5.1 (DIR)
SLR: U5.18 (B1); also elsewhere on the board
TERM_RX: U5.16 (B3); also elsewhere on the board
TERM_TX: U5.17 (B2); also elsewhere on the board

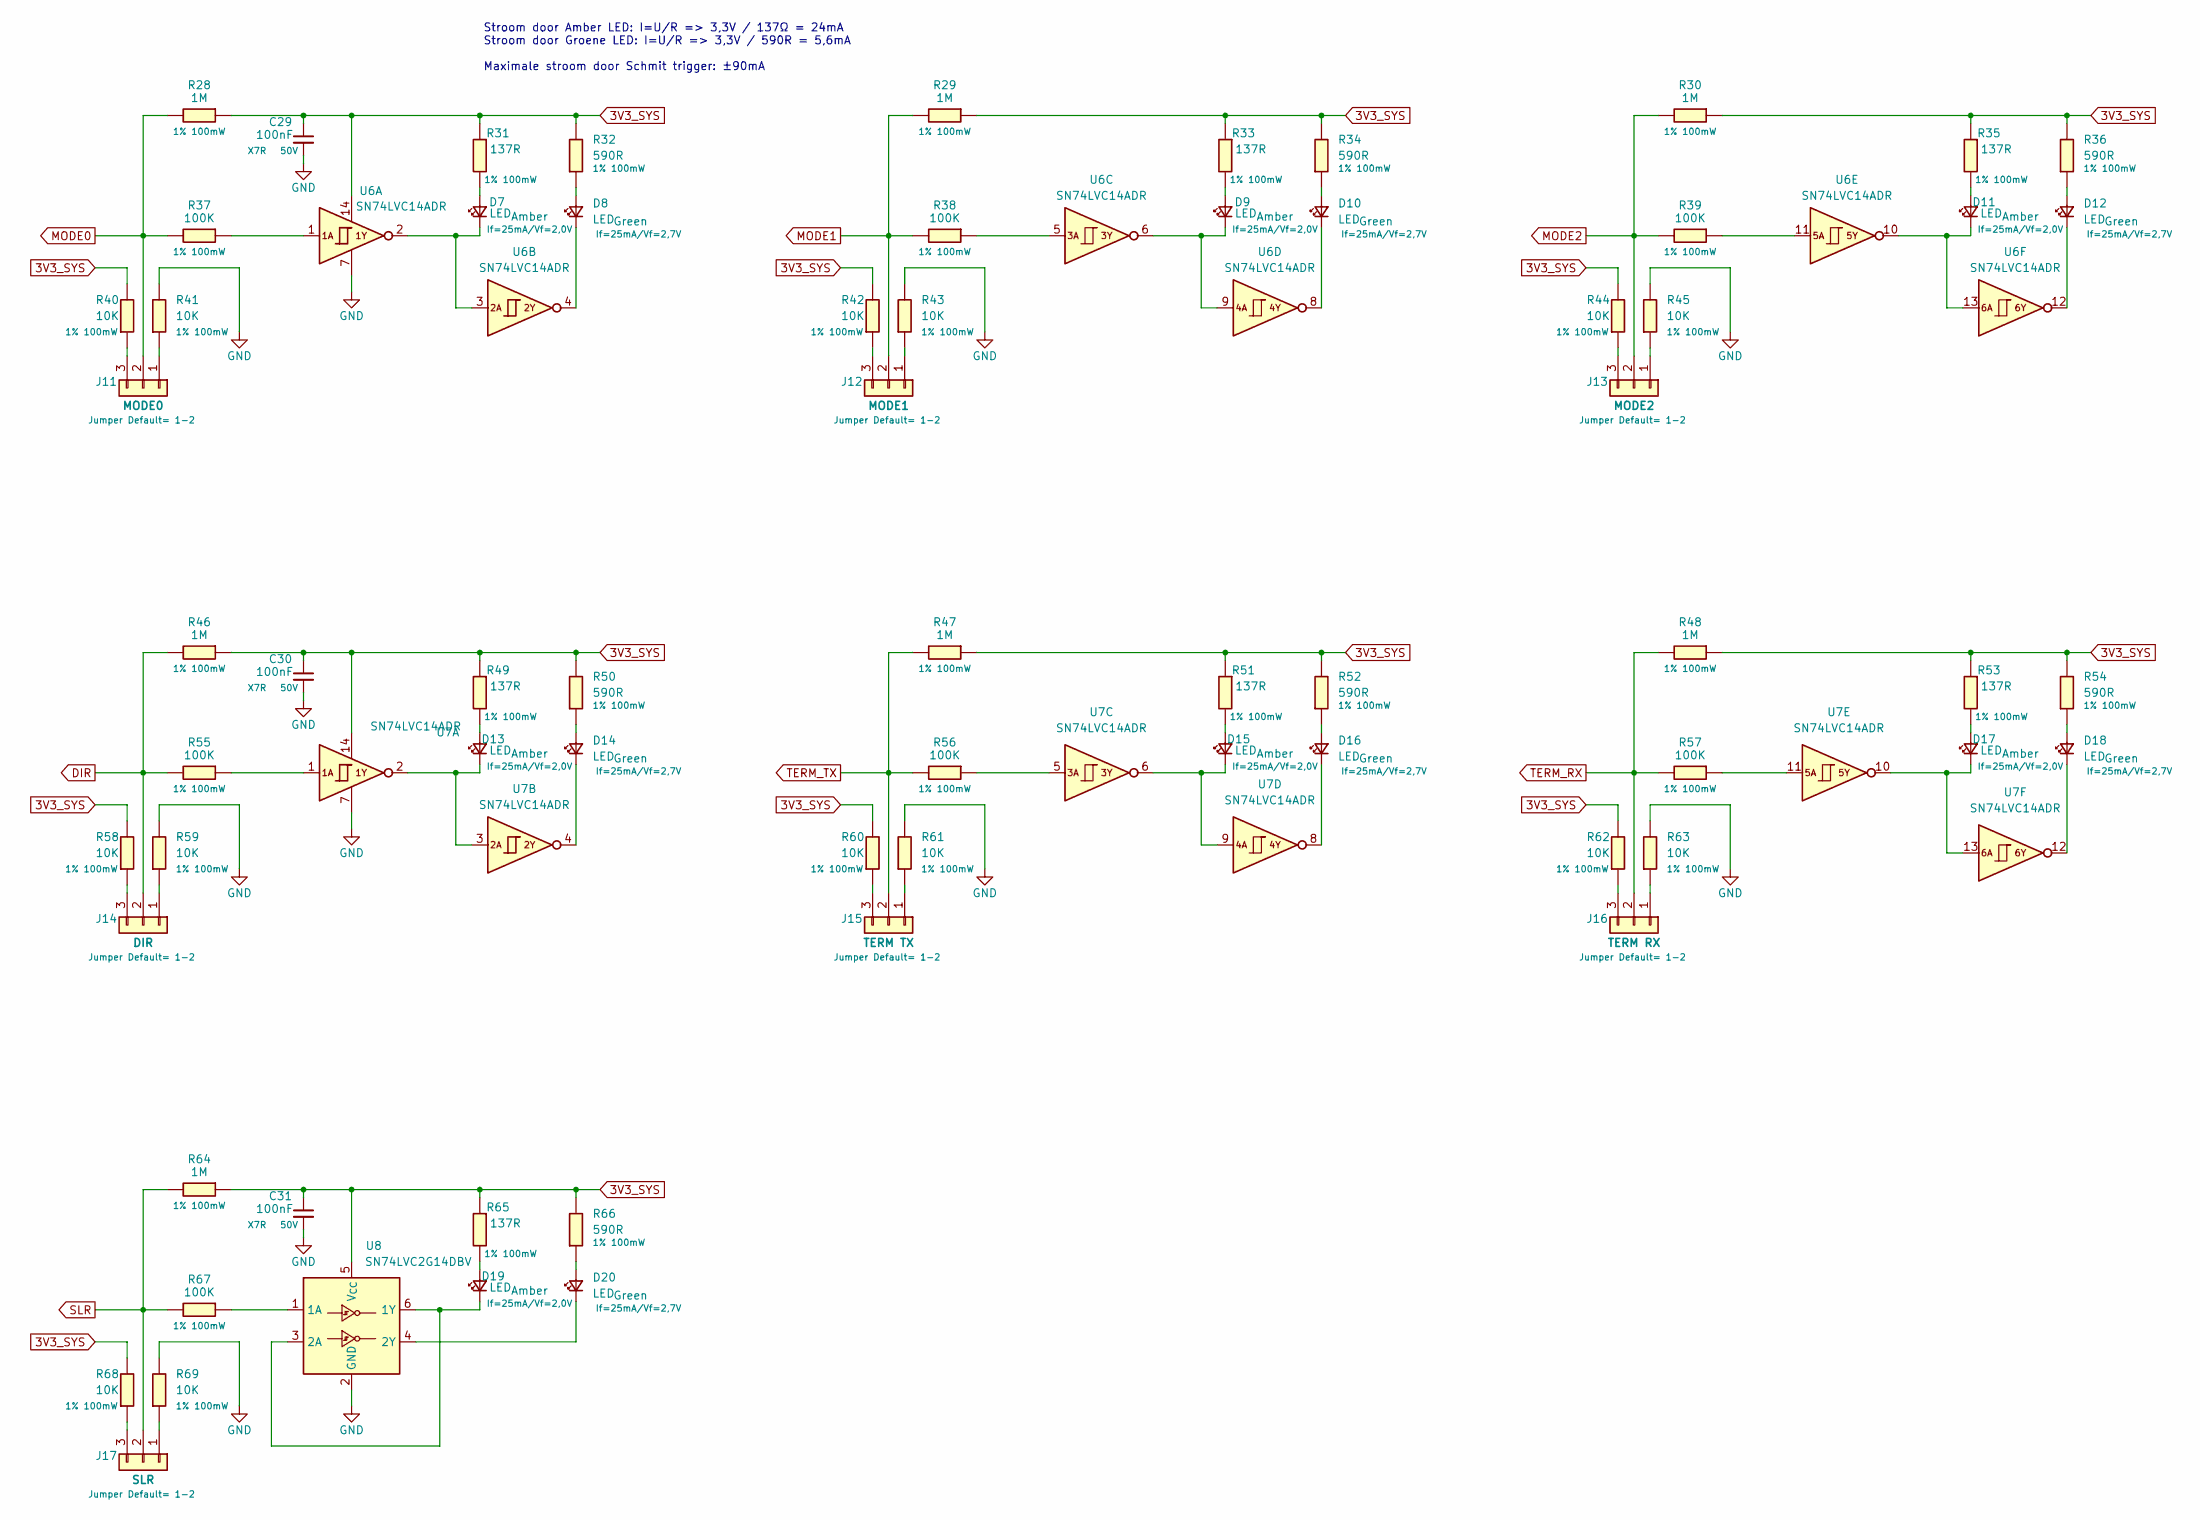
[picture p24: schematic HW_Jumper_Selection.kicad_sch, STM32 Nucleo RS232 & RS485 Expansion Board V2]

Parts:
C29, C30, C31: 100nF; C_0805_2012Metric; Voltage Rating 50V; Voltage 50V; MPN C0805C104J5RACTU; LCSC C2167095
D7, D9, D11, D13, D15, D17, D19: LED; LED_0603_WRE; Voltage Rating If=25mA/Vf=2,0V; Voltage 2,0V; MPN IN-S63AT5A; LCSC C5656657
D8, D10, D12, D14, D16, D18, D20: LED; LED_0603_WRE; Voltage Rating If=25mA/Vf=2,7V; Voltage 2,7V; MPN IN-S63AT5G; LCSC C5656662
J11: MODE0; Samtec HTSW-103-07-F-S; Voltage Rating Jumper Default= 1-2; MPN HTSW-103-07-F-S; LCSC C5714562
J12: MODE1; Samtec HTSW-103-07-F-S; Voltage Rating Jumper Default= 1-2; MPN HTSW-103-07-F-S; LCSC C5714562
J13: MODE2; Samtec HTSW-103-07-F-S; Voltage Rating Jumper Default= 1-2; MPN HTSW-103-07-F-S; LCSC C5714562
J14: DIR; Samtec HTSW-103-07-F-S; Voltage Rating Jumper Default= 1-2; MPN HTSW-103-07-F-S; LCSC C5714562
J15: TERM TX; Samtec HTSW-103-07-F-S; Voltage Rating Jumper Default= 1-2; MPN HTSW-103-07-F-S; LCSC C5714562
J16: TERM RX; Samtec HTSW-103-07-F-S; Voltage Rating Jumper Default= 1-2; MPN HTSW-103-07-F-S; LCSC C5714562
J17: SLR; Samtec HTSW-103-07-F-S; Voltage Rating Jumper Default= 1-2; MPN HTSW-103-07-F-S; LCSC C5714562
R28, R29, R30, R46, R47, R48, R64: 1M; R_0603; Voltage Rating 1% 100mW; MPN AC0603FR-7W1ML; LCSC C20142017
R31, R33, R35, R49, R51, R53, R65: 137R; R_0603; Voltage Rating 1% 100mW; MPN AC0603FR-07137KL; LCSC C227579
R32, R34, R36, R50, R52, R54, R66: 590R; R_0603; Voltage Rating 1% 100mW; MPN AC0603FR-07590RL; LCSC C227973
R37, R38, R39, R55, R56, R57, R67: 100K; R_0603; Voltage Rating 1% 100mW; MPN AC0603FR-7W100KL; LCSC C5552302
R40, R41, R42, R43, R44, R45, R58, R59, R60, R61, R62, R63, R68, R69: 10K; R_0603; Voltage Rating 1% 100mW; MPN AC0603FR-7W10KL; LCSC C20142011
U6, U7: SN74LVC14ADR; SOIC127P600X175-14N; MPN SN74LVC14ADR; LCSC C133541
U8: SN74LVC2G14DBV; SOT-23-6; MPN SN74LVC2G14DBVR; LCSC C12401

Connections:
3V3_SYS: C29.1, C30.1, C31.1, R28.2, R29.2, R30.2, R31.2, R32.1, R33.2, R34.1, R35.2, R36.1, R40.1, R42.1, R44.1, R46.2, R47.2, R48.2, R49.2, R50.1, R51.2, R52.1, R53.2, R54.1, R58.1, R60.1, R62.1, R64.2, R65.2, R66.1, R68.1, U6.14 (VCC), U7.14 (VCC), U8.5 (V_{CC}); also elsewhere on the board
DIR: J14.2, R46.1, R55.1; also elsewhere on the board
GND: C29.2, C30.2, C31.2, R41.1, R43.1, R45.1, R59.1, R61.1, R63.1, R69.1, U6.7 (GND), U7.7 (GND), U8.2 (GND); also elsewhere on the board
MODE0: J11.2, R28.1, R37.1; also elsewhere on the board
MODE1: J12.2, R29.1, R38.1; also elsewhere on the board
MODE2: J13.2, R30.1, R39.1; also elsewhere on the board
unnamed: D7.2 (A), R31.1
unnamed: D7.1 (K), U6.2 (1Y), U6.3 (2A)
unnamed: D8.2 (A), R32.2
unnamed: D8.1 (K), U6.4 (2Y)
unnamed: D9.2 (A), R33.1
unnamed: D9.1 (K), U6.6 (3Y), U6.9 (4A)
unnamed: D10.2 (A), R34.2
unnamed: D10.1 (K), U6.8 (4Y)
unnamed: D11.2 (A), R35.1
unnamed: D11.1 (K), U6.10 (5Y), U6.13 (6A)
unnamed: D12.2 (A), R36.2
unnamed: D12.1 (K), U6.12 (6Y)
unnamed: D13.2 (A), R49.1
unnamed: D13.1 (K), U7.2 (1Y), U7.3 (2A)
unnamed: D14.2 (A), R50.2
unnamed: D14.1 (K), U7.4 (2Y)
unnamed: D15.2 (A), R51.1
unnamed: D15.1 (K), U7.6 (3Y), U7.9 (4A)
unnamed: D16.2 (A), R52.2
unnamed: D16.1 (K), U7.8 (4Y)
unnamed: D17.2 (A), R53.1
unnamed: D17.1 (K), U7.10 (5Y), U7.13 (6A)
unnamed: D18.2 (A), R54.2
unnamed: D18.1 (K), U7.12 (6Y)
unnamed: D19.2 (A), R65.1
unnamed: D19.1 (K), U8.3 (2A), U8.6 (1Y)
unnamed: D20.2 (A), R66.2
unnamed: D20.1 (K), U8.4 (2Y)
unnamed: J11.1, R41.2
unnamed: J11.3, R40.2
unnamed: J12.1, R43.2
unnamed: J12.3, R42.2
unnamed: J13.1, R45.2
unnamed: J13.3, R44.2
unnamed: J14.1, R59.2
unnamed: J14.3, R58.2
unnamed: J15.1, R61.2
unnamed: J15.3, R60.2
unnamed: J16.1, R63.2
unnamed: J16.3, R62.2
unnamed: J17.1, R69.2
unnamed: J17.3, R68.2
unnamed: R37.2, U6.1 (1A)
unnamed: R38.2, U6.5 (3A)
unnamed: R39.2, U6.11 (5A)
unnamed: R55.2, U7.1 (1A)
unnamed: R56.2, U7.5 (3A)
unnamed: R57.2, U7.11 (5A)
unnamed: R67.2, U8.1 (1A)
SLR: J17.2, R64.1, R67.1; also elsewhere on the board
TERM_RX: J16.2, R48.1, R57.1; also elsewhere on the board
TERM_TX: J15.2, R47.1, R56.1; also elsewhere on the board

Notes on the sheet:
Stroom door Amber LED: I=U/R => 3,3V / 137Ω = 24mA Stroom door Groene LED: I=U/R => 3,3V / 590R = 5,6mA Maximale stroom door Schmit trigger: ±90mA

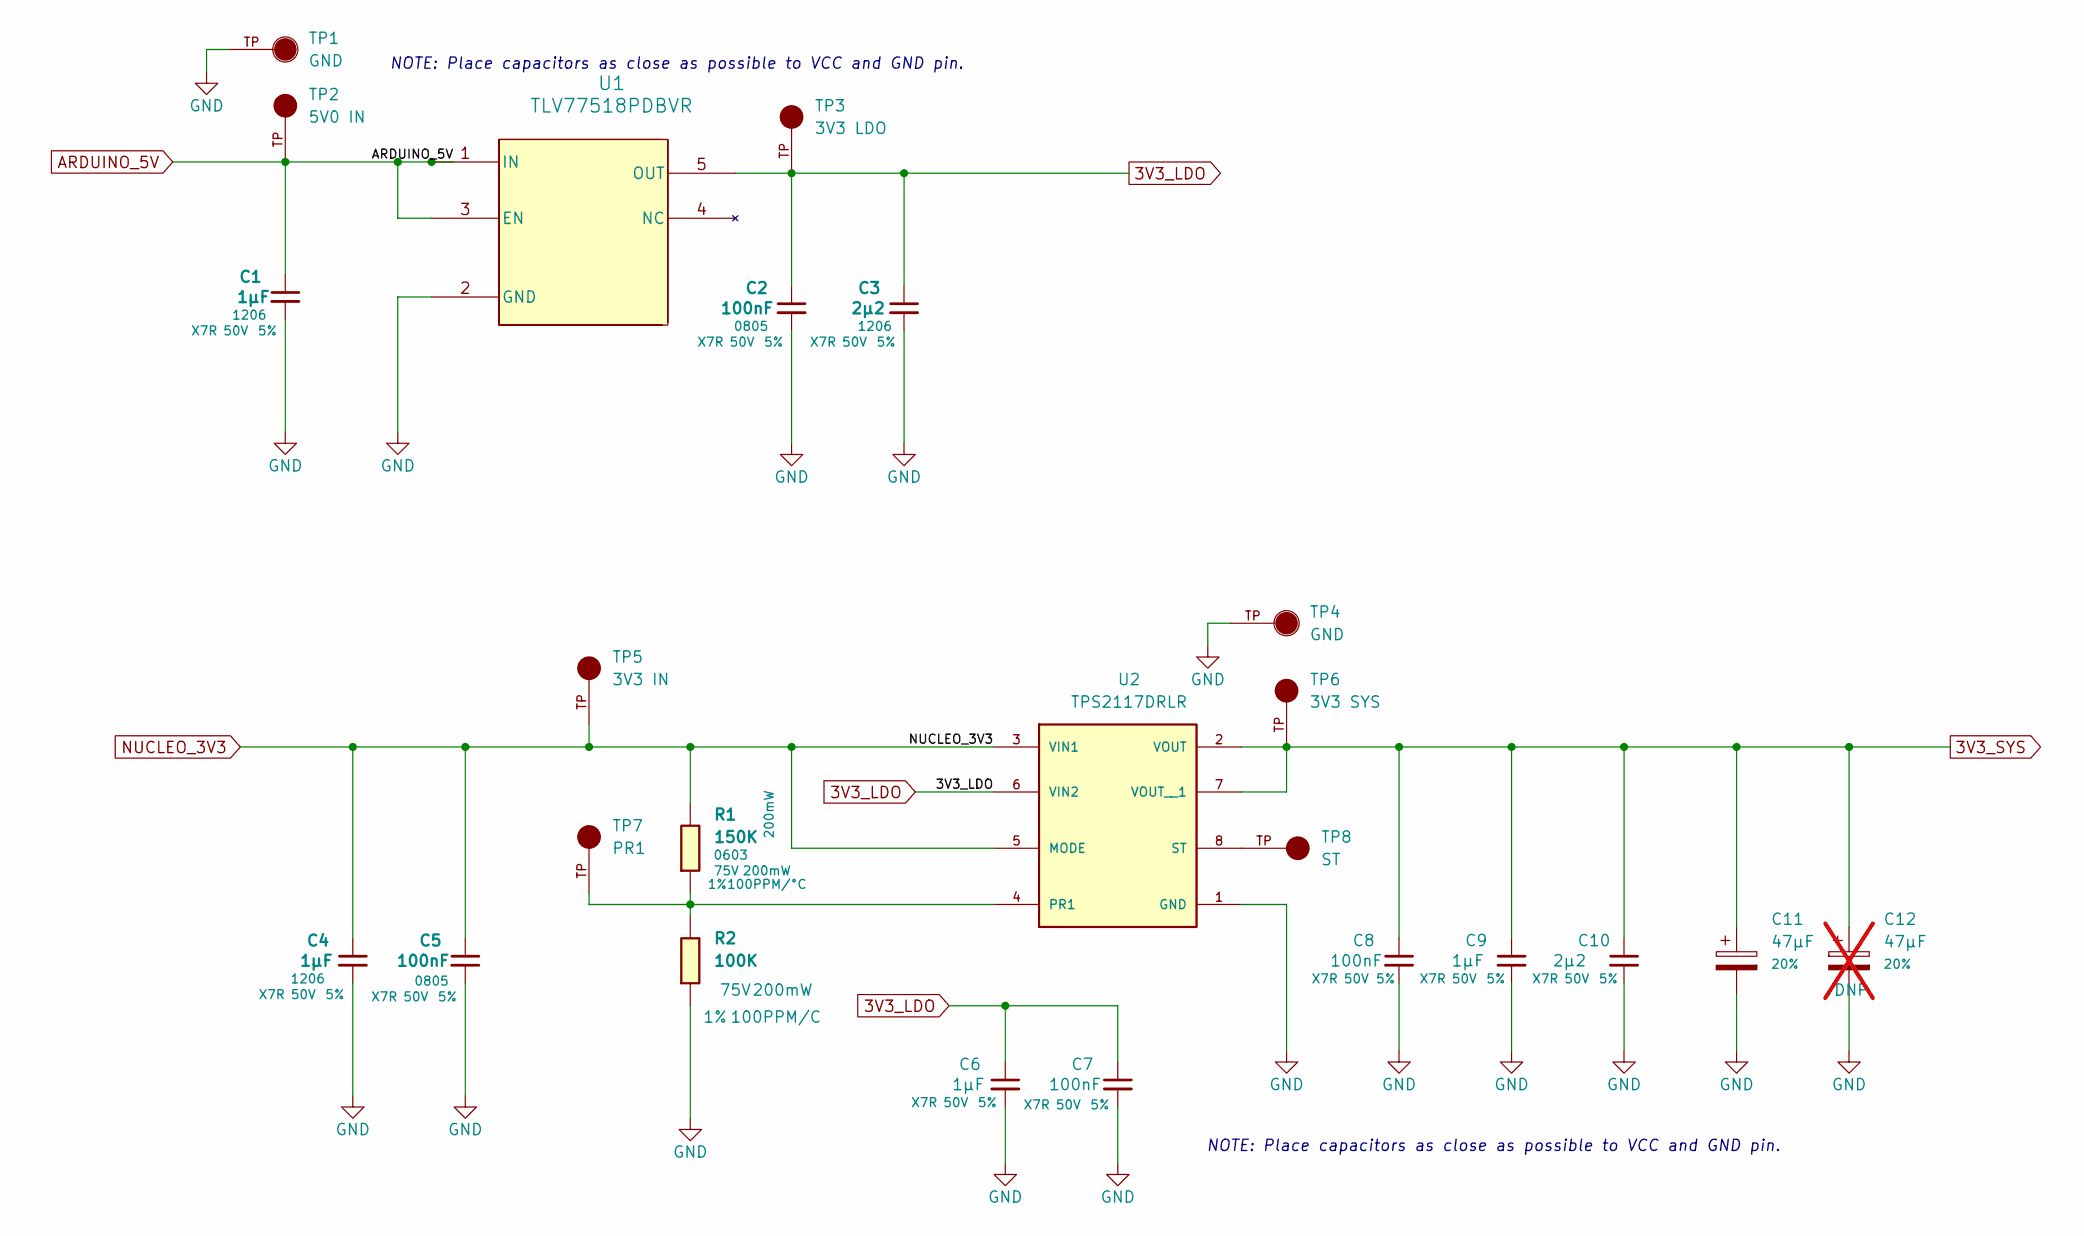
[picture p25: schematic dual_voltage.kicad_sch, STM32 Nucleo RS232 & RS485 Expansion Board V2]

Parts:
C1, C4, C6, C9: 1µF; C_1206_3216Metric; Voltage 50V; Tolerance 5%; MPN 12065C105JAT2A; LCSC C597503
C2, C5, C8: 100nF; C_0805_2012Metric; Voltage 50V; Tolerance 5%; MPN C0805C104J5RACTU; LCSC C2167095
C3, C10: 2µ2; C_1206_3216Metric; Voltage 50V; Tolerance 5%; MPN C1206C225J5RECAUTO; LCSC C1513220
C7: 100nF; C_0805_2012Metric; Voltage Rating 50V; Voltage 50V; MPN C0805C104J5RACTU; LCSC C2167095
C11: 47µF; CAP_EEEFT1H470AP; Voltage Rating 50V; Tolerance 20%; MPN EEEFT1H470AP; LCSC C92059
C12: 47µF; CAP_EEEFT1H470AP; Voltage Rating 50V; Tolerance 20%; MPN EEEFT1H470AP; LCSC C92059; not fitted
R1: 150K; R_0603; Voltage 75V; Tolerance 1%; MPN AC0603FR-7W150KL; LCSC C20142013
R2: 100K; R_0603; Voltage 75V; Tolerance 1%; MPN AC0603FR-7W100KL; LCSC C5552302
TP1, TP4: GND; KEYSTONE_5006; PARTREV F; LCSC C2906764
TP2: 5V0 IN; KEYSTONE_5005; PARTREV F; LCSC C2906763
TP3: 3V3 LDO; KEYSTONE_5005; PARTREV F; LCSC C2906763
TP5: 3V3 IN; KEYSTONE_5005; PARTREV F; LCSC C2906763
TP6: 3V3 SYS; KEYSTONE_5005; PARTREV F; LCSC C2906763
TP7: PR1; KEYSTONE_5005; PARTREV F; LCSC C2906763
TP8: ST; KEYSTONE_5005; PARTREV F; LCSC C2906763
U1: TLV77518PDBVR; SOT-23-5_1P75X3P05_TEX; MPN TLV77518PDBVR; LCSC C49292340
U2: TPS2117DRLR; SOTFL50P160X60-8N; PARTREV A; LCSC C22399676

Connections:
3V3_LDO: C2.1, C3.1, C6.1, C7.1, TP3.TP, U1.5 (OUT), U2.6 (VIN2)
3V3_SYS: C8.1, C9.1, C10.1, C11.1, C12.1, TP6.TP, U2.2 (VOUT), U2.7 (VOUT__1); also elsewhere on the board
ARDUINO_5V: C1.1, TP2.TP, U1.1 (IN), U1.3 (EN); also elsewhere on the board
GND: C1.2, C2.2, C3.2, C4.2, C5.2, C6.2, C7.2, C8.2, C9.2, C10.2, C11.2, C12.2, R2.2, TP1.TP, TP4.TP, U1.2 (GND), U2.1 (GND); also elsewhere on the board
NUCLEO_3V3: C4.1, C5.1, R1.1, TP5.TP, U2.3 (VIN1), U2.5 (MODE); also elsewhere on the board
unnamed: R1.2, R2.1, TP7.TP, U2.4 (PR1)
unnamed: TP8.TP, U2.8 (ST)

Notes on the sheet:
NOTE: Place capacitors as close as possible to VCC and GND pin.

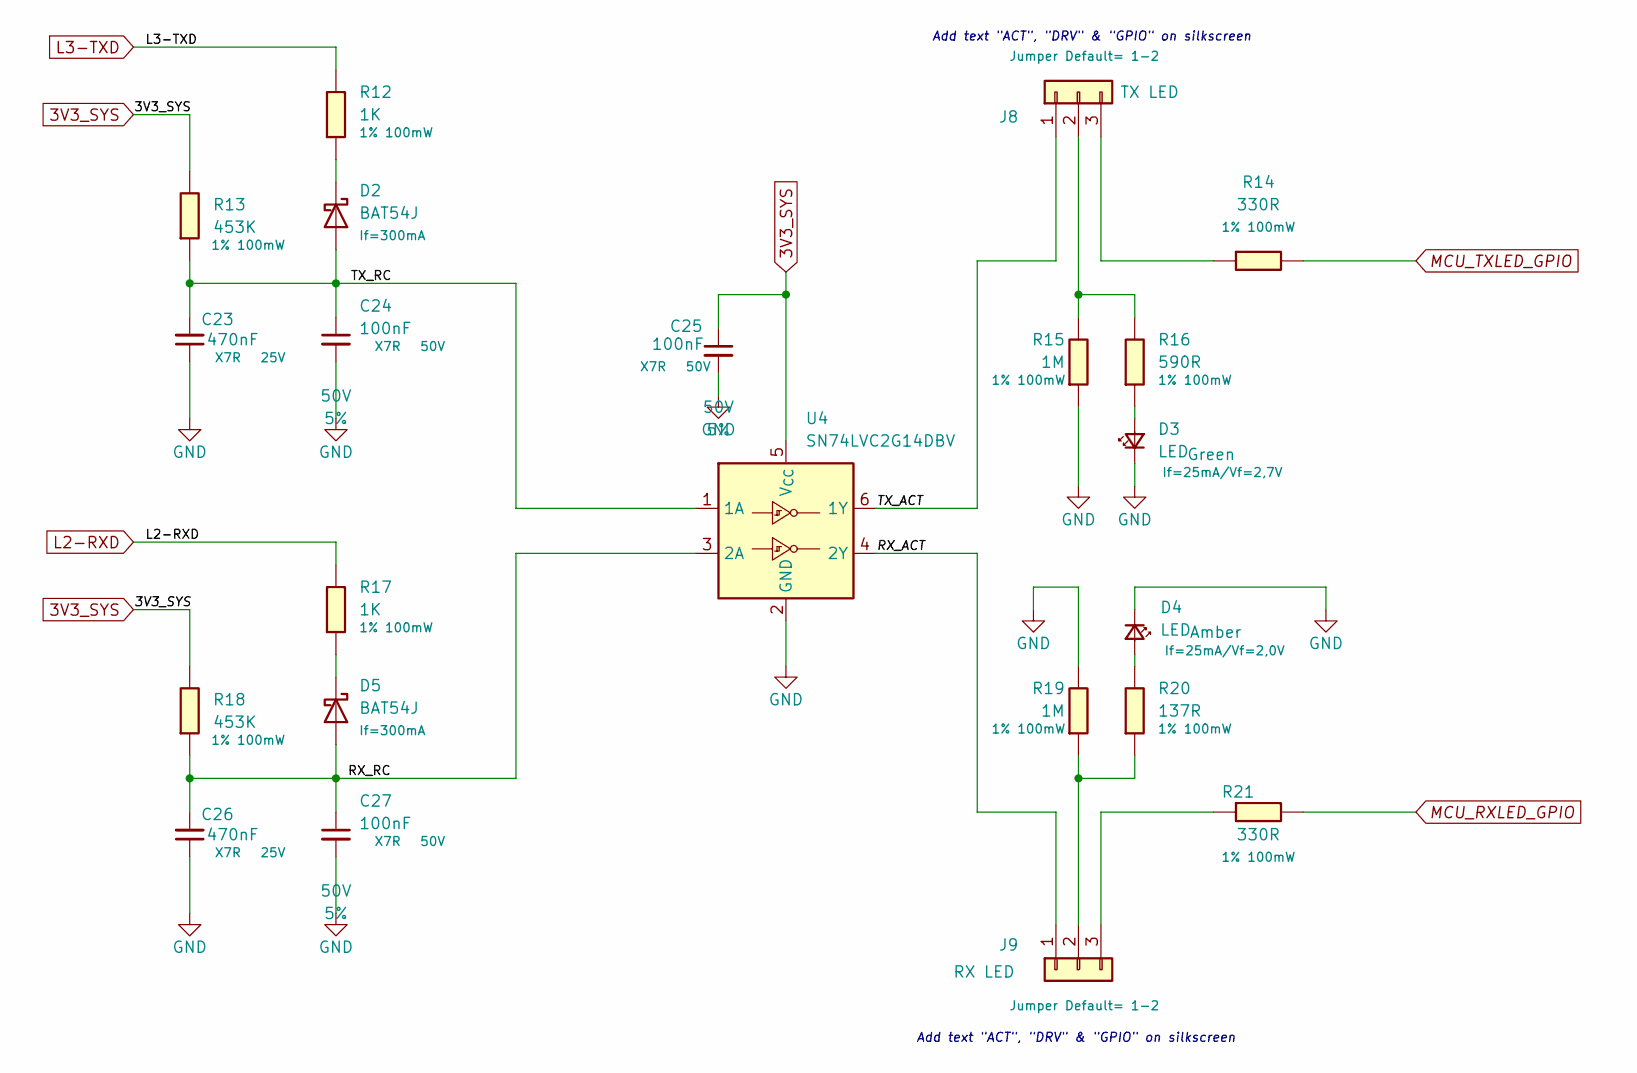
[picture p26: schematic RX_TX_LED.kicad_sch, STM32 Nucleo RS232 & RS485 Expansion Board V2]

Parts:
C23, C26: 470nF; C_0805_2012Metric; Voltage Rating 25V; Voltage 50V; MPN 08055C474JAT2A; LCSC C14663
C24, C25, C27: 100nF; C_0805_2012Metric; Voltage Rating 50V; Voltage 50V; MPN C0805C104J5RACTU; LCSC C2167095
D2, D5: BAT54J; D_SOD-323F; Voltage Rating If=300mA; Voltage 40V; MPN BAT54JFILM; LCSC C86299
D3: LED; LED_0603_WRE; Voltage Rating If=25mA/Vf=2,7V; Voltage 2,7V; MPN IN-S63AT5G; LCSC C5656662
D4: LED; LED_0603_WRE; Voltage Rating If=25mA/Vf=2,0V; Voltage 2,0V; MPN IN-S63AT5A; LCSC C5656657
J8: TX LED; Samtec HTSW-103-07-F-S; Voltage Rating Jumper Default= 1-2; MPN HTSW-103-07-F-S; LCSC C5714562
J9: RX LED; Samtec HTSW-103-07-F-S; Voltage Rating Jumper Default= 1-2; MPN HTSW-103-07-F-S; LCSC C5714562
R12, R17: 1K; R_0603; Voltage Rating 1% 100mW; MPN AC0603FR-7W1KL; LCSC C6113732
R13, R18: 453K; R_0603; Voltage Rating 1% 100mW; MPN AC0603FR-07453KL; LCSC C227908
R14, R21: 330R; R_0603; Voltage Rating 1% 100mW; MPN AC0603FR-7W330RL; LCSC C513549
R15, R19: 1M; R_0603; Voltage Rating 1% 100mW; MPN AC0603FR-7W1ML; LCSC C20142017
R16: 590R; R_0603; Voltage Rating 1% 100mW; MPN AC0603FR-07590RL; LCSC C227973
R20: 137R; R_0603; Voltage Rating 1% 100mW; MPN AC0603FR-07137KL; LCSC C227579
U4: SN74LVC2G14DBV; SOT-23-6; MPN SN74LVC2G14DBVR; LCSC C12401

Connections:
3V3_SYS: C25.1, R13.1, R18.1, U4.5 (V_{CC}); also elsewhere on the board
/Rx & Tx LED/RX_ACT: J9.1, U4.4 (2Y)
/Rx & Tx LED/RX_RC: C26.2, C27.1, D5.2 (A), R18.2, U4.3 (2A)
/Rx & Tx LED/TX_ACT: J8.1, U4.6 (1Y)
/Rx & Tx LED/TX_RC: C23.2, C24.1, D2.2 (A), R13.2, U4.1 (1A)
GND: C23.1, C24.2, C25.2, C26.1, C27.2, D3.1 (K), D4.1 (K), R15.2, R19.1, U4.2 (GND); also elsewhere on the board
L2-RXD: R17.1; also elsewhere on the board
L3-TXD: R12.1; also elsewhere on the board
MCU_RXLED_GPIO: R21.1; also elsewhere on the board
MCU_TXLED_GPIO: R14.1; also elsewhere on the board
unnamed: D2.1 (K), R12.2
unnamed: D3.2 (A), R16.2
unnamed: D4.2 (A), R20.1
unnamed: D5.1 (K), R17.2
unnamed: J8.2, R15.1, R16.1
unnamed: J8.3, R14.2
unnamed: J9.2, R19.2, R20.2
unnamed: J9.3, R21.2

Notes on the sheet:
Add text "ACT", "DRV" & "GPIO" on silkscreen
