stefan-R75/STM32-Nucleo-RS232-RS485-Expansion-Board-ST-Zio-and-Arduino-Compatible/01_KiCAD/00_schematics/STM32 Nucleo RS232 & RS485 Expansion Board (ST Zio Compatible) V2/STM32 Nucleo RS232 & RS485 Expansion Board (ST Zio Compatible) V2.kicad_pcb

## KiCad design 01_KiCAD/00_schematics/STM32 Nucleo RS232 & RS485 Expansion Board (ST Zio Compatible) V2/STM32 Nucleo RS232 & RS485 Expansion Board (ST Zio Compatible) V2.kicad_pcb (continued)

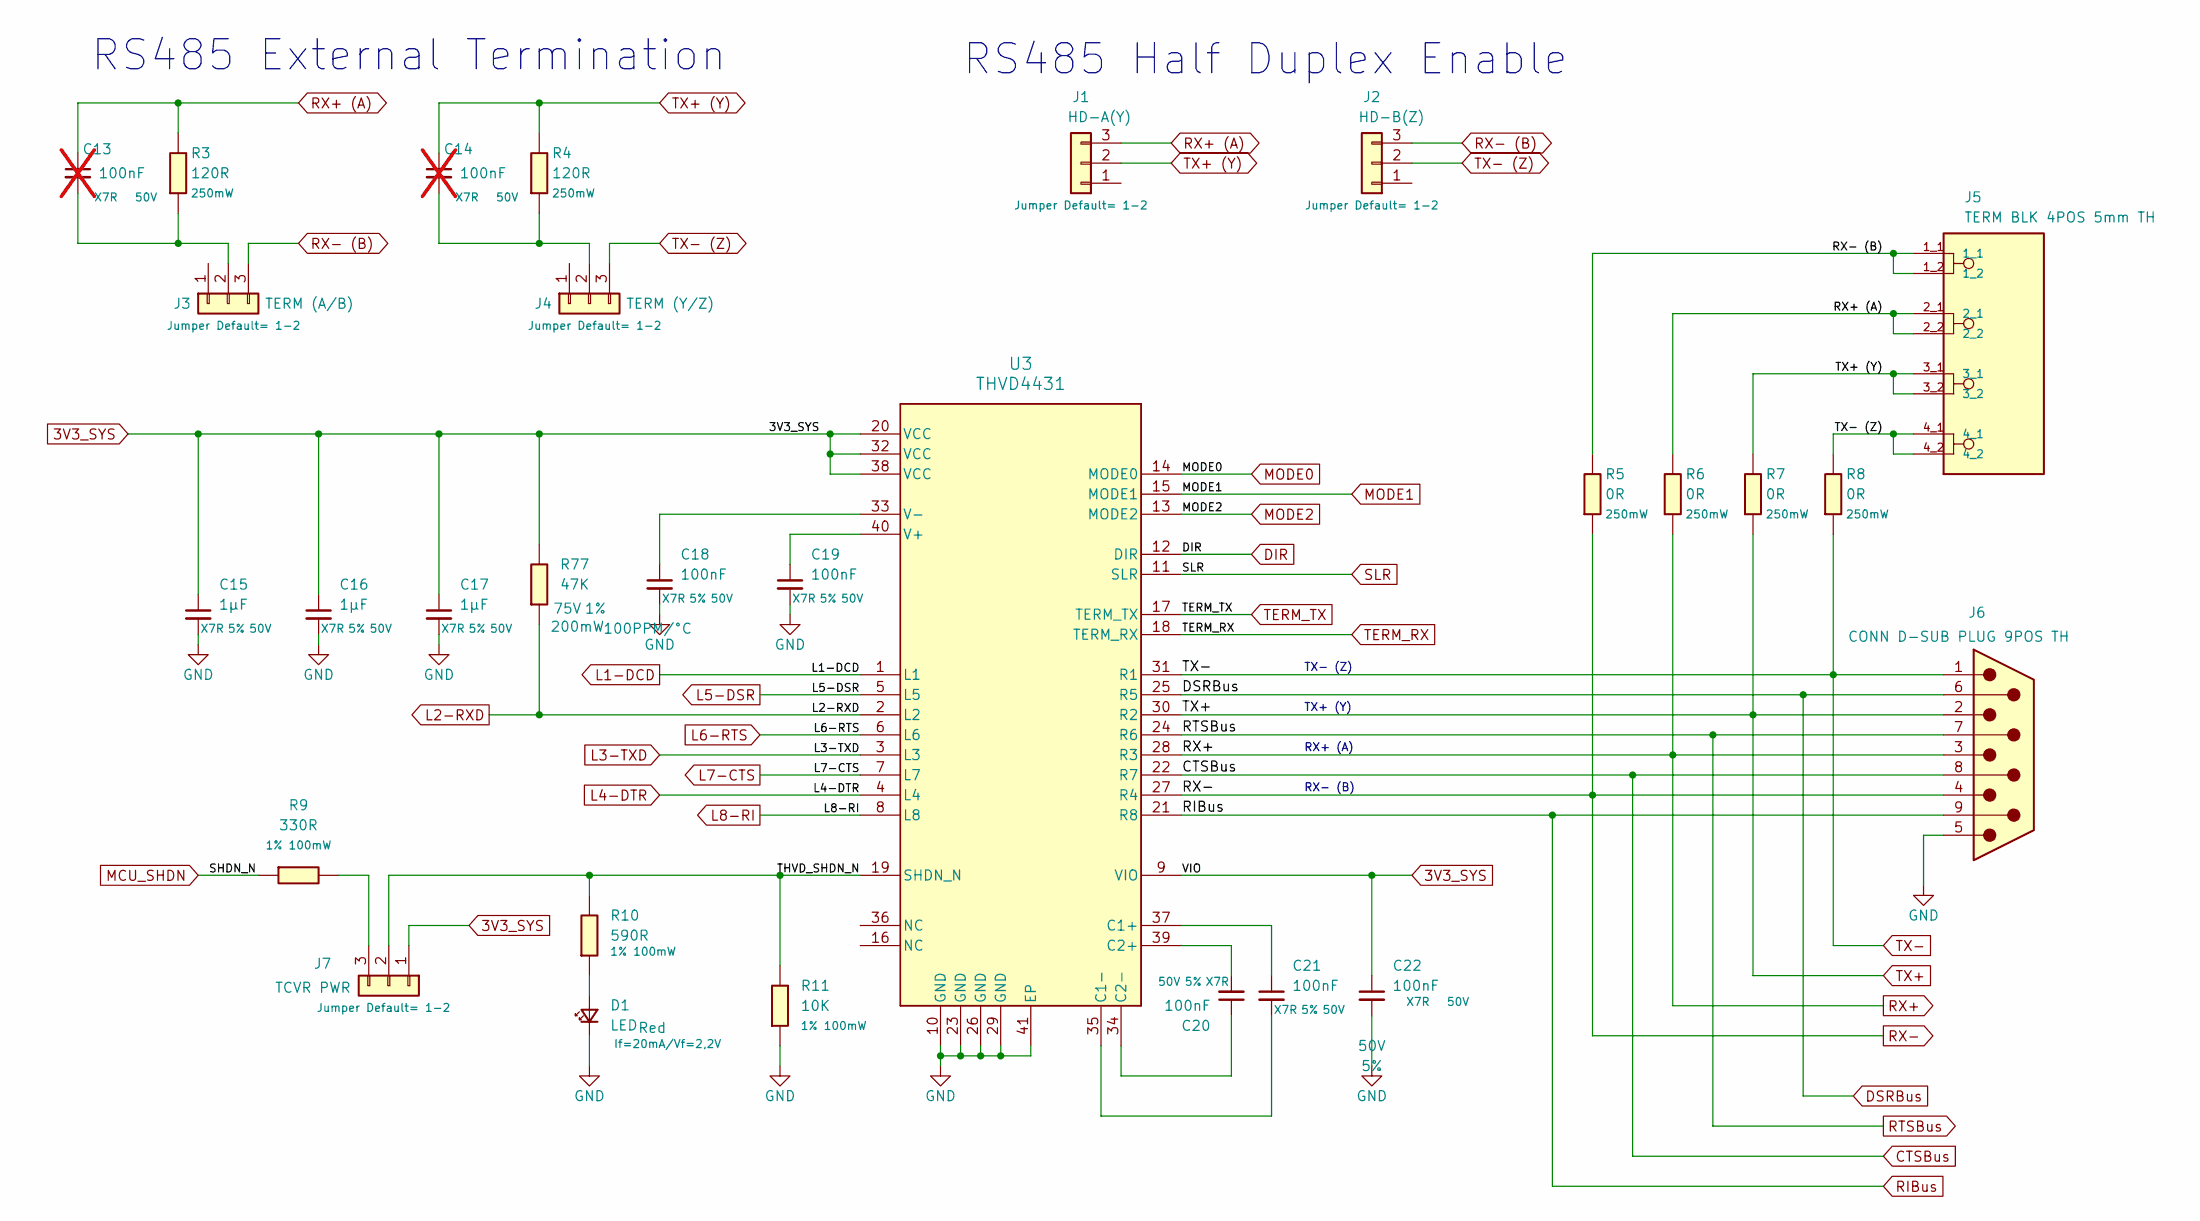
[picture p27: schematic RS232_RS485.kicad_sch, STM32 Nucleo RS232 & RS485 Expansion Board V2]

Parts:
C13, C14: 100nF; C_0805_2012Metric; Voltage Rating 50V; Voltage 50V; MPN C0805C104J5RACTU; LCSC C2167095; not fitted
C15, C16, C17: 1µF; C_1206_3216Metric; Voltage 50V; Tolerance 5%; MPN 12065C105JAT2A; LCSC C597503
C18, C19, C20, C21: 100nF; C_0805_2012Metric; Voltage 50V; Tolerance 5%; MPN C0805C104J5RACTU; LCSC C2167095
C22: 100nF; C_0805_2012Metric; Voltage Rating 50V; Voltage 50V; MPN C0805C104J5RACTU; LCSC C2167095
D1: LED; LED_0603_WRE; Voltage Rating If=20mA/Vf=2,2V; Voltage 2,2V; MPN IN-S63ATR; LCSC C6639626
J1: HD-A(Y); Samtec HTSW-103-07-F-S; Voltage Rating Jumper Default= 1-2; MPN HTSW-103-07-G-S; LCSC C5714562
J2: HD-B(Z); Samtec HTSW-103-07-F-S; Voltage Rating Jumper Default= 1-2; MPN HTSW-103-07-F-S; LCSC C5714562
J3: TERM (A/B); Samtec HTSW-103-07-F-S; Voltage Rating Jumper Default= 1-2; MPN HTSW-103-07-F-S; LCSC C5714562
J4: TERM (Y/Z); Samtec HTSW-103-07-F-S; Voltage Rating Jumper Default= 1-2; MPN HTSW-103-07-F-S; LCSC C5714562
J5: TERM BLK 4POS 5mm TH; PHOENIX_1190299; MPN 1190299; LCSC C3309834
J6: CONN D-SUB PLUG 9POS TH; CONN9_2301843-2_TEC; MPN 2301843-2; LCSC C591554
J7: TCVR PWR; Samtec HTSW-103-07-F-S; Voltage Rating Jumper Default= 1-2; MPN HTSW-103-07-F-S; LCSC C5714562
R3, R4: 120R; R_0603; Voltage Rating 250mW; MPN AC0603FR-7W120RL; LCSC C5552306
R5, R6, R7, R8: 0R; R_0805_2012Metric; Voltage Rating 250mW; MPN CRCW08050000Z0EAHP; LCSC C844811
R9: 330R; R_0603; Voltage Rating 1% 100mW; MPN AC0603FR-7W330RL; LCSC C513549
R10: 590R; R_0603; Voltage Rating 1% 100mW; MPN AC0603FR-07590RL; LCSC C227973
R11: 10K; R_0603; Voltage Rating 1% 100mW; MPN AC0603FR-7W10KL; LCSC C20142011
R77: 47K; R_0603; Voltage 75V; Tolerance 1%; MPN AC0603FR-7W47KL; LCSC C6732920
U3: THVD4431; RHA0040R-MFG; MPN THVD4431RHAR; LCSC C22445427

Connections:
3V3_SYS: C15.1, C16.1, C17.1, C22.1, J7.1, R77.1, U3.9 (VIO), U3.20 (VCC), U3.32 (VCC), U3.38 (VCC); also elsewhere on the board
/RS232 & RS485 Tranceiver/THVD_SHDN_N: J7.2, R10.1, R11.1, U3.19 (SHDN_N)
CTSBus: J6.8, U3.22 (R7); also elsewhere on the board
DIR: U3.12 (DIR); also elsewhere on the board
DSRBus: J6.6, U3.25 (R5); also elsewhere on the board
GND: C15.2, C16.2, C17.2, C18.2, C19.2, C22.2, D1.1 (K), J6.5, R11.2, U3.10 (GND), U3.23 (GND), U3.26 (GND), U3.29 (GND), U3.41 (EP); also elsewhere on the board
L1-DCD: U3.1 (L1); also elsewhere on the board
L2-RXD: R77.2, U3.2 (L2); also elsewhere on the board
L3-TXD: U3.3 (L3); also elsewhere on the board
L4-DTR: U3.4 (L4); also elsewhere on the board
L5-DSR: U3.5 (L5); also elsewhere on the board
L6-RTS: U3.6 (L6); also elsewhere on the board
L7-CTS: U3.7 (L7); also elsewhere on the board
L8-RI: U3.8 (L8); also elsewhere on the board
MCU_SHDN: R9.2; also elsewhere on the board
MODE0: U3.14 (MODE0); also elsewhere on the board
MODE1: U3.15 (MODE1); also elsewhere on the board
MODE2: U3.13 (MODE2); also elsewhere on the board
unnamed: D1.2 (A), R10.2
unnamed: C13.2, J3.2, R3.2
unnamed: C14.2, J4.2, R4.2
unnamed: J7.3, R9.1
unnamed: C21.1, U3.37 (C1+)
unnamed: C21.2, U3.35 (C1-)
unnamed: C20.2, U3.39 (C2+)
unnamed: C20.1, U3.34 (C2-)
unnamed: C19.1, U3.40 (V+)
unnamed: C18.1, U3.33 (V-)
RIBus: J6.9, U3.21 (R8); also elsewhere on the board
RTSBus: J6.7, U3.24 (R6); also elsewhere on the board
RX+: J6.3, R6.2, U3.28 (R3); also elsewhere on the board
RX+ (A): C13.1, J1.3, J5.2_1, J5.2_2, R3.1, R6.1; also elsewhere on the board
RX-: J6.4, R5.2, U3.27 (R4); also elsewhere on the board
RX- (B): J2.3, J3.3, J5.1_1, J5.1_2, R5.1; also elsewhere on the board
SLR: U3.11 (SLR); also elsewhere on the board
TERM_RX: U3.18 (TERM_RX); also elsewhere on the board
TERM_TX: U3.17 (TERM_TX); also elsewhere on the board
TX+: J6.2, R7.2, U3.30 (R2); also elsewhere on the board
TX+ (Y): C14.1, J1.2, J5.3_1, J5.3_2, R4.1, R7.1; also elsewhere on the board
TX-: J6.1, R8.2, U3.31 (R1); also elsewhere on the board
TX- (Z): J2.2, J4.3, J5.4_1, J5.4_2, R8.1; also elsewhere on the board

Notes on the sheet:
RX- (B)
TX- (Z)
RX+ (A)
TX+ (Y)
RS485 Half Duplex Enable
RS485 External Termination

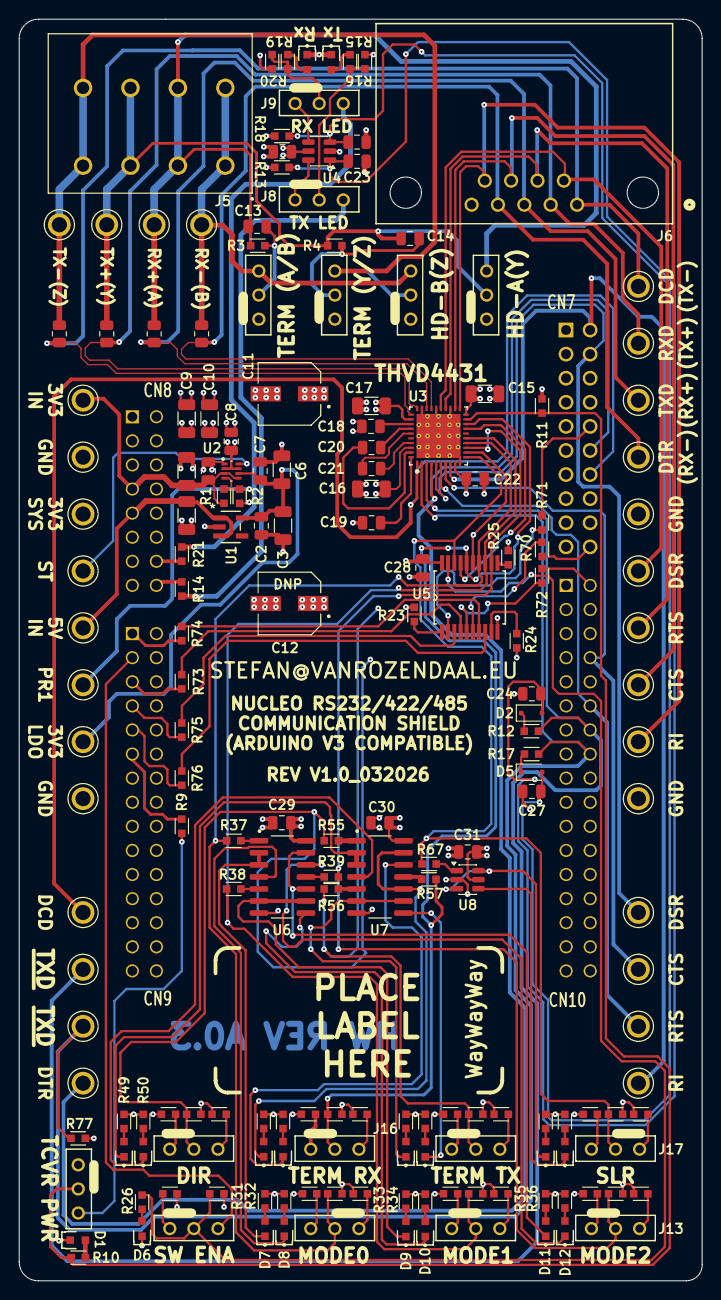
[picture p28: board STM32 Nucleo RS232 & RS485 Expansion Board (ST Zio Compatible) V2.kic… from above]

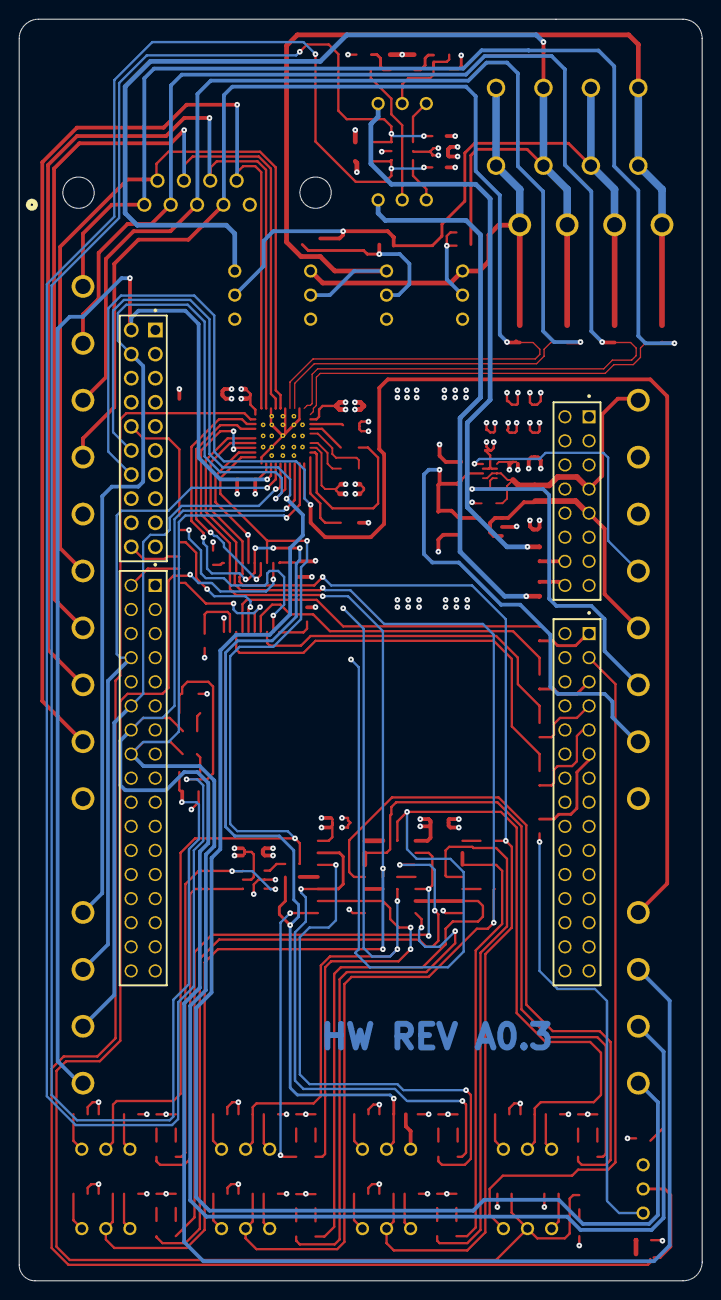
[picture p29: board STM32 Nucleo RS232 & RS485 Expansion Board (ST Zio Compatible) V2.kic… from below]

Board: 4 copper layers, 72.0 x 133.0 mm, 187 parts (4 on the bottom side), 130 nets.
