stefan-R75/STM32-Nucleo-RS232-RS485-Expansion-Board-ST-Zio-and-Arduino-Compatible/(commit log)

2026-02-04 initial commit
    initial commit
    [HW_Jumper_Selection.kicad_sch, Multiple_IO_Input.kicad_sch, RS232_RS485.kicad_sch, RX_TX_LED.kicad_sch, STM32 Nucleo RS232 & RS485 Expansion Board (ST Zio Compatible) V2.kicad_pcb, STM32 Nucleo RS232 & RS485 Expansion Board (ST Zio Compatible) V2.kicad_sch, ZIO_Compatible_Connector.kicad_sch]
2026-02-04 Removed LED
    LED verwijderd dat gebruikt werd voor GitHub Test
    [RX_TX_LED.kicad_sch]
2026-02-04 Add THVD4431 & Phoenic 4-p connector
    Added the THVD4431 dual Tranceiver Chip and modified schematic symbol.
    Added the RS485 Phoenix Contact connector (pn 1190299)
    [RS232_RS485.kicad_sch]
2026-02-04 Added SubD 9-P connector
    Added the RS232 SubD connector
    [RS232_RS485.kicad_sch]
2026-02-04 Added components
    Added R1 - R4 0R pass-through resistors for RS485 data lines to seperate them from RS232 Net
    Added capacitors C1+ and C2+ for charge pump
    Completed table on root page for THVD4431 and ZIO Connector Pin Layout
    [RS232_RS485.kicad_sch, STM32 Nucleo RS232 & RS485 Expansion Board (ST Zio Compatible) V2.kicad_sch, c-2301843-2-b-3d.iges, c-2301843-2-b-3d.stl, c-2301843-2-b-3d.stp]
2026-02-05 Complemented descriptions
    Complemented the RS232, RS485 and THVD4431 description table on the Root page
    [RS232_RS485.kicad_sch, STM32 Nucleo RS232 & RS485 Expansion Board (ST Zio Compatible) V2.kicad_sch]
2026-02-05 Added SHDN logic
    Added the SHDN pin logic to have both hardware control and software control vor activating the THVD4431
    [RS232_RS485.kicad_sch, RX_TX_LED.kicad_sch, ZIO_Compatible_Connector.kicad_sch]
2026-02-06 Added Dual Voltage Input
    Added Dual Voltage Auto Select Input drawings. Added new hierarchical sheet with new pagenumber one. All other pages have been moved up by 1.
    [RS232_RS485.kicad_sch, RX_TX_LED.kicad_sch, STM32 Nucleo RS232 & RS485 Expansion Board (ST Zio Compatible) V2.kicad_sch, ZIO_Compatible_Connector.kicad_sch, dual_voltage.kicad_sch]
2026-02-07 Added components and change device
    Added dual Schmidt trigger input SN74LVC2G14DBV for LED Rx and Tx control.
    Changed sn74hcs245 for alternate part sn74lvc245a for larger footprint and better availability with LCSC.
    Difference is sn74lvc245a has no Schmidt-trigger inputs but instead just normal inputs. Fot details see dataseet. Both devices use exact same pin number and configuration except sn74lvc245a has no thermal pad or exposed pad like the sn74hcs245 has.
    [HW_Jumper_Selection.kicad_sch, Multiple_IO_Input.kicad_sch, RS232_RS485.kicad_sch, RX_TX_LED.kicad_sch, ZIO_Compatible_Connector.kicad_sch, dual_voltage.kicad_sch]
2026-02-08 Finisching touches to schematics
    Finalizing the schematics and double-check all connections throughout the different sheets.
    [HW_Jumper_Selection.kicad_sch, Multiple_IO_Input.kicad_sch, RS232_RS485.kicad_sch, RX_TX_LED.kicad_sch, STM32 Nucleo RS232 & RS485 Expansion Board (ST Zio Compatible) V2.kicad_sch, ZIO_Compatible_Connector.kicad_sch, dual_voltage.kicad_sch]
2026-02-08 Finishing up the schematic aand created the board outline
    Made some finishing touches to the schematic, updated all the symbol footprints and started to create the board.
    Added missing 3D models for Phoenix 4-p RS485 connector and RS232 connector, also for Inolux LED.
    [EEEHD1H101P.step, HQ NextPCB Advanced.kicad_pcb, HQ NextPCB Simple.kicad_pcb, HW_Jumper_Selection.kicad_sch, JLCPCB.kicad_pcb, JLCPCB.kicad_sch, KiCAD_Custom_DRC_Rules_for_PCBWay.kicad_pcb, KiCAD_Custom_DRC_Rules_for_PCBWay.kicad_sch]
2026-02-09 Corrected RS485 connector layout
    Corrected the layout and connections to Phoenix Contacts connector J1 so pairs are next to eachother and simplyfied the board layout to better match the THVD4431 connections.
    Added some 3D models to the testpoints TP10, TP12, TP14 and TP16. Made color-coding for the RS485 pairs so they are easily identified as pairs belong to eachother.
    [RS232_RS485.kicad_sch, STM32 Nucleo RS232 & RS485 Expansion Board (ST Zio Compatible) V2.kicad_pcb]
2026-02-09 Added 3D models for TI Devices
    Added 3D models for the TI SN74LVC245A and THVD4431 devices
    [STM32 Nucleo RS232 & RS485 Expansion Board (ST Zio Compatible) V2.kicad_pcb]
2026-02-09 Capacitor change
    Changed designator values for C1 t/m C7 so it is more logical on the sheet.
    Changed capacittor C7 from 100µF to lower part of 47µF because of mechanical reasons. Old capacitor was too high and new capacitor of 47µ is just about 5-6mm in height
    [STM32 Nucleo RS232 & RS485 Expansion Board (ST Zio Compatible) V2.kicad_pcb, dual_voltage.kicad_sch]
2026-02-10 Updated footprints and added components to PCB
    Added some additional components to the board. Changed the footprint of the 3-pin Jumper so the bottom silkscreen text doesnlt overlap with the Dual Schmidt Trigger IC's SN74LVC2G14
    [HW_Jumper_Selection.kicad_sch, Multiple_IO_Input.kicad_sch, RS232_RS485.kicad_sch, RX_TX_LED.kicad_sch, STM32 Nucleo RS232 & RS485 Expansion Board (ST Zio Compatible) V2.kicad_pcb, ZIO_Compatible_Connector.kicad_sch, dual_voltage.kicad_sch]
2026-02-12 Changed to one-side only
    Changed design to fit all components to top-side of the board inseatd of to both top- and bottom side of the board. This simplifies the manufacturing process and saves costs during assembly.
    [STM32 Nucleo RS232 & RS485 Expansion Board (ST Zio Compatible) V2.kicad_pcb]
2026-02-13 Changed schmitt trigger
    changed the schmitt trigger for hex-schmitt trigger variant to simpify design and reduce components
    [HW_Jumper_Selection.kicad_sch, RX_TX_LED.kicad_sch, STM32 Nucleo RS232 & RS485 Expansion Board (ST Zio Compatible) V2.kicad_pcb, ZIO_Compatible_Connector.kicad_sch]
2026-02-13 Updated PCB
    Updated PCB with components layout and routing tracks.
    [HW_Jumper_Selection.kicad_sch, RX_TX_LED.kicad_sch, STM32 Nucleo RS232 & RS485 Expansion Board (ST Zio Compatible) V2.kicad_pcb]
2026-02-14 Added half-duplex jumpers
    Addres jumpers for hardware RS485 half-duplex configuration combining signals A(Y) & B(Z). Finalising testpoints and added 3D models for each test-point color.
    -Green = logic side
    -Blue = connector side
    Made some minor changed to layout for test signals clarification (THVD4431 sheet)
    [Multiple_IO_Input.kicad_sch, RS232_RS485.kicad_sch, STM32 Nucleo RS232 & RS485 Expansion Board (ST Zio Compatible) V2.kicad_pcb, STM32 Nucleo RS232 & RS485 Expansion Board (ST Zio Compatible) V2.kicad_sch, dual_voltage.kicad_sch]
2026-02-15 Finalizing roting
    Made some final routings and updated Netlist name on the schematics for some of the RS232 testpoints.
    [RS232_RS485.kicad_sch, STM32 Nucleo RS232 & RS485 Expansion Board (ST Zio Compatible) V2.kicad_pcb, dual_voltage.kicad_sch]
2026-02-15 Finalizing PCB Design
    Finalizing track routing on PCB and run DRC. Made some minor silkscreen adjustments.
    [STM32 Nucleo RS232 & RS485 Expansion Board (ST Zio Compatible) V2.csv, STM32 Nucleo RS232 & RS485 Expansion Board (ST Zio Compatible) V2.kicad_pcb, STM32 Nucleo RS232 & RS485 Expansion Board (ST Zio Compatible) V2.kicad_sch, STM32 Nucleo RS232 & RS485 Expansion Board BOM V1_032026.xlsx]
2026-02-17 Complete redesign
    Redesigned the complete board. Added hardware termination jumpers for 1120R resistors for RS485. Changes footprint, package size and simplified values between capacitors.
    Still need to re-route the entire board :-(
    [HW_Jumper_Selection.kicad_sch, Multiple_IO_Input.kicad_sch, RS232_RS485.kicad_sch, RX_TX_LED.kicad_sch, STM32 Nucleo RS232 & RS485 Expansion Board (ST Zio Compatible) V2.csv, STM32 Nucleo RS232 & RS485 Expansion Board (ST Zio Compatible) V2.kicad_pcb, ZIO_Compatible_Connector.kicad_sch, dual_voltage.kicad_sch]
2026-02-18 Updating routing
    Update routing tracks and placing and re-ordering components on the board.
    [HW_Jumper_Selection.kicad_sch, RS232_RS485.kicad_sch, STM32 Nucleo RS232 & RS485 Expansion Board (ST Zio Compatible) V2.kicad_pcb, dual_voltage.kicad_sch]
2026-02-19 Small changes to schematics & PCB work
    Made some minor adjustments to the schematics, updated the PCB accordingly.
    Placed all the components on the board and did some of the routing.
    Updated the 3D models of all the components.
    [HW_Jumper_Selection.kicad_sch, Multiple_IO_Input.kicad_sch, RS232_RS485.kicad_sch, RX_TX_LED.kicad_sch, STM32 Nucleo RS232 & RS485 Expansion Board (ST Zio Compatible) V2.kicad_pcb]
2026-02-20 Finalizing board layout & routing
    Set HW Revision of board to: HW REV A0.1 and placed this as copper text on the back of the PCB.
    Run DRC to see any critical errors. Resolved some minor silkscreen issues with overlapping text.
    [HW_Jumper_Selection.kicad_sch, Multiple_IO_Input.kicad_sch, STM32 Nucleo RS232 & RS485 Expansion Board (ST Zio Compatible) V2.kicad_pcb]
2026-02-21 Updated components
    Updated components descriptions and partnumbers of C1, C2, C3, U1, TP1, TP2 and TP3
    [dual_voltage.kicad_sch]
2026-02-21 Final revision checkup
    After BOM-update and corrected some footprints and package sizes for resistors and capacitors, updated the PCB to "HW REV A0.2" as final PCB layout. Need to run DRC check before final approval.
    [HW_Jumper_Selection.kicad_sch, Multiple_IO_Input.kicad_sch, RS232_RS485.kicad_sch, RX_TX_LED.kicad_sch, STM32 Nucleo RS232 & RS485 Expansion Board (ST Zio Compatible) V2.kicad_pcb, STM32 Nucleo RS232 & RS485 Expansion Board (ST Zio Compatible) V2.kicad_sch, ZIO_Compatible_Connector.kicad_sch, dual_voltage.kicad_sch]
2026-02-22 Updated PCB Layout
    Moved the 4x RS485 testpoints closer to the Phoenix connector so the longer testpoints don't interfere with the added LCD shield when stacked together.
    [STM32 Nucleo RS232 & RS485 Expansion Board (ST Zio Compatible) V2-B_Cu.gbr, STM32 Nucleo RS232 & RS485 Expansion Board (ST Zio Compatible) V2-B_Mask.gbr, STM32 Nucleo RS232 & RS485 Expansion Board (ST Zio Compatible) V2-B_Paste.gbr, STM32 Nucleo RS232 & RS485 Expansion Board (ST Zio Compatible) V2-B_SilkS.gbr, STM32 Nucleo RS232 & RS485 Expansion Board (ST Zio Compatible) V2-Edge_Cuts.gbr, STM32 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]
2026-02-22 Updated PCB
    Re-aligned all testpoints. Set fixed distance of 6mm from each testpoint to neighbour one. Set board outline to match exactly the dimensions of 133x72mm
    [STM32 Nucleo RS232 & RS485 Expansion Board (ST Zio Compatible) V2-B_Cu.gbr, STM32 Nucleo RS232 & RS485 Expansion Board (ST Zio Compatible) V2-B_Mask.gbr, STM32 Nucleo RS232 & RS485 Expansion Board (ST Zio Compatible) V2-B_Paste.gbr, STM32 Nucleo RS232 & RS485 Expansion Board (ST Zio Compatible) V2-B_SilkS.gbr, STM32 Nucleo RS232 & RS485 Expansion Board (ST Zio Compatible) V2-Edge_Cuts.gbr, STM32 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]
2026-02-24 Changed to HR_REVA0.3
    Updates design to PCB HW-REVA0.3 with the folowing changes:
    CL_HW_2026_0001
    Replaced text on silkscreen D3=>RX and D4=>TX.
    CL_HW_2026_0002
    Changed MCU_SHDN pin for THVD4431 from CN9-30 to CN9-11 to make it also Arduino compatible
    [HW_Jumper_Selection.kicad_sch, RS232_RS485.kicad_sch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]
2026-02-24 Finilizing HW_REVA0.3
    See also CL_HW_2026_0003
    Added pull-up resistor to L2 on TI advise
    [RS232_RS485.kicad_sch, STM32 Nucleo RS232 & RS485 Expansion Board (ST Zio Compatible) V2.kicad_pcb, STM32 Nucleo RS232 & RS485 Expansion Board (ST Zio Compatible) V2.kicad_pcb_bom.csv, STM32 Nucleo RS232 & RS485 Expansion Board (ST Zio Compatible) V2.kicad_pcb_positions.csv]
2026-02-25 board setup
    [STM32 Nucleo RS232 & RS485 Expansion Board (ST Zio Compatible) V2.kicad_pcb]
2026-02-25 Siklscreen update
    Found some late issues with the silkscreen tekst.
    Corrected "5V EXT" to "5V IN", matching the 3V3 IN testpoint.
    Corrected the "5V EXT" testpoint to the correct name "3V3 LDO".
    Fixed overall text positions to be a minimum of 1mm height and 0.2mm thickness. Corrected the BOM list for PCBWay Manufacturing and assembly. 137Ω resistor was wrongfully set as 137KΩ. Corrected this to Vishay 137Ω 100mW resistor for Amber LED.
    [STM32 Nucleo RS232 & RS485 Expansion Board (ST Zio Compatible) V2.kicad_pcb, STM32 Nucleo RS232 & RS485 Expansion Board (ST Zio Compatible) V2.kicad_pcb_positions.csv]
2026-09-22 Delete 05-Documents/~$ofddocument – Rs232 & Rs485 Expansion Board Voor Nucleo-h753zi.docx
    Clean-up documents not needed or duplicates
