stefan-R75/STM32-Nucleo-RS232-RS485-Expansion-Board-ST-Zio-and-Arduino-Compatible/(notices)

Notices in the files:
01_KiCAD/00_schematics/STM32 Nucleo RS232 & RS485 Expansion Board (ST Zio Compatible) V2/Multiple_IO_Input.kicad_sch:
Licensed under GNU GPL v3.0 or later
